tekfufu/mini-R2D2/Flex Wheels/Mini Flex Wheel Print Settings.txt

Print Settings (no supports needed)

Wheel
PLA+ or similar
30% infill and 3 walls minimum

Flex Tyre
I used Flex filament, rubber like filament or similar
Pretty much print it solid as they are so small
