tekfufu/mini-R2D2/Flex Wheels/image 1.png

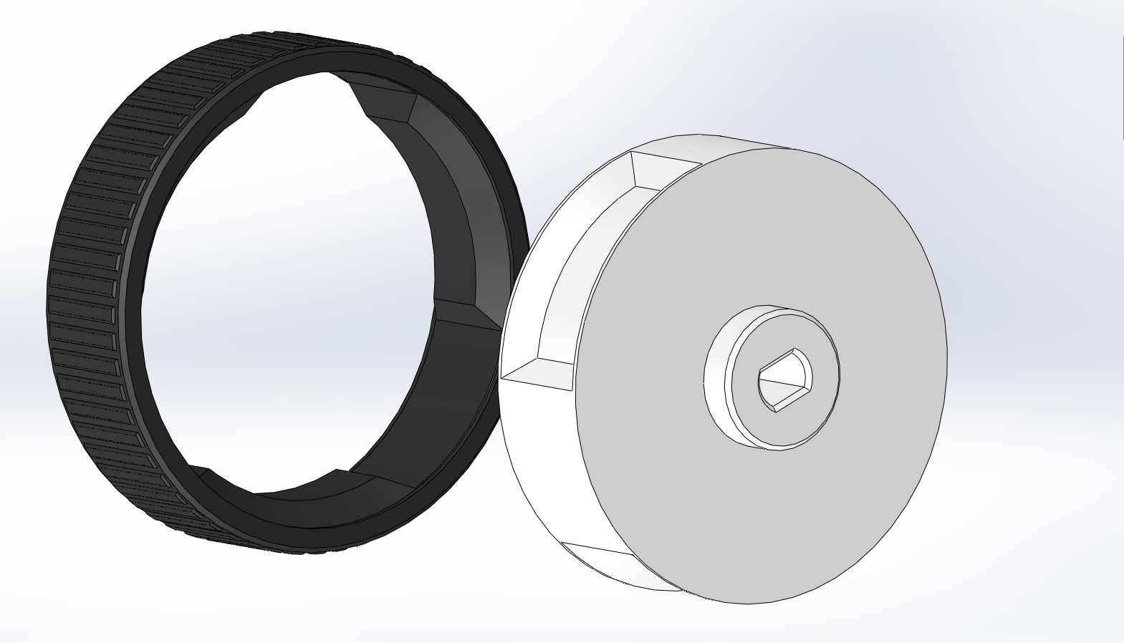
Flex Wheels/image 1.png
