tekfufu/mini-R2D2/Flex Wheels/image.png

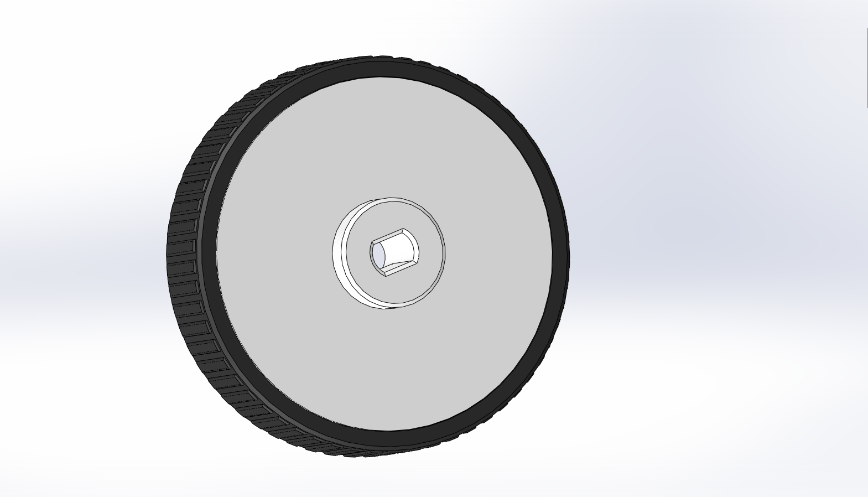
Flex Wheels/image.png
