tekfufu/mini-R2D2/Mini 2-3-2 R2-D2/Reference Images/Mini 2-3-2 2.JPG

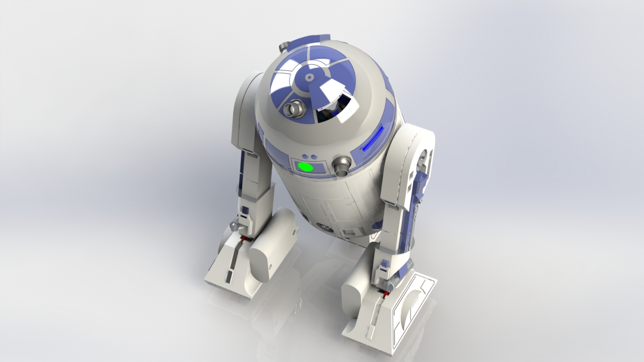
Mini 2-3-2 R2-D2/Reference Images/Mini 2-3-2 2.JPG
