tekfufu/mini-R2D2/Mini 2-3-2 R2-D2/Reference Images/Periscope 1.JPG

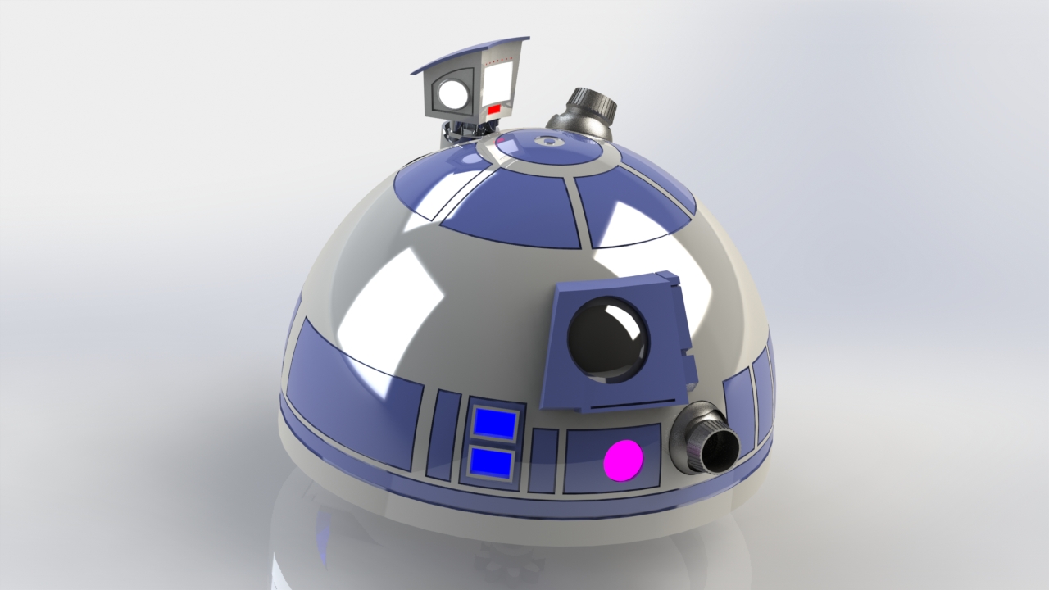
Mini 2-3-2 R2-D2/Reference Images/Periscope 1.JPG
