tekfufu/mini-R2D2/Mini 2-3-2 R2-D2/STL_s/Dome with Periscope/Moveable Holos/Moveable Holo.JPG

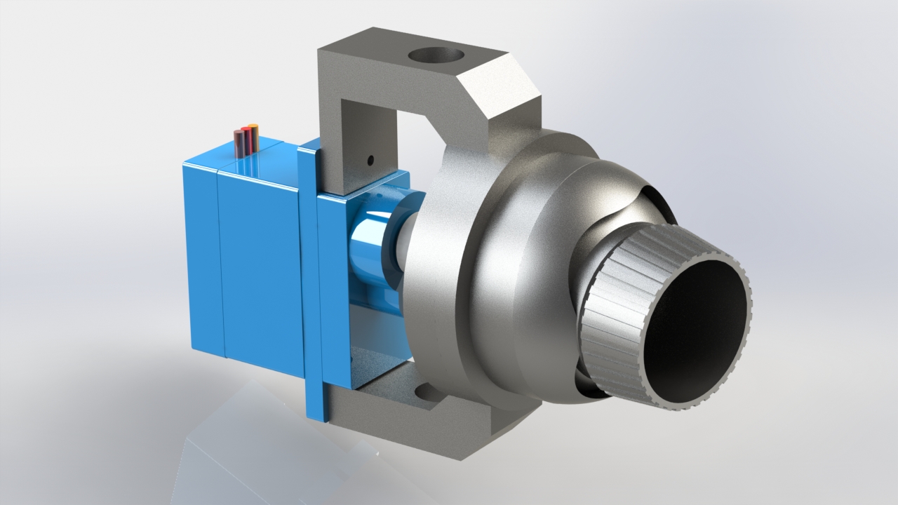
Mini 2-3-2 R2-D2/STL_s/Dome with Periscope/Moveable Holos/Moveable Holo.JPG
