tekfufu/mini-R2D2/Mini 2-3-2 R2-D2/STL_s/Omniwheels/image.png

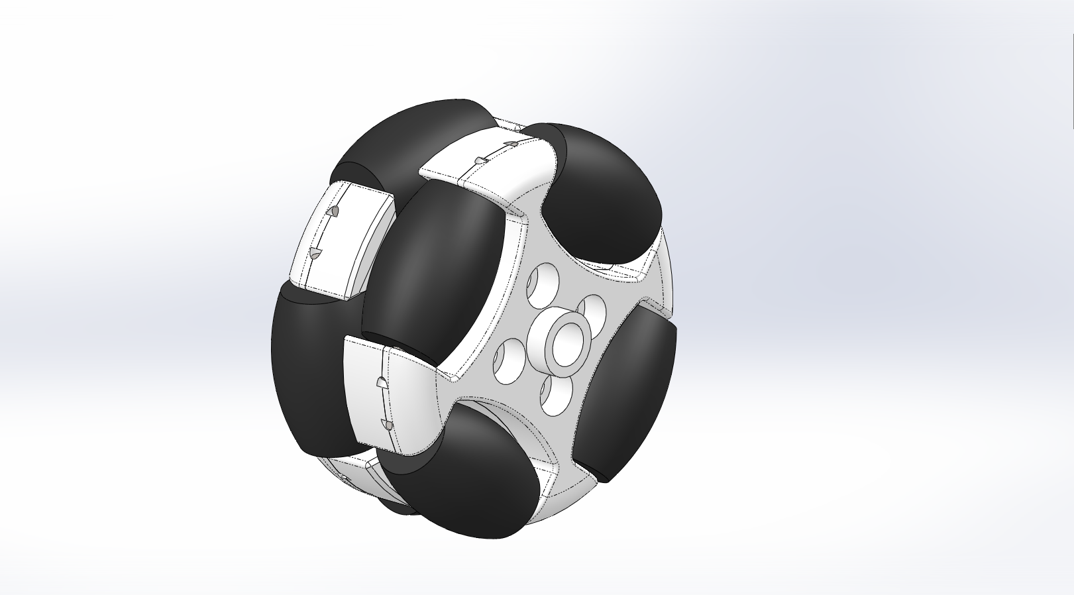
Mini 2-3-2 R2-D2/STL_s/Omniwheels/image.png
