tekfufu/mini-R2D2/Mini R2/R2 Body with moveable front arms/R2 Front Arm.png

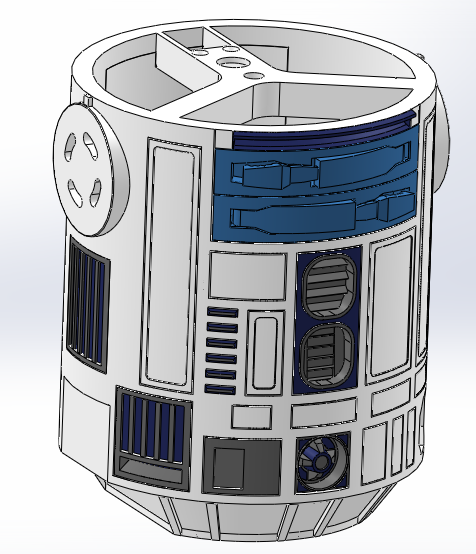
Mini R2/R2 Body with moveable front arms/R2 Front Arm.png
