tekfufu/mini-R2D2/Mini R2/R2 Body/R2-D2 Body.JPG

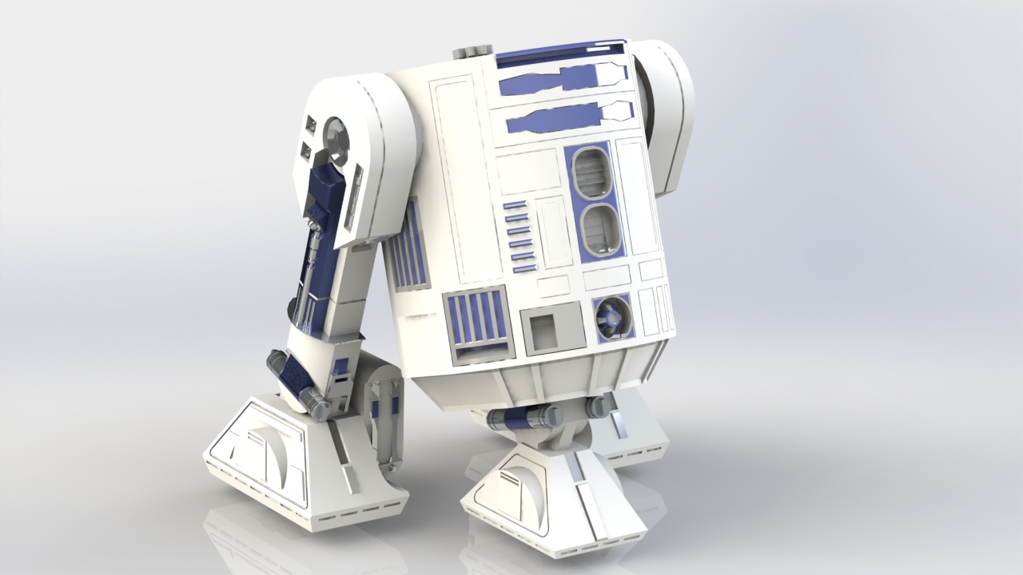
Mini R2/R2 Body/R2-D2 Body.JPG
