tekfufu/mini-R2D2/Mini R2/R2 Dome with LED lights/IMG_8397.JPG

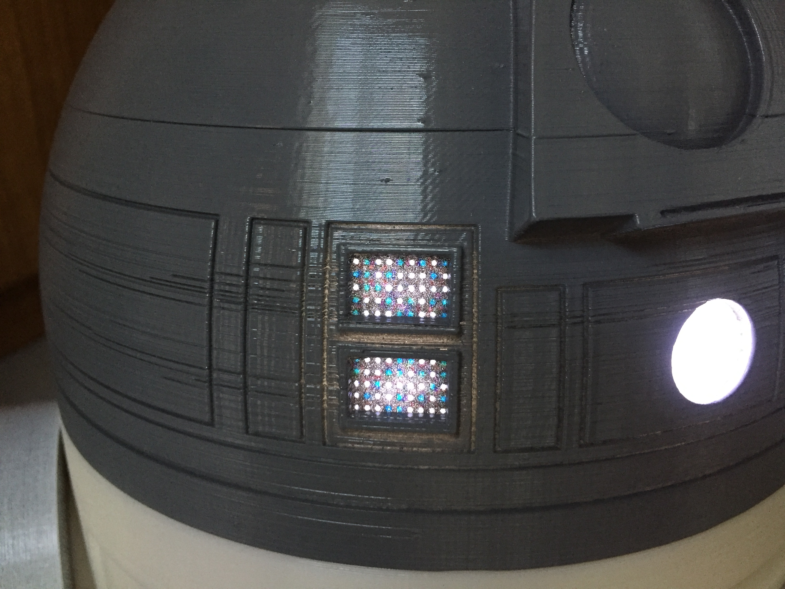
Mini R2/R2 Dome with LED lights/IMG_8397.JPG
