tekfufu/mini-R2D2/Mini R2/R2 Dome/R2 Mini Dome 2.JPG

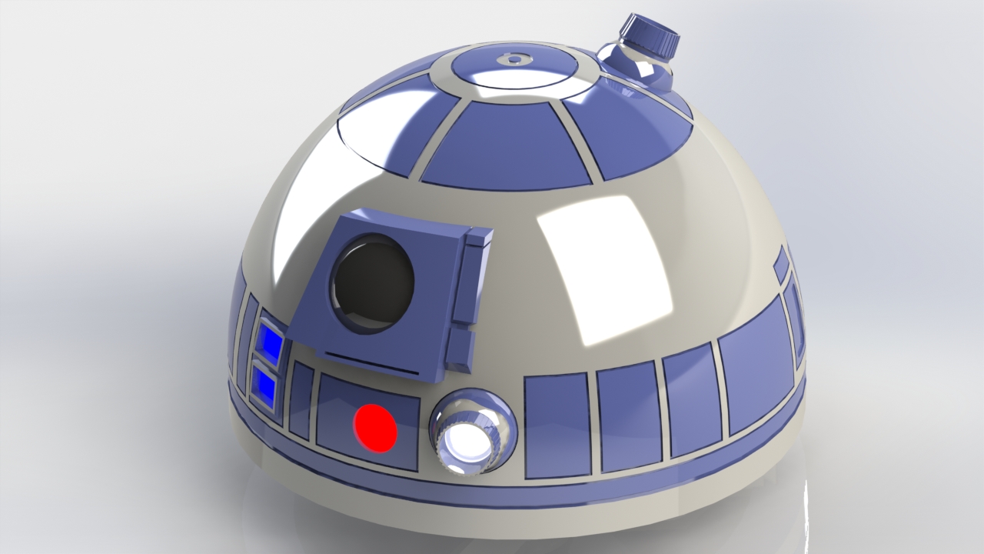
Mini R2/R2 Dome/R2 Mini Dome 2.JPG
