tekfufu/mini-R2D2/Mini R2/R2-D2 2.JPG

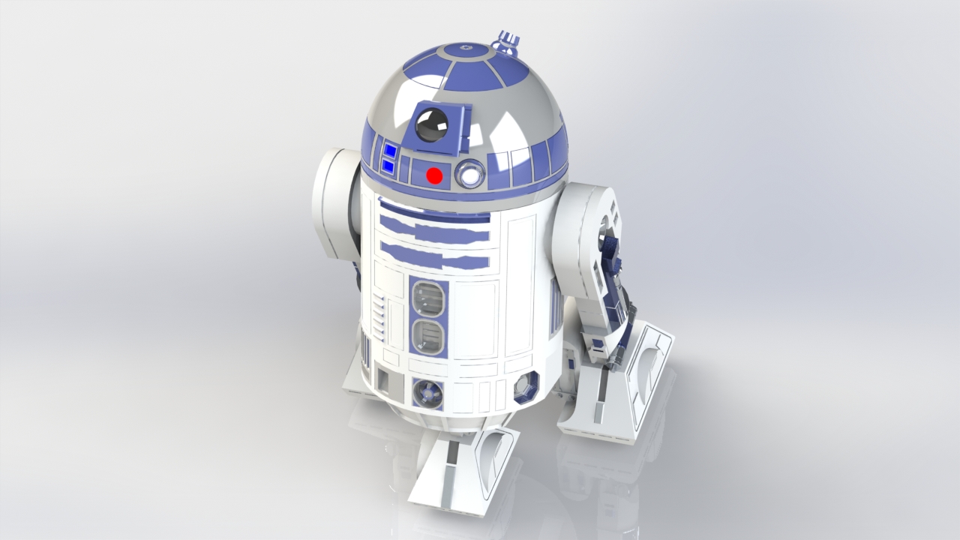
Mini R2/R2-D2 2.JPG
