tekfufu/mini-R2D2/Mini R2/Reference Images/3.jpg

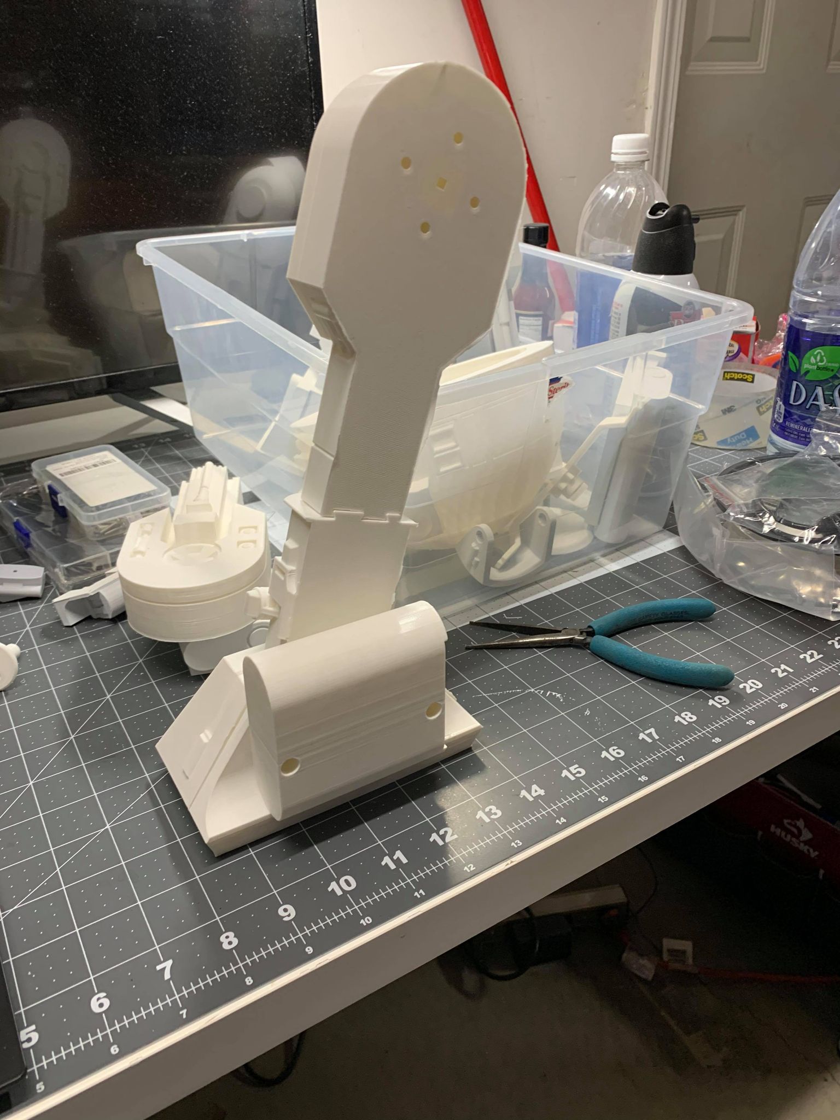
Mini R2/Reference Images/3.jpg
