tekfufu/mini-R2D2/Mini R2/Reference Images/5.jpg

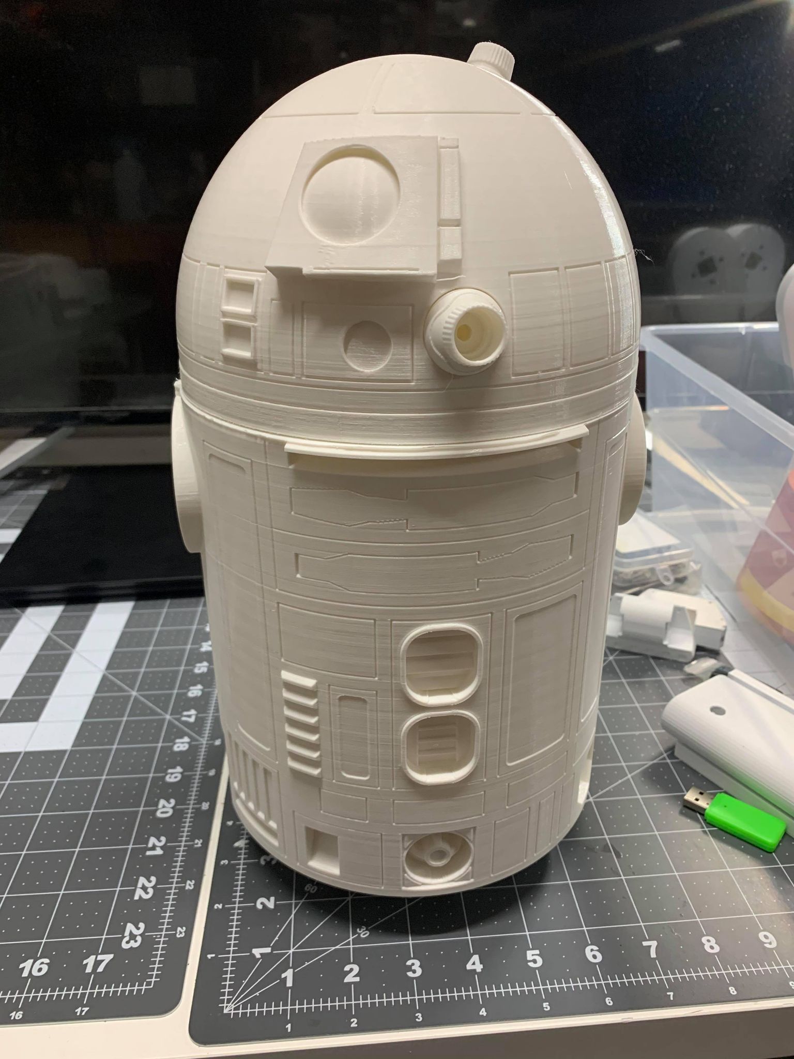
Mini R2/Reference Images/5.jpg
