tekfufu/mini-R2D2/Phone App and Arduino Code/The Gang 16.JPG

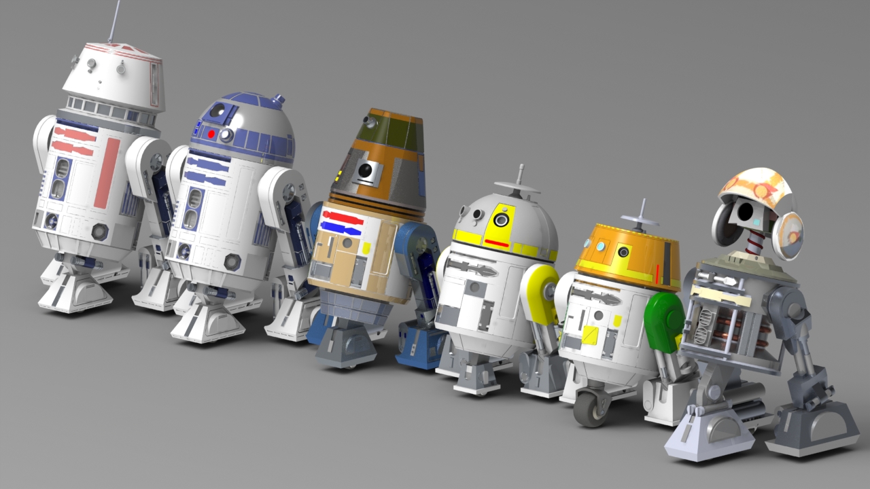
Phone App and Arduino Code/The Gang 16.JPG
