tekfufu/mini-R2D2/RC Control Code/image.png

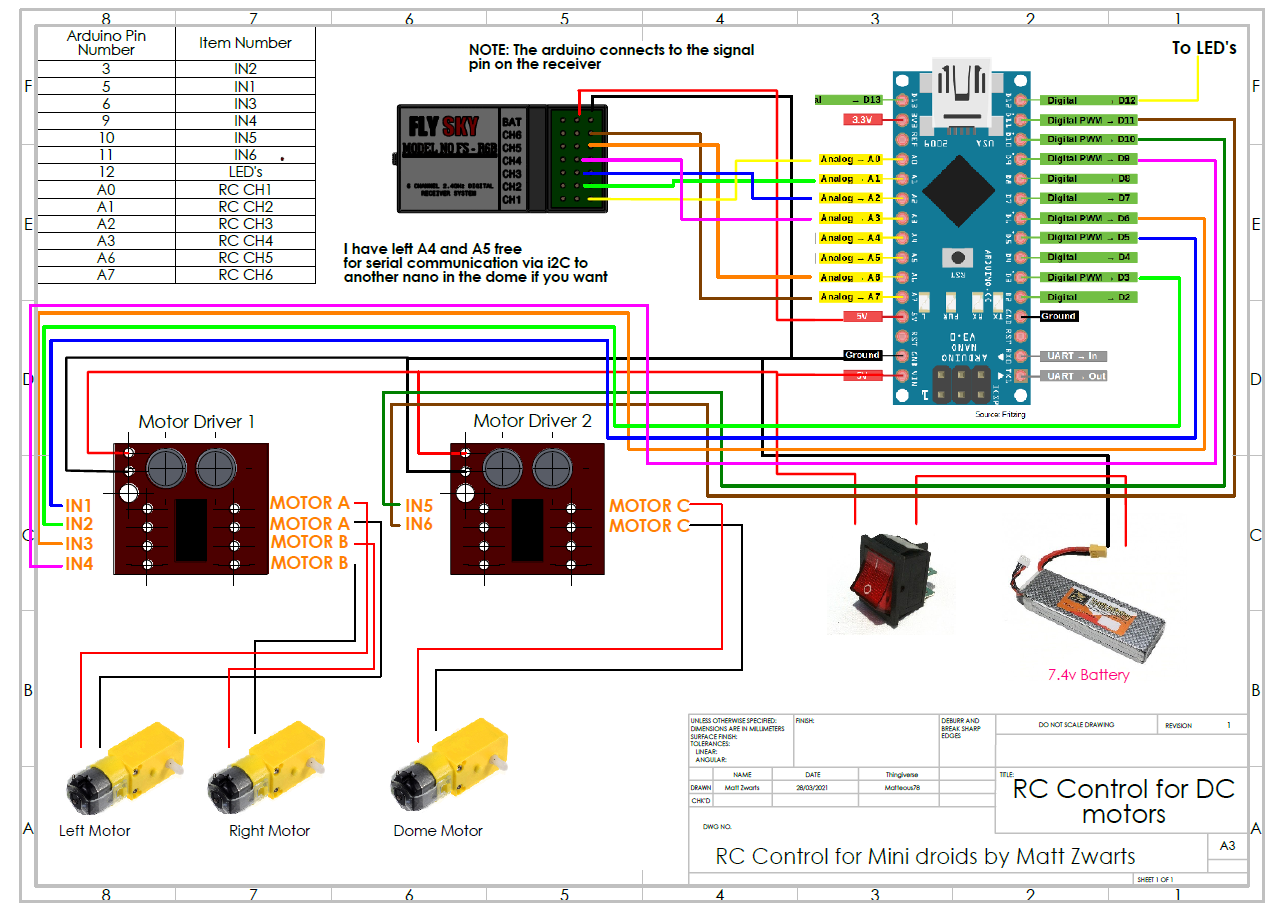
RC Control Code/image.png
