tekfufu/mini-R2D2/Mini 2-3-2 R2-D2/STL_s/Body/Leg Tilt Main Cross Brace.STL

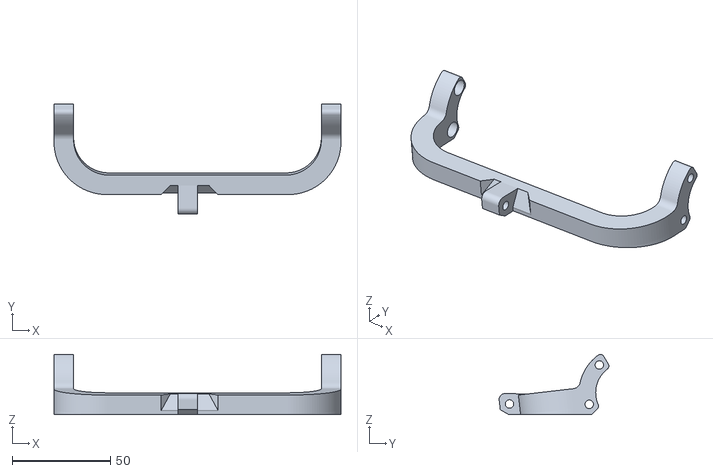
[picture p37: CAD file, 2023-01-24]
Mini 2-3-2 R2-D2/STL_s/Body/Leg Tilt Main Cross Brace.STL
146.0 x 55.8 x 30.6
