tekfufu/mini-R2D2/Mini 2-3-2 R2-D2/STL_s/Dome with Periscope/Periscope Main Body.STL

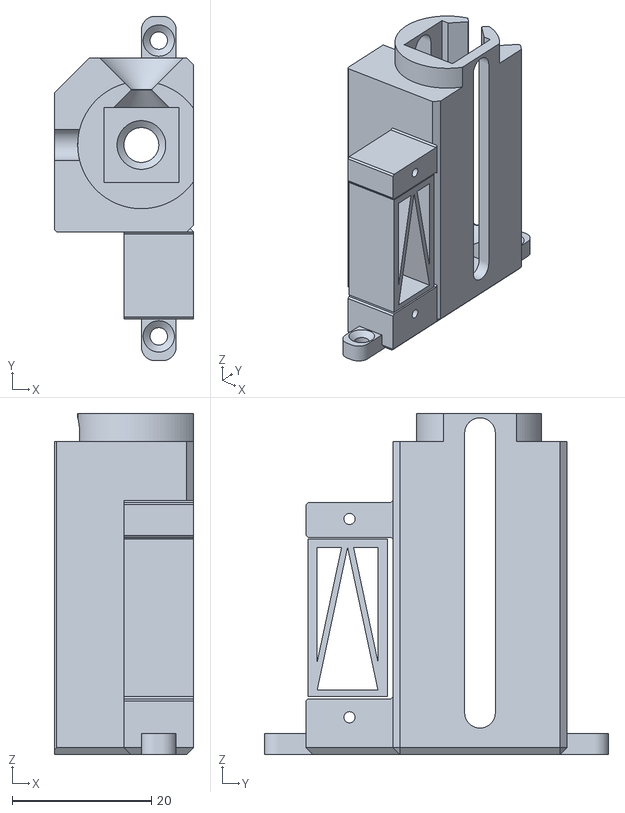
[picture p38: CAD file, 2023-01-24]
Mini 2-3-2 R2-D2/STL_s/Dome with Periscope/Periscope Main Body.STL
20.0 x 49.5 x 49.0
