tekfufu/mini-R2D2/Flex Wheels/Wheel.STL

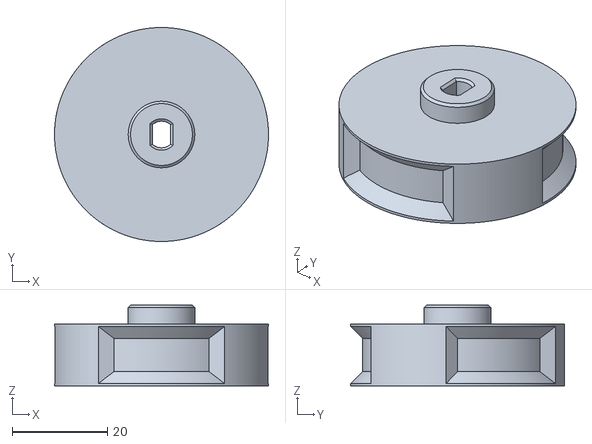
[picture p39: CAD file, 2023-01-24]
Flex Wheels/Wheel.STL
45.0 x 45.0 x 17.0
