tekfufu/mini-R2D2/Mini 2-3-2 R2-D2/Resin Print Cut by Christophe Kormann/Battery Box/Left/PLA/Body3.stl

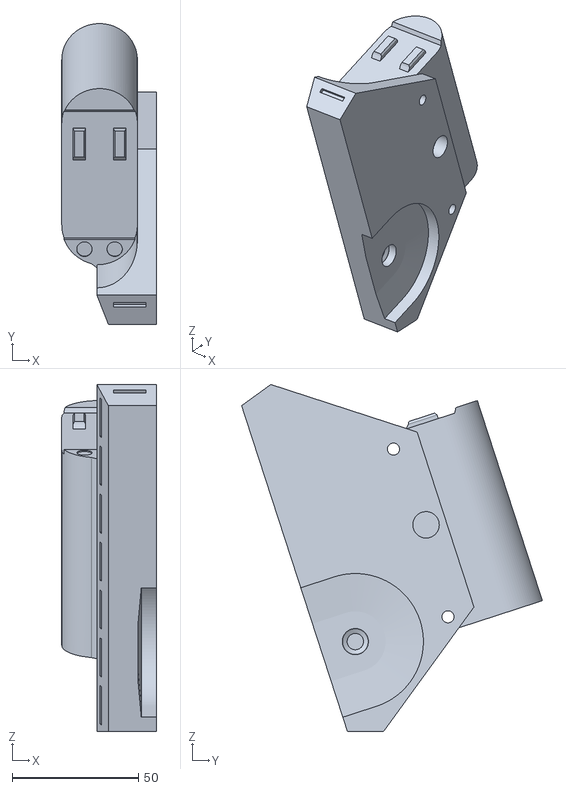
[picture p40: CAD file, 2023-01-24]
Mini 2-3-2 R2-D2/Resin Print Cut by Christophe Kormann/Battery Box/Left/PLA/Body3.stl
37.5 x 119.4 x 137.7
