tekfufu/mini-R2D2/Mini 2-3-2 R2-D2/Resin Print Cut by Christophe Kormann/Battery Box/Left/Resin/Body18-X4.stl

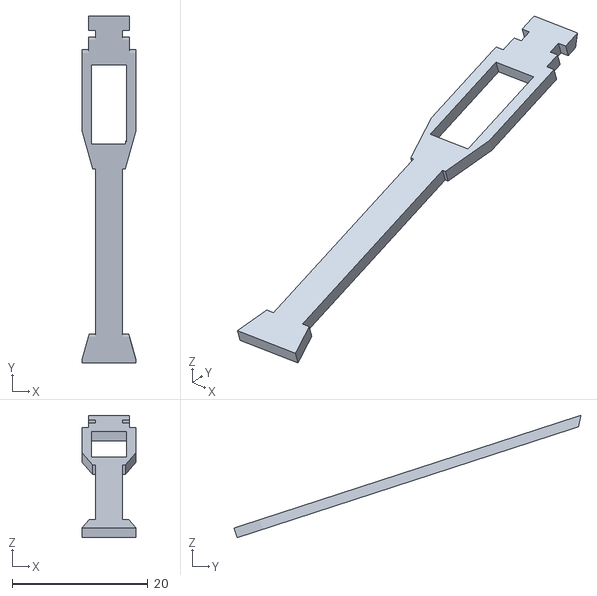
[picture p41: CAD file, 2023-01-24]
Mini 2-3-2 R2-D2/Resin Print Cut by Christophe Kormann/Battery Box/Left/Resin/Body18-X4.stl
8.00 x 51.1 x 18.0
