tekfufu/mini-R2D2/Mini 2-3-2 R2-D2/Resin Print Cut by Christophe Kormann/Battery Box/Right/Resin/Body20 X2.stl

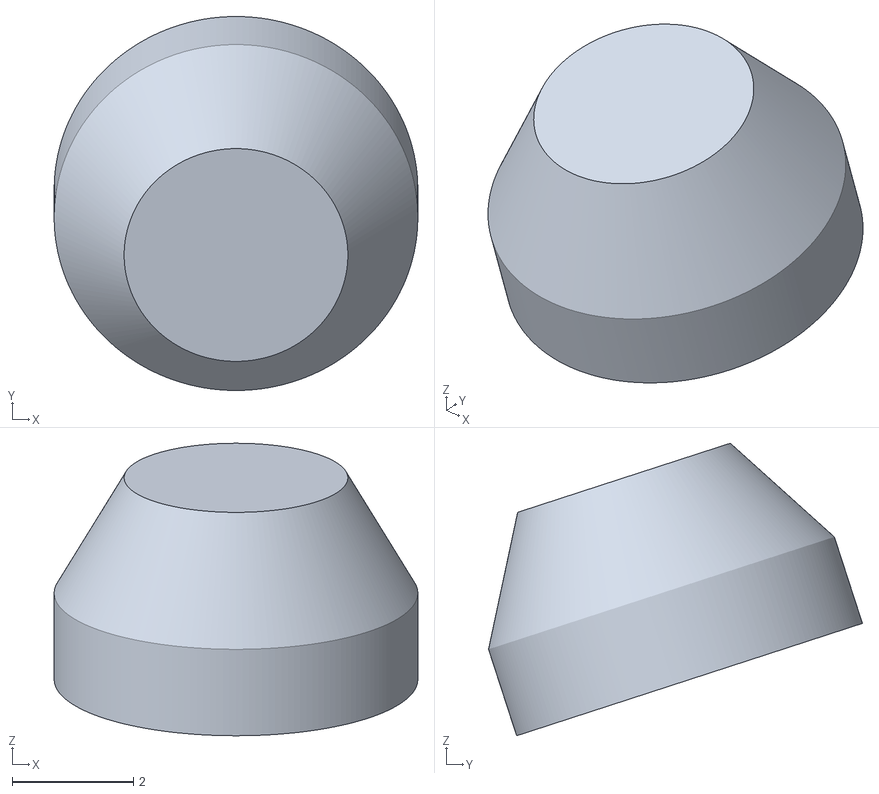
[picture p42: CAD file, 2023-01-24]
Mini 2-3-2 R2-D2/Resin Print Cut by Christophe Kormann/Battery Box/Right/Resin/Body20 X2.stl
6.00 x 6.17 x 4.83
