tekfufu/mini-R2D2/Mini 2-3-2 R2-D2/Resin Print Cut by Christophe Kormann/Body/PLA/Body Built in support.stl

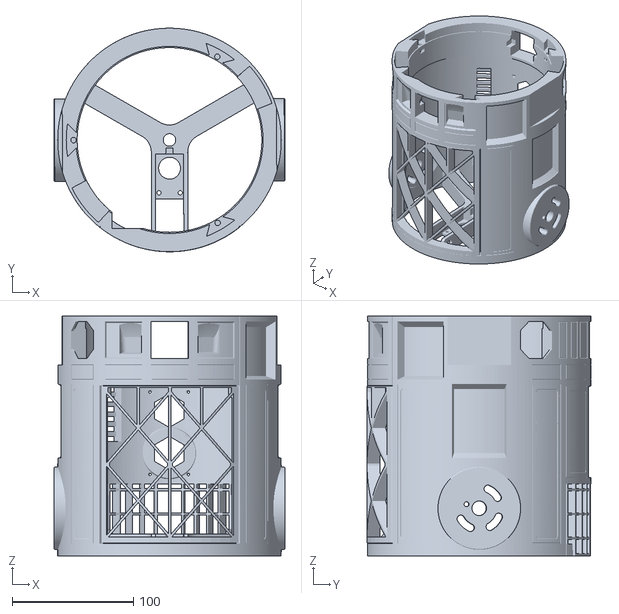
[picture p43: CAD file, 2023-01-24]
Mini 2-3-2 R2-D2/Resin Print Cut by Christophe Kormann/Body/PLA/Body Built in support.stl
190.1 x 184.1 x 197.2
