tekfufu/mini-R2D2/Mini 2-3-2 R2-D2/Resin Print Cut by Christophe Kormann/Body/Resin/Body165.stl

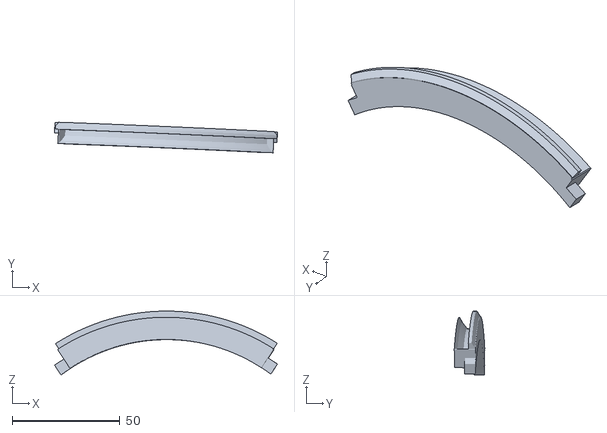
[picture p44: CAD file, 2023-01-24]
Mini 2-3-2 R2-D2/Resin Print Cut by Christophe Kormann/Body/Resin/Body165.stl
103.6 x 14.2 x 29.6
