tekfufu/mini-R2D2/Mini 2-3-2 R2-D2/Resin Print Cut by Christophe Kormann/Centre Footshell/PLA/Body1.stl

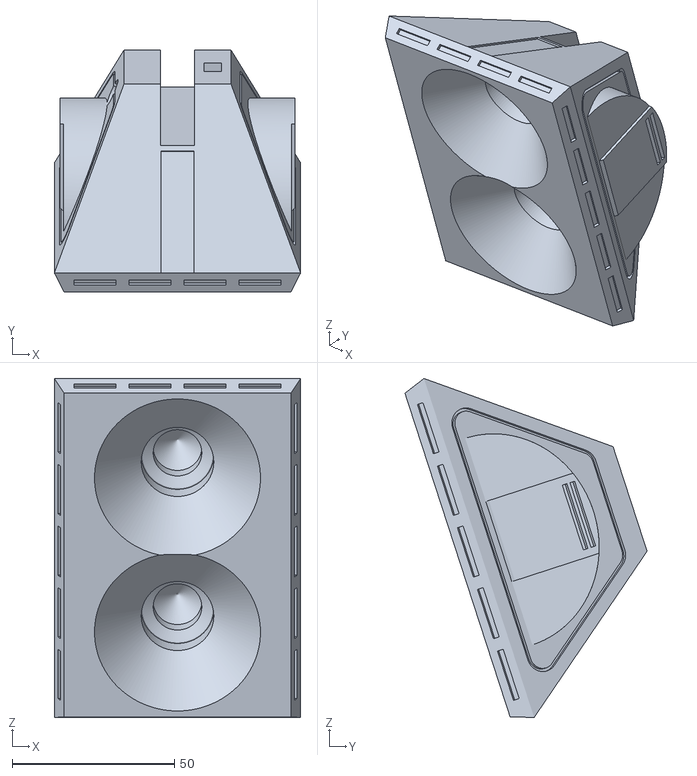
[picture p45: CAD file, 2023-01-24]
Mini 2-3-2 R2-D2/Resin Print Cut by Christophe Kormann/Centre Footshell/PLA/Body1.stl
76.0 x 74.7 x 104.6
