tekfufu/mini-R2D2/Mini 2-3-2 R2-D2/Resin Print Cut by Christophe Kormann/Centre Footshell/Resin/Body3.stl

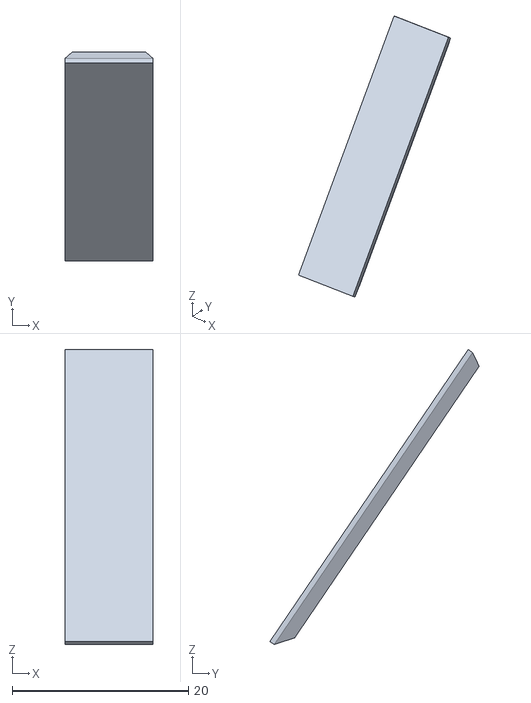
[picture p46: CAD file, 2023-01-24]
Mini 2-3-2 R2-D2/Resin Print Cut by Christophe Kormann/Centre Footshell/Resin/Body3.stl
10.0 x 23.7 x 33.4
