tekfufu/mini-R2D2/Mini 2-3-2 R2-D2/Resin Print Cut by Christophe Kormann/Dome/PLA/Small logic bottom.stl

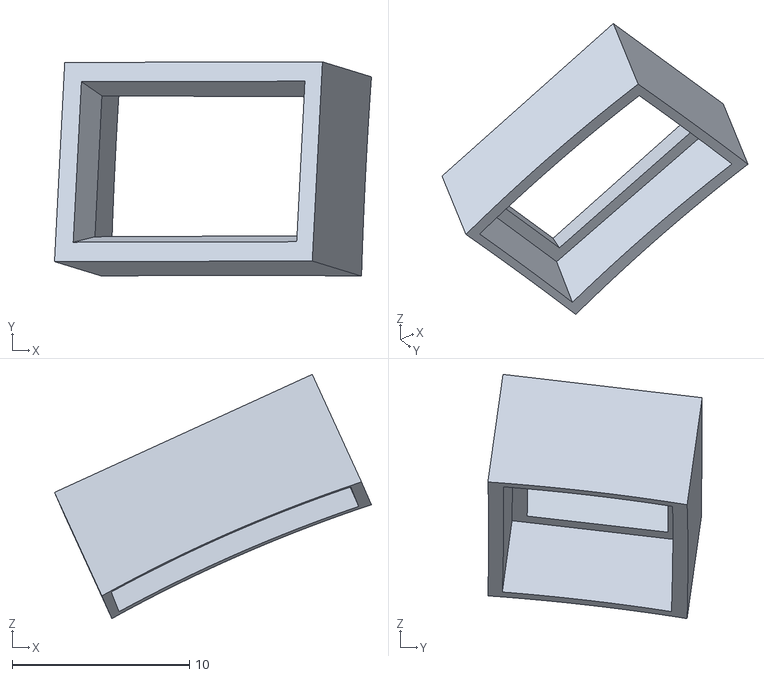
[picture p47: CAD file, 2023-01-24]
Mini 2-3-2 R2-D2/Resin Print Cut by Christophe Kormann/Dome/PLA/Small logic bottom.stl
17.9 x 12.1 x 13.8
