tekfufu/mini-R2D2/Mini 2-3-2 R2-D2/Resin Print Cut by Christophe Kormann/Dome/Resin/Body81.stl

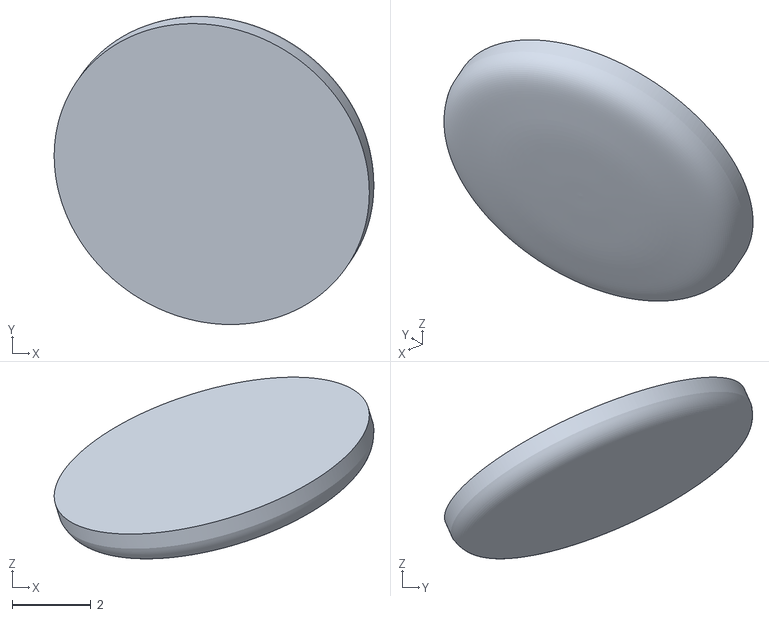
[picture p48: CAD file, 2023-01-24]
Mini 2-3-2 R2-D2/Resin Print Cut by Christophe Kormann/Dome/Resin/Body81.stl
8.10 x 7.81 x 4.61
