tekfufu/mini-R2D2/Mini 2-3-2 R2-D2/Resin Print Cut by Christophe Kormann/Legs/Left/PLA/Body35.stl

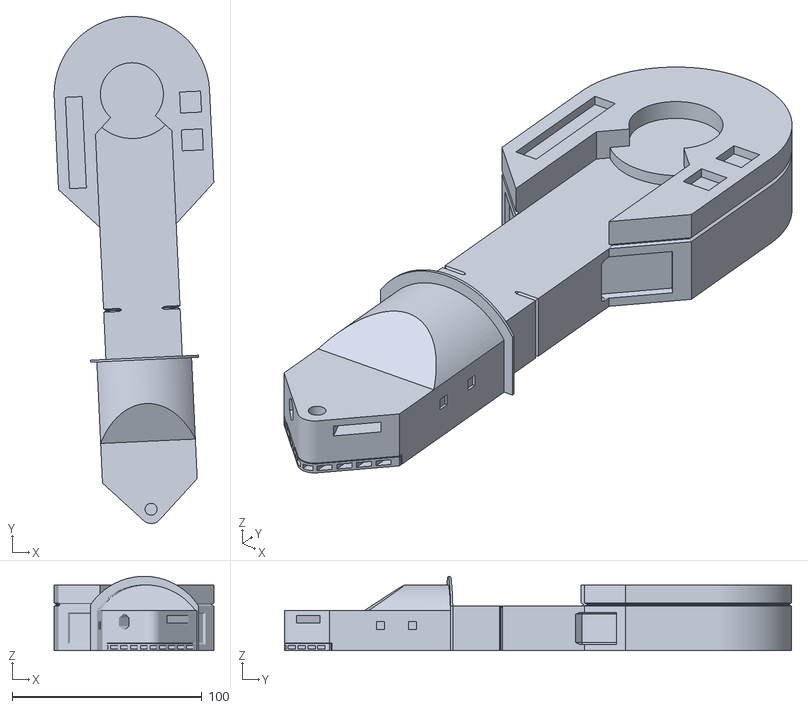
[picture p49: CAD file, 2023-01-24]
Mini 2-3-2 R2-D2/Resin Print Cut by Christophe Kormann/Legs/Left/PLA/Body35.stl
84.2 x 267.3 x 39.2
