tekfufu/mini-R2D2/Mini 2-3-2 R2-D2/Resin Print Cut by Christophe Kormann/Legs/Left/Resin/Body16.stl

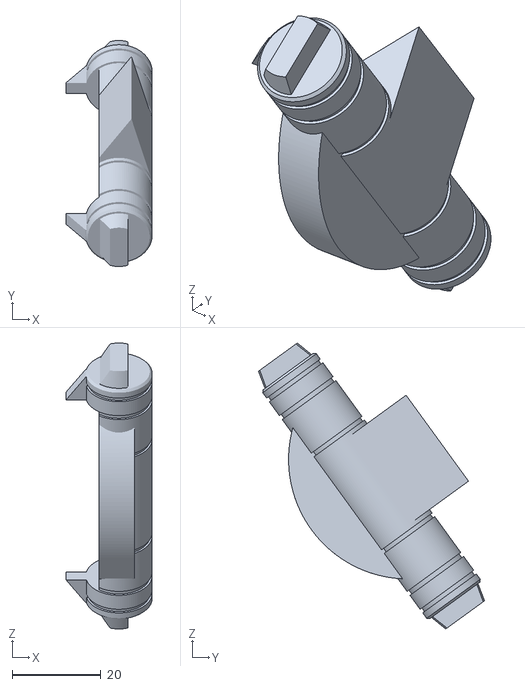
[picture p50: CAD file, 2023-01-24]
Mini 2-3-2 R2-D2/Resin Print Cut by Christophe Kormann/Legs/Left/Resin/Body16.stl
19.5 x 51.1 x 64.6
