tekfufu/mini-R2D2/Mini 2-3-2 R2-D2/Resin Print Cut by Christophe Kormann/Legs/Right/PLA/Body1.stl

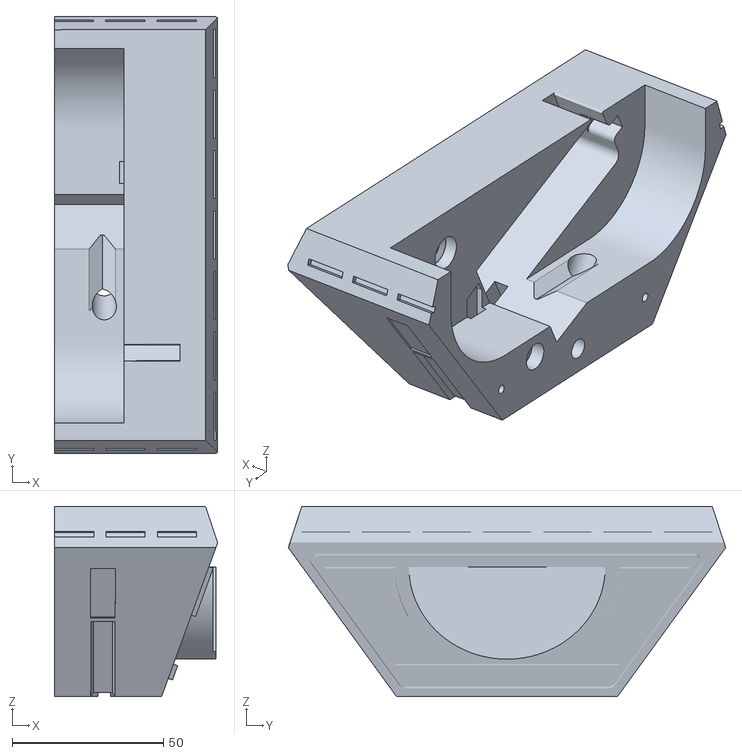
[picture p51: CAD file, 2023-01-24]
Mini 2-3-2 R2-D2/Resin Print Cut by Christophe Kormann/Legs/Right/PLA/Body1.stl
54.1 x 144.8 x 62.9
