tekfufu/mini-R2D2/Mini 2-3-2 R2-D2/Resin Print Cut by Christophe Kormann/Legs/Right/Resin/Body56.stl

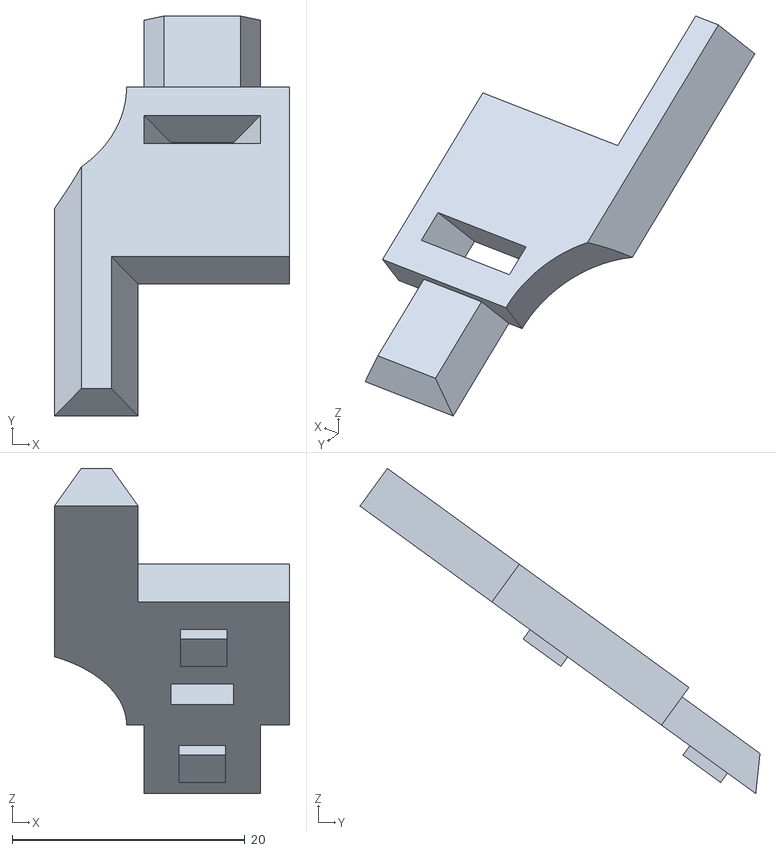
[picture p52: CAD file, 2023-01-24]
Mini 2-3-2 R2-D2/Resin Print Cut by Christophe Kormann/Legs/Right/Resin/Body56.stl
20.2 x 34.3 x 27.9
