tekfufu/mini-R2D2/Mini 2-3-2 R2-D2/STL_s/Body/Body with no built in supports/MZ R2_D2_Body_2-3-2 No Supports.STL

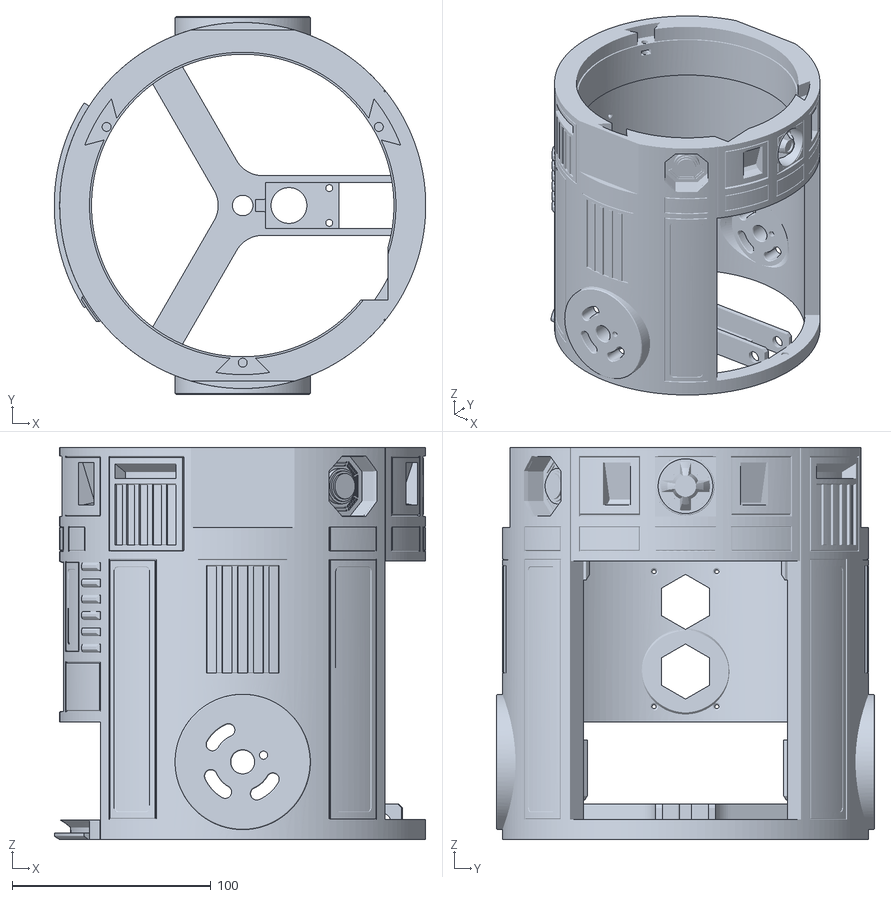
[picture p53: CAD file, 2023-01-24]
Mini 2-3-2 R2-D2/STL_s/Body/Body with no built in supports/MZ R2_D2_Body_2-3-2 No Supports.STL
186.7 x 190.0 x 197.2
