tekfufu/mini-R2D2/Mini 2-3-2 R2-D2/STL_s/Body/Electronics Mount.STL

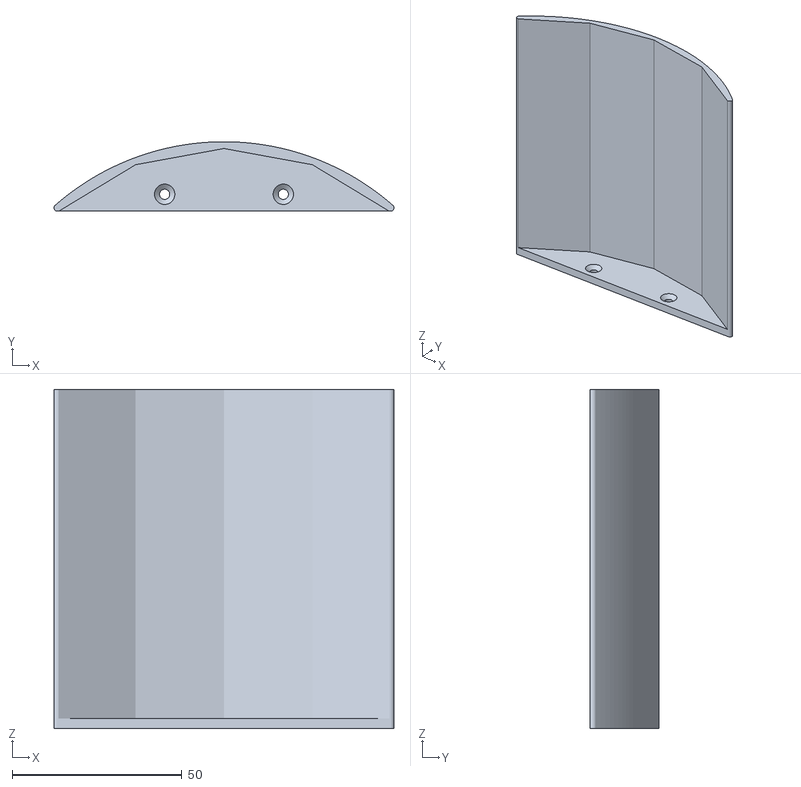
[picture p54: CAD file, 2023-01-24]
Mini 2-3-2 R2-D2/STL_s/Body/Electronics Mount.STL
100.3 x 20.5 x 100.0
