tekfufu/mini-R2D2/Mini 2-3-2 R2-D2/STL_s/Centre Lift/Linear Rail 8mm Hex x4.STL

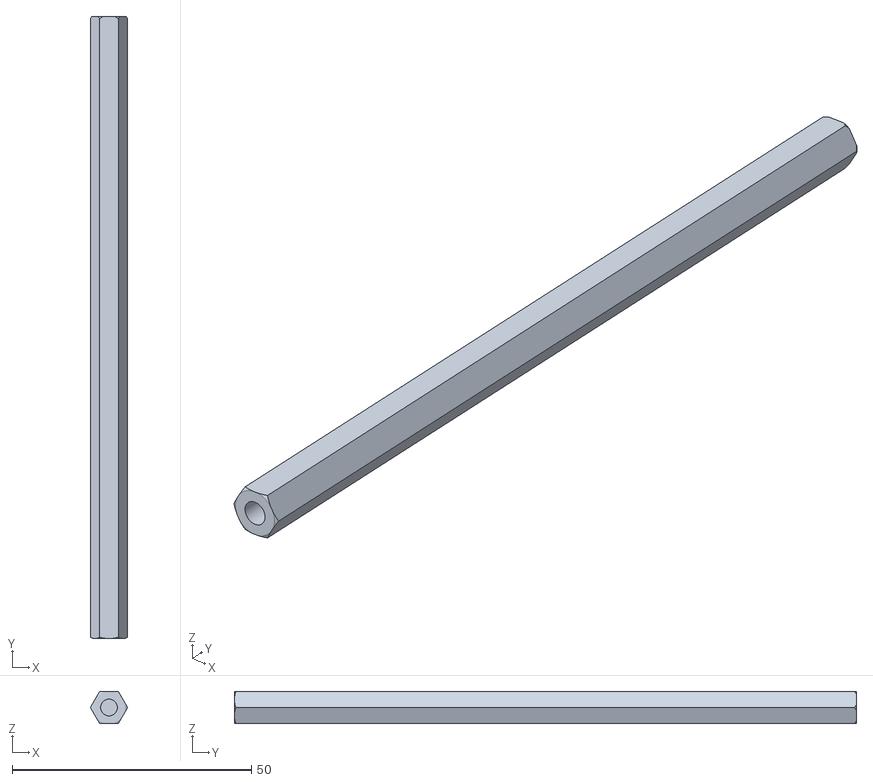
[picture p55: CAD file, 2023-01-24]
Mini 2-3-2 R2-D2/STL_s/Centre Lift/Linear Rail 8mm Hex x4.STL
7.80 x 130.0 x 6.75
