tekfufu/mini-R2D2/Mini 2-3-2 R2-D2/STL_s/Centre Lift/Optional Crank arms for various servo horns/Crank A Servo - Small servo horn.STL

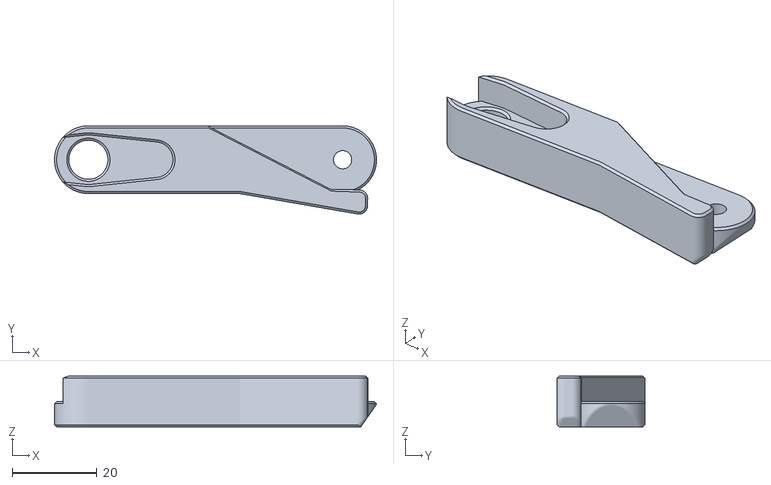
[picture p56: CAD file, 2023-01-24]
Mini 2-3-2 R2-D2/STL_s/Centre Lift/Optional Crank arms for various servo horns/Crank A Servo - Small servo horn.STL
76.0 x 20.8 x 12.0
