tekfufu/mini-R2D2/Mini 2-3-2 R2-D2/STL_s/Dome with Periscope/LED inserts/Front Logic 2.STL

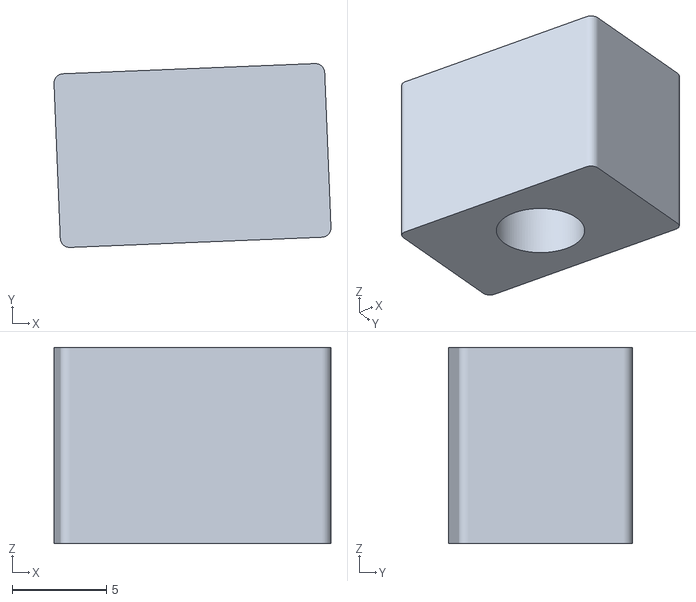
[picture p57: CAD file, 2023-01-24]
Mini 2-3-2 R2-D2/STL_s/Dome with Periscope/LED inserts/Front Logic 2.STL
14.7 x 9.75 x 10.4
