tekfufu/mini-R2D2/Mini 2-3-2 R2-D2/STL_s/Dome with Periscope/Moveable Holos/R2 Holo Ball 5mm LED.STL

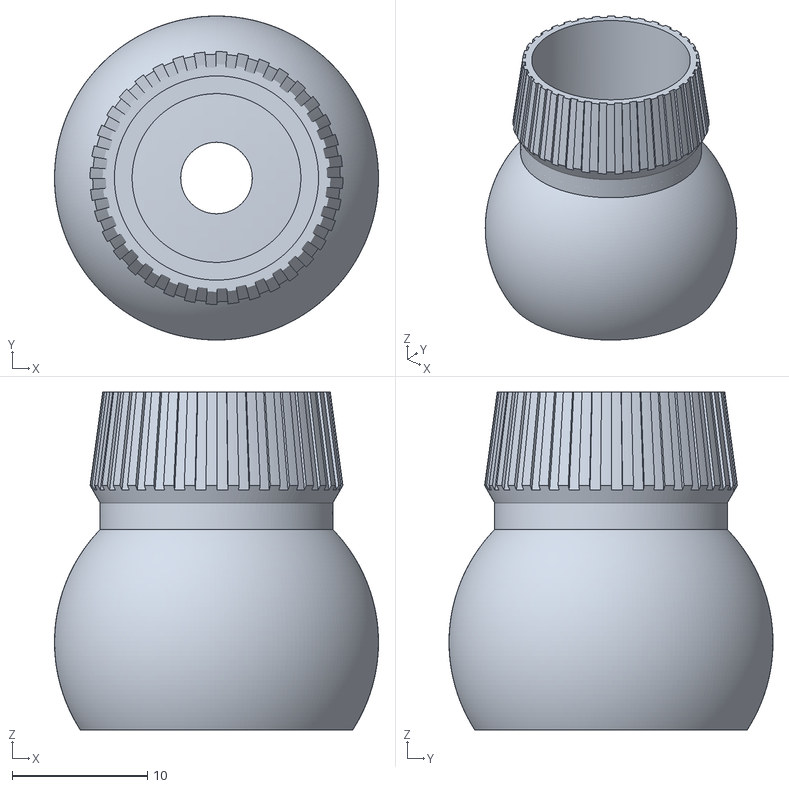
[picture p58: CAD file, 2023-01-24]
Mini 2-3-2 R2-D2/STL_s/Dome with Periscope/Moveable Holos/R2 Holo Ball 5mm LED.STL
24.0 x 24.0 x 25.0
