tekfufu/mini-R2D2/Mini 2-3-2 R2-D2/STL_s/Dome with Periscope/R2 Mini Periscope -Lid_s v2.STL

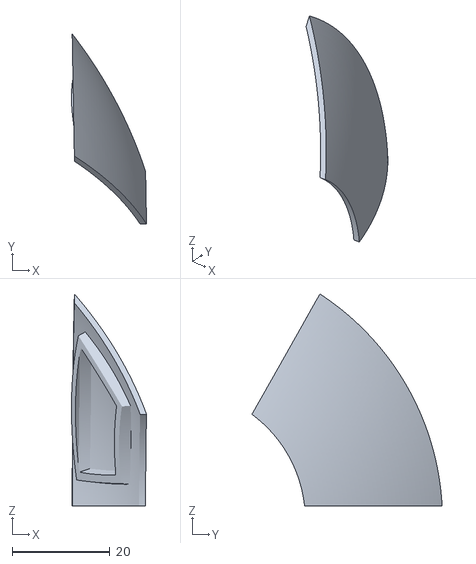
[picture p59: CAD file, 2023-01-24]
Mini 2-3-2 R2-D2/STL_s/Dome with Periscope/R2 Mini Periscope -Lid_s v2.STL
15.4 x 39.0 x 43.5
