tekfufu/mini-R2D2/Mini 2-3-2 R2-D2/STL_s/Front Arms/Utilility Arm x2_s.STL

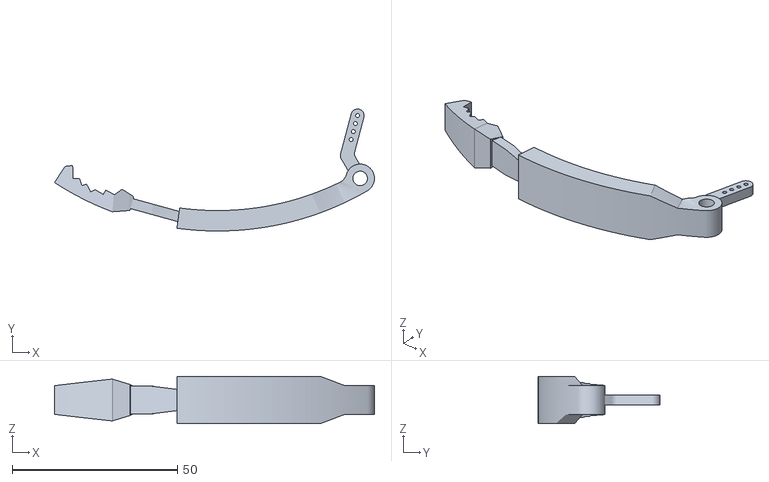
[picture p60: CAD file, 2023-01-24]
Mini 2-3-2 R2-D2/STL_s/Front Arms/Utilility Arm x2_s.STL
96.8 x 36.9 x 14.2
