tekfufu/mini-R2D2/Mini 2-3-2 R2-D2/STL_s/Front Castor Wheels/Front Castor Fork x2.STL

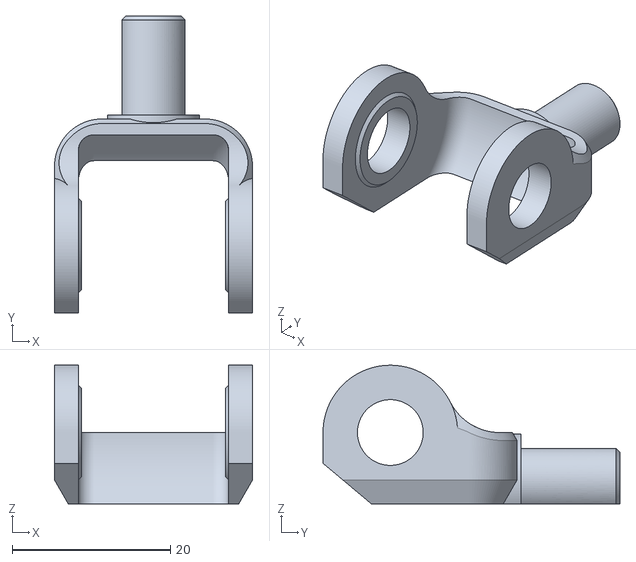
[picture p61: CAD file, 2023-01-24]
Mini 2-3-2 R2-D2/STL_s/Front Castor Wheels/Front Castor Fork x2.STL
25.0 x 37.5 x 17.5
