tekfufu/mini-R2D2/Mini 2-3-2 R2-D2/STL_s/Front Castor Wheels/Looser Fit wheel/r2 castor mod (1).stl

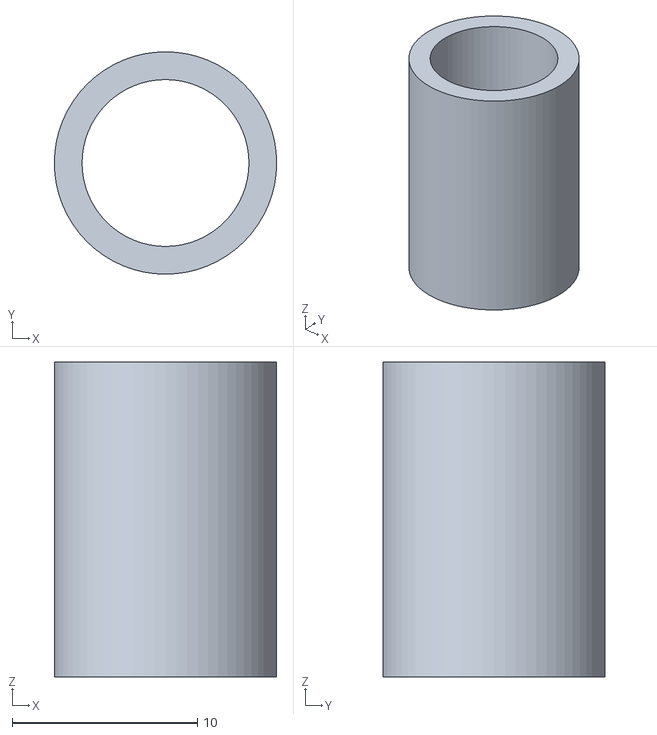
[picture p62: CAD file, 2023-01-24]
Mini 2-3-2 R2-D2/STL_s/Front Castor Wheels/Looser Fit wheel/r2 castor mod (1).stl
12.0 x 12.0 x 17.0
