tekfufu/mini-R2D2/Mini 2-3-2 R2-D2/STL_s/Legs/R2 2-3-2 Left Leg Inner.STL

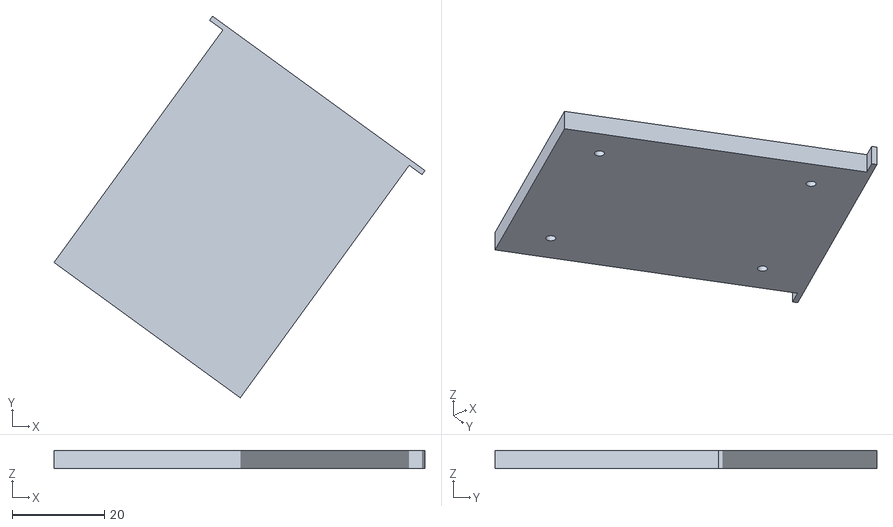
[picture p63: CAD file, 2023-01-24]
Mini 2-3-2 R2-D2/STL_s/Legs/R2 2-3-2 Left Leg Inner.STL
80.6 x 82.9 x 4.00
