tekfufu/mini-R2D2/Mini 2-3-2 R2-D2/STL_s/Omniwheels/Spacer.STL

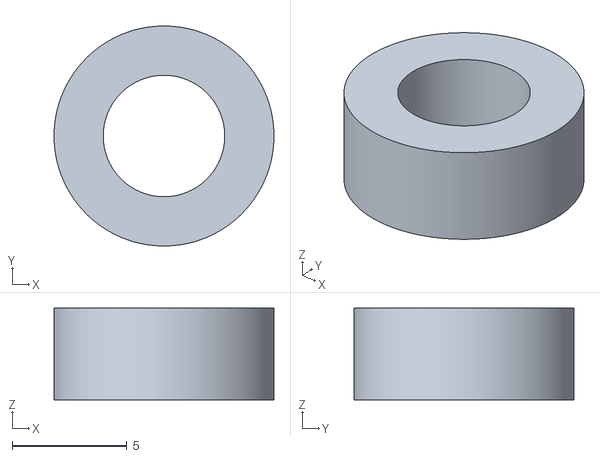
[picture p64: CAD file, 2023-01-24]
Mini 2-3-2 R2-D2/STL_s/Omniwheels/Spacer.STL
9.60 x 9.60 x 4.00
