tekfufu/mini-R2D2/Mini 2-3-2 R2-D2/STL_s/Rubber Wheels/Mini 2-3-2 Flex Tyre.STL

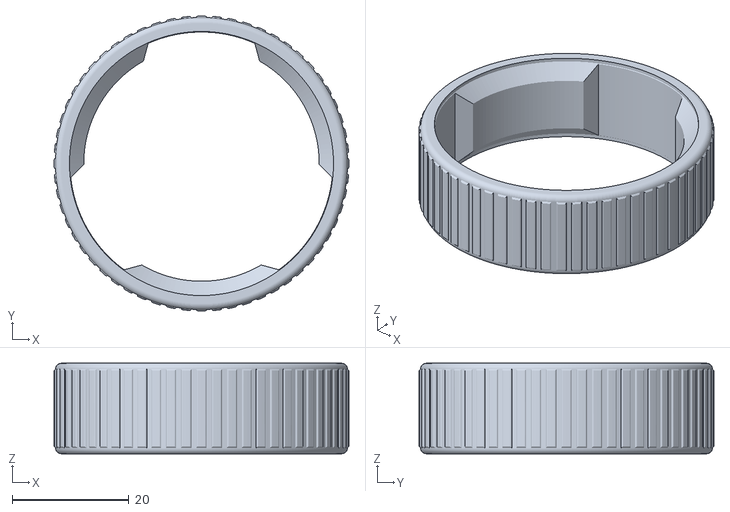
[picture p65: CAD file, 2023-01-24]
Mini 2-3-2 R2-D2/STL_s/Rubber Wheels/Mini 2-3-2 Flex Tyre.STL
50.5 x 50.5 x 15.5
