tekfufu/mini-R2D2/Mini 2-3-2 R2-D2/STL_s/Solid Drive Wheel/Solid Wheel.STL

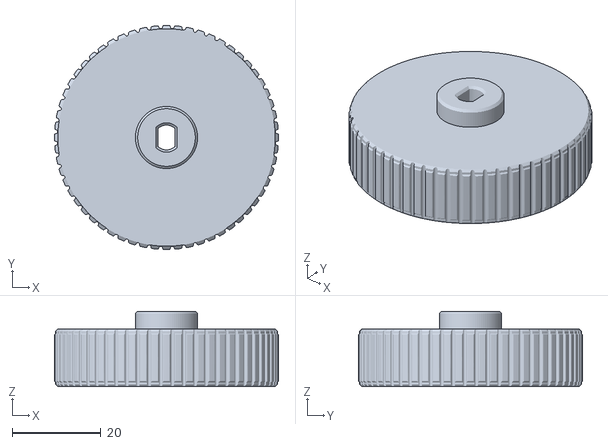
[picture p66: CAD file, 2023-01-24]
Mini 2-3-2 R2-D2/STL_s/Solid Drive Wheel/Solid Wheel.STL
50.5 x 50.5 x 17.0
