tekfufu/mini-R2D2/Mini R2/Moveable Holos/Round Servo Horn.STL

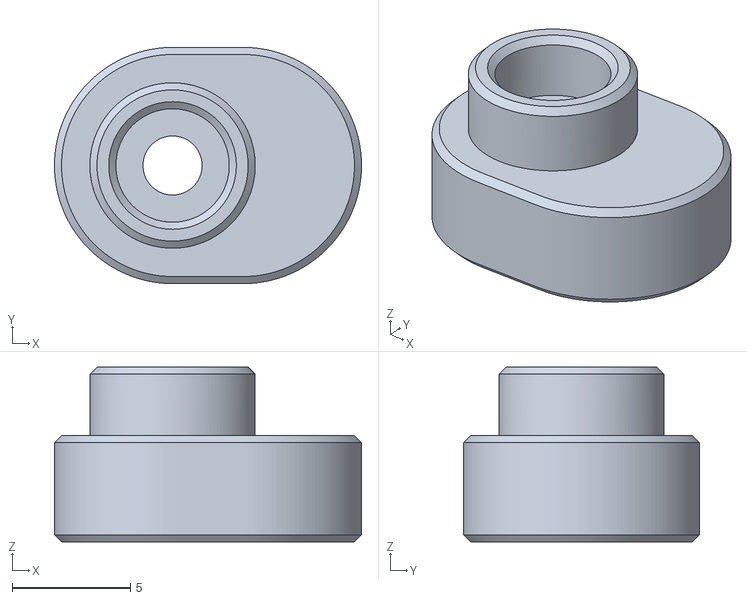
[picture p67: CAD file, 2023-01-24]
Mini R2/Moveable Holos/Round Servo Horn.STL
13.0 x 10.00 x 7.40
