tekfufu/mini-R2D2/Mini R2/R2 Body/MZ R2_D2 Right Leg Lower.STL

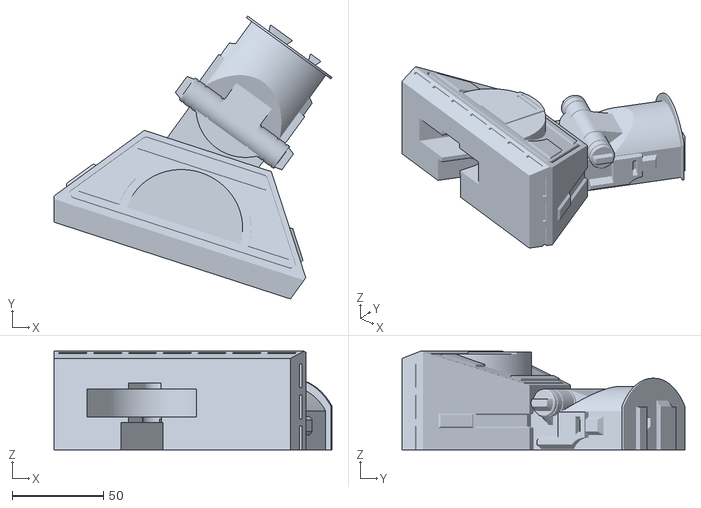
[picture p68: CAD file, 2023-01-24]
Mini R2/R2 Body/MZ R2_D2 Right Leg Lower.STL
152.0 x 154.7 x 54.0
