tekfufu/mini-R2D2/Mini R2/R2 Body/Single Piece Legs/MZ R2_D2 Left Leg.STL

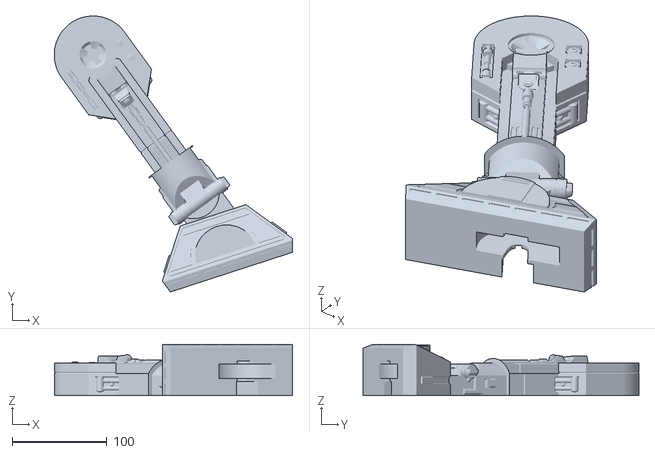
[picture p69: CAD file, 2023-01-24]
Mini R2/R2 Body/Single Piece Legs/MZ R2_D2 Left Leg.STL
251.7 x 291.3 x 54.0
