tekfufu/mini-R2D2/Mini R2/R2 Dome with LED lights/Small PSI.STL

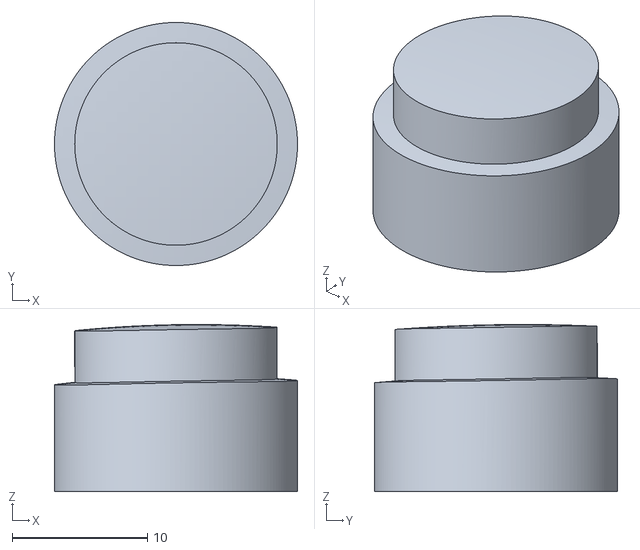
[picture p70: CAD file, 2023-01-24]
Mini R2/R2 Dome with LED lights/Small PSI.STL
18.0 x 18.0 x 12.4
