tekfufu/mini-R2D2/Mini R2/R2 Dome/R2 Dome HoloProjector Lens x 3.STL

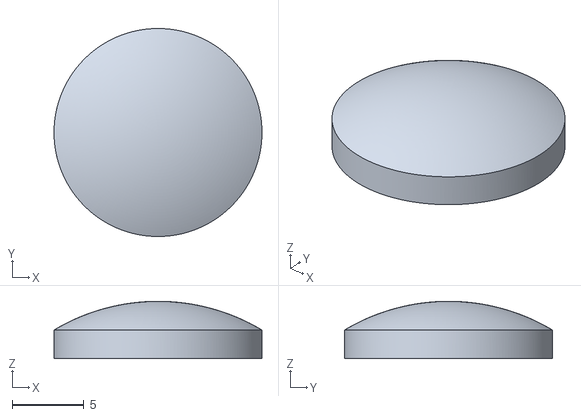
[picture p71: CAD file, 2023-01-24]
Mini R2/R2 Dome/R2 Dome HoloProjector Lens x 3.STL
14.5 x 14.5 x 4.00
