tekfufu/mini-R2D2/Flex Wheels/Flex Tyre.STL

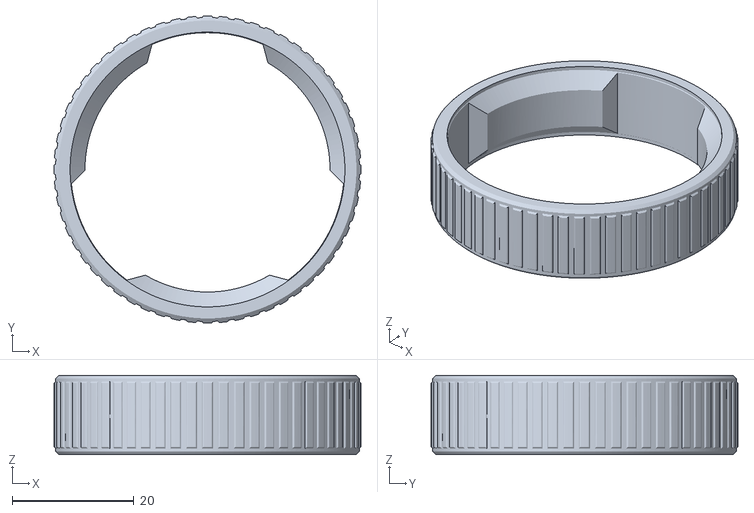
[picture p72: CAD file, 2023-01-24]
Flex Wheels/Flex Tyre.STL
50.5 x 50.5 x 13.0
