tekfufu/mini-R2D2/Mini 2-3-2 R2-D2/Resin Print Cut by Christophe Kormann/Body/PLA/Body No support.stl

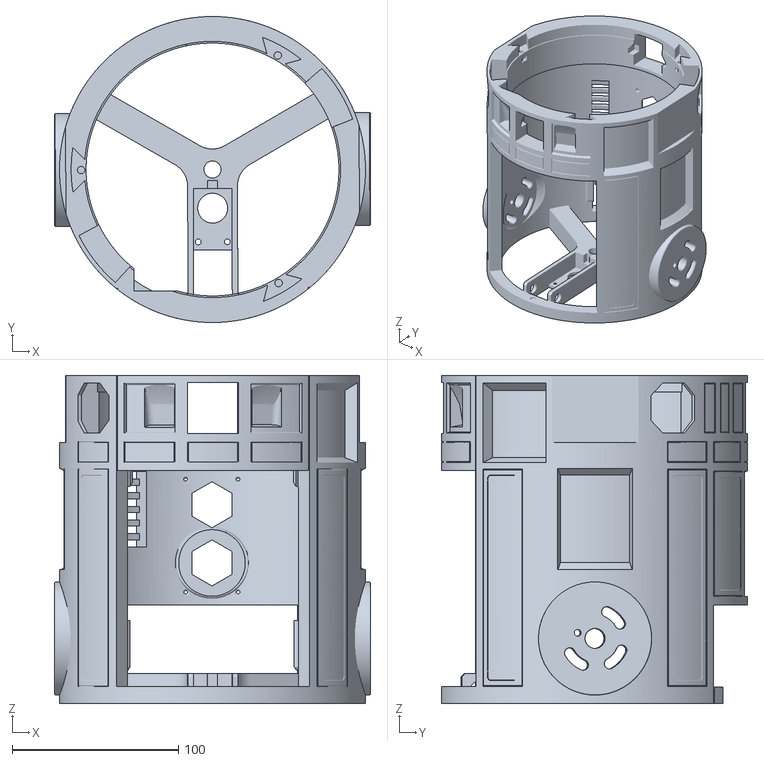
[picture p73: CAD file, 2023-01-24]
Mini 2-3-2 R2-D2/Resin Print Cut by Christophe Kormann/Body/PLA/Body No support.stl
190.3 x 184.0 x 197.2
