tekfufu/mini-R2D2/Mini 2-3-2 R2-D2/Resin Print Cut by Christophe Kormann/Body/Resin/Body56 left.stl

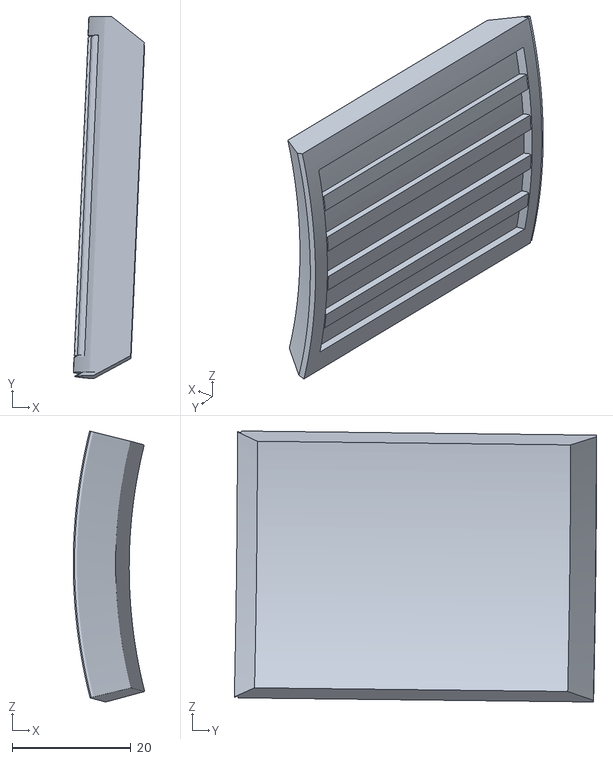
[picture p74: CAD file, 2023-01-24]
Mini 2-3-2 R2-D2/Resin Print Cut by Christophe Kormann/Body/Resin/Body56 left.stl
12.0 x 61.0 x 45.6
