tekfufu/mini-R2D2/Mini 2-3-2 R2-D2/Resin Print Cut by Christophe Kormann/Centre Footshell/Resin/Body2.stl

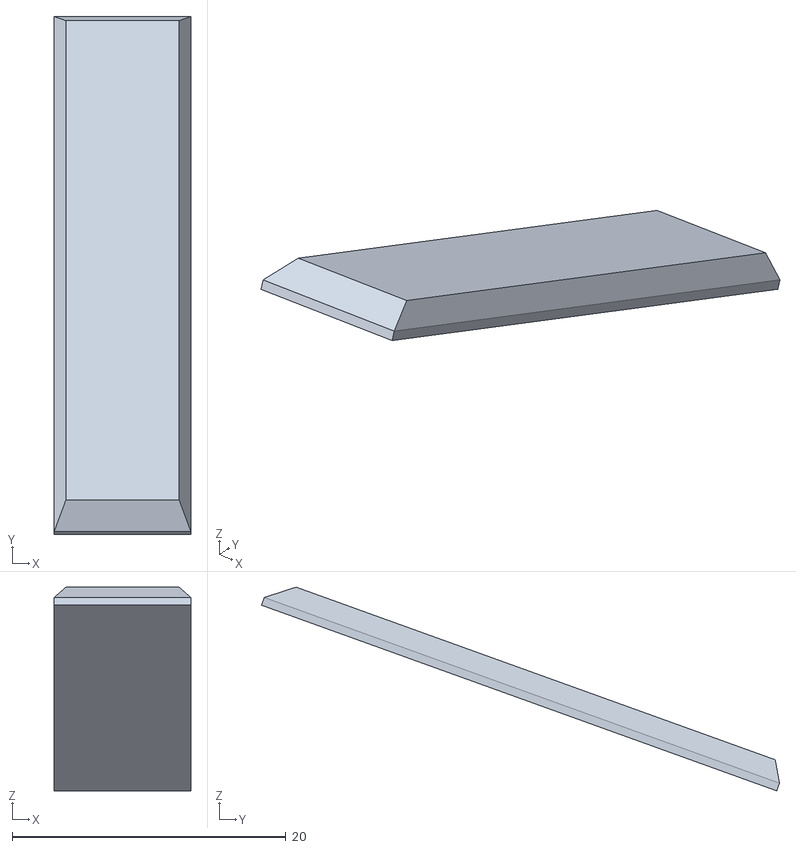
[picture p75: CAD file, 2023-01-24]
Mini 2-3-2 R2-D2/Resin Print Cut by Christophe Kormann/Centre Footshell/Resin/Body2.stl
10.0 x 37.9 x 14.9
