tekfufu/mini-R2D2/Mini 2-3-2 R2-D2/Resin Print Cut by Christophe Kormann/Dome/PLA/Small logic top.stl

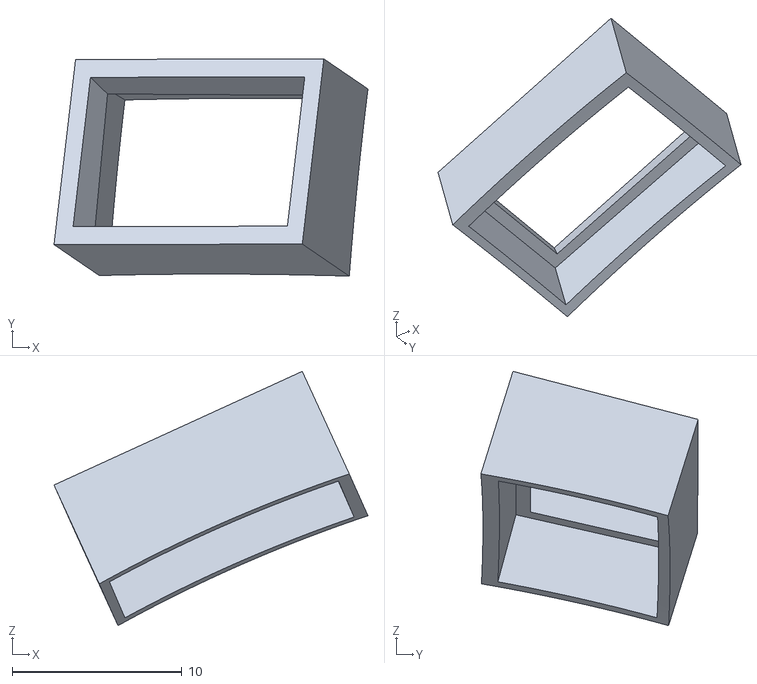
[picture p76: CAD file, 2023-01-24]
Mini 2-3-2 R2-D2/Resin Print Cut by Christophe Kormann/Dome/PLA/Small logic top.stl
18.5 x 12.8 x 15.0
