tekfufu/mini-R2D2/Mini 2-3-2 R2-D2/Resin Print Cut by Christophe Kormann/Dome/Resin/Body151.stl

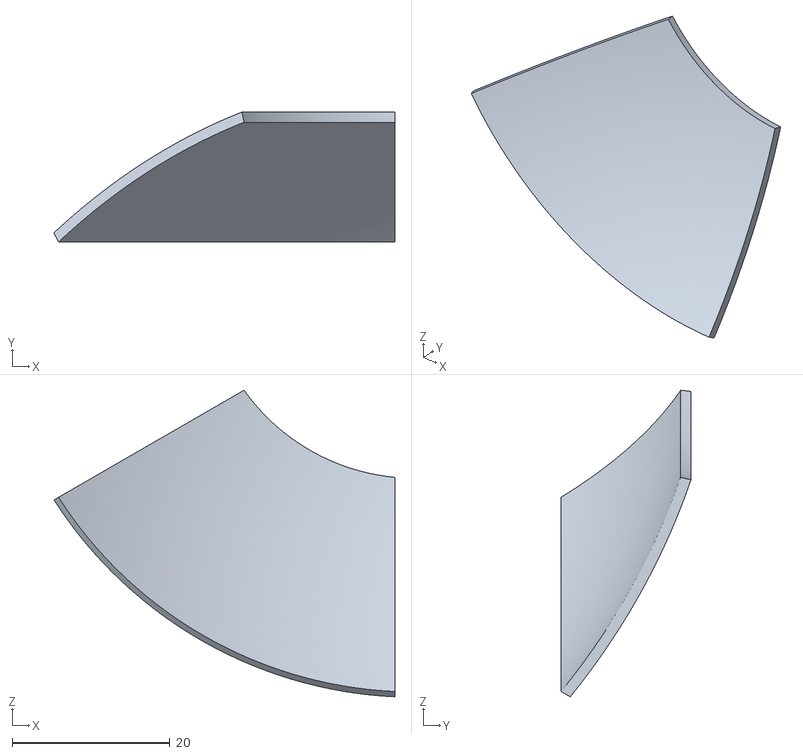
[picture p77: CAD file, 2023-01-24]
Mini 2-3-2 R2-D2/Resin Print Cut by Christophe Kormann/Dome/Resin/Body151.stl
43.3 x 16.5 x 38.9
