tekfufu/mini-R2D2/Mini 2-3-2 R2-D2/Resin Print Cut by Christophe Kormann/Legs/Left/Resin/Body14.stl

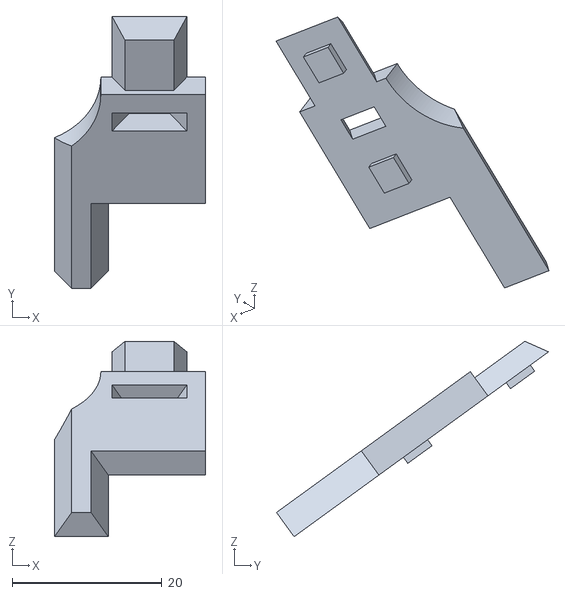
[picture p78: CAD file, 2023-01-24]
Mini 2-3-2 R2-D2/Resin Print Cut by Christophe Kormann/Legs/Left/Resin/Body14.stl
20.2 x 36.3 x 26.1
