tekfufu/mini-R2D2/Mini 2-3-2 R2-D2/Resin Print Cut by Christophe Kormann/Legs/Right/Resin/Body29.stl

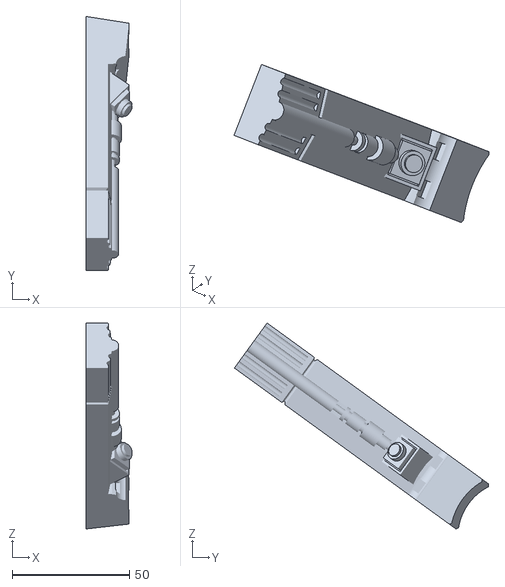
[picture p79: CAD file, 2023-01-24]
Mini 2-3-2 R2-D2/Resin Print Cut by Christophe Kormann/Legs/Right/Resin/Body29.stl
19.8 x 108.4 x 87.8
