tekfufu/mini-R2D2/Mini 2-3-2 R2-D2/STL_s/Body/Skirt.STL

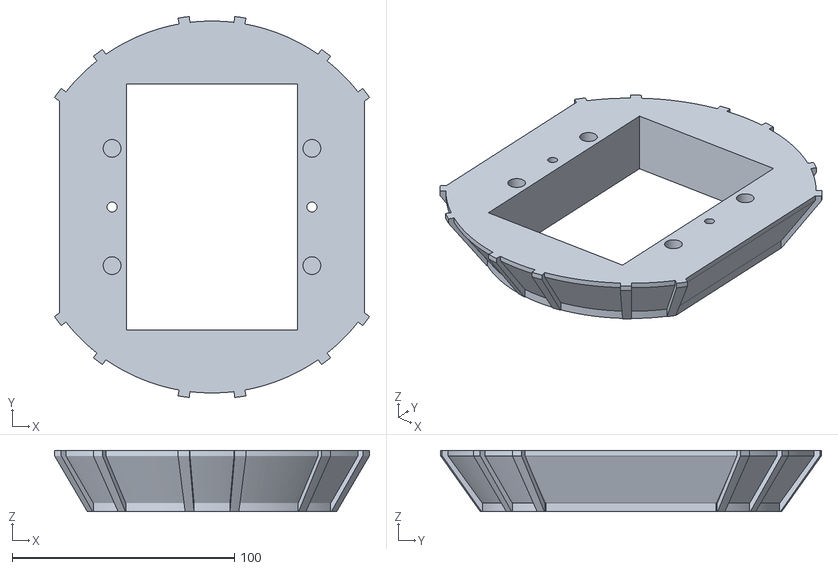
[picture p80: CAD file, 2023-01-24]
Mini 2-3-2 R2-D2/STL_s/Body/Skirt.STL
141.9 x 171.6 x 27.5
