tekfufu/mini-R2D2/Mini 2-3-2 R2-D2/STL_s/Centre Lift/Centre Leg.STL

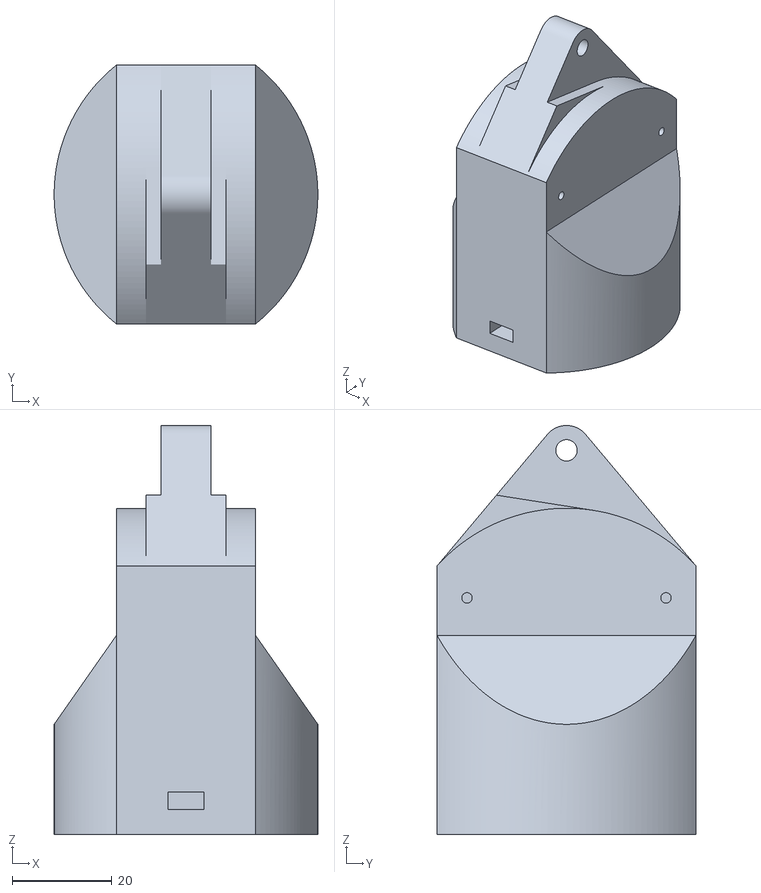
[picture p81: CAD file, 2023-01-24]
Mini 2-3-2 R2-D2/STL_s/Centre Lift/Centre Leg.STL
53.0 x 52.0 x 82.2
