tekfufu/mini-R2D2/Mini 2-3-2 R2-D2/STL_s/Centre Lift/Optional Crank arms for various servo horns/Crank A Servo 25T.STL

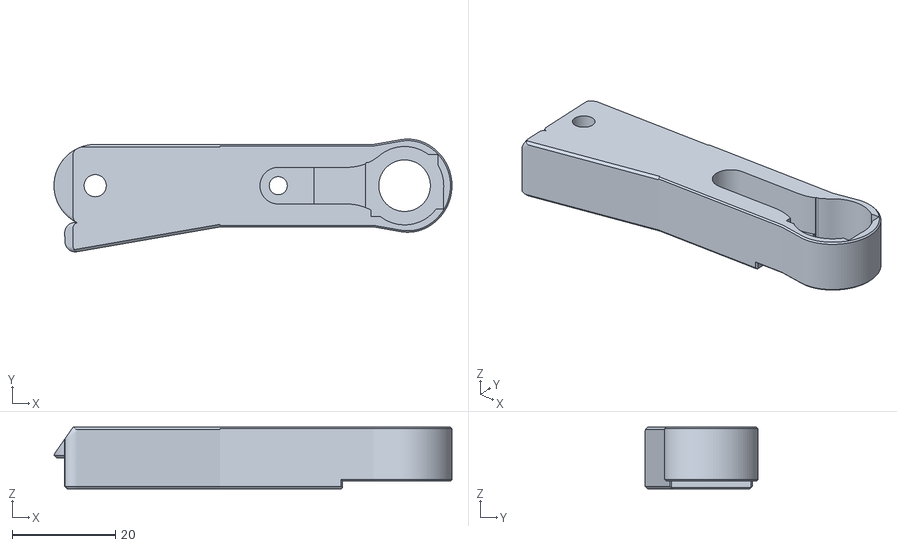
[picture p82: CAD file, 2023-01-24]
Mini 2-3-2 R2-D2/STL_s/Centre Lift/Optional Crank arms for various servo horns/Crank A Servo 25T.STL
77.2 x 21.9 x 12.0
