tekfufu/mini-R2D2/Mini 2-3-2 R2-D2/STL_s/Dome with Periscope/Dome Gear.STL

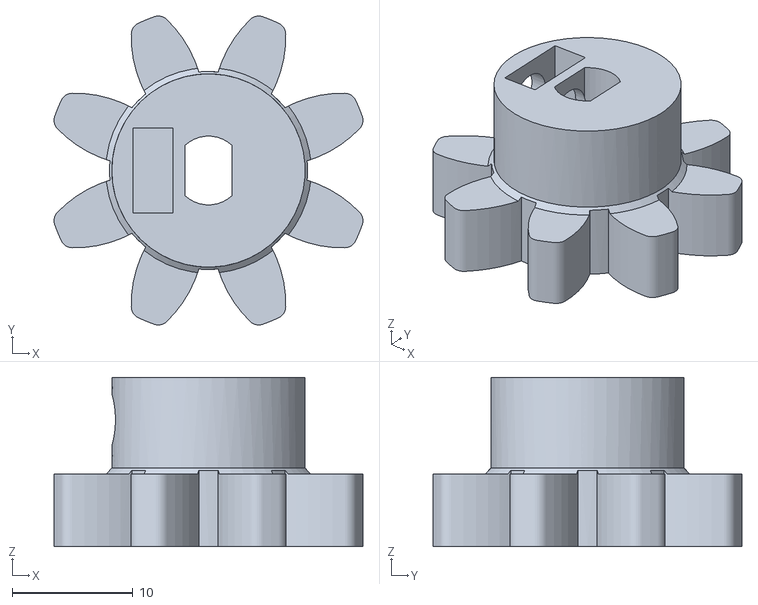
[picture p83: CAD file, 2023-01-24]
Mini 2-3-2 R2-D2/STL_s/Dome with Periscope/Dome Gear.STL
25.6 x 25.6 x 14.0
