tekfufu/mini-R2D2/Mini 2-3-2 R2-D2/STL_s/Dome with Periscope/LED inserts/Large PSI.STL

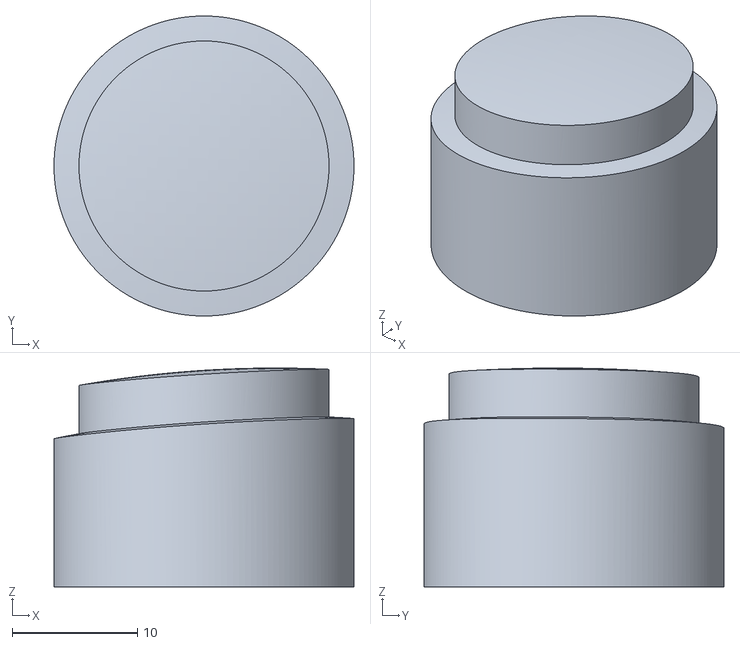
[picture p84: CAD file, 2023-01-24]
Mini 2-3-2 R2-D2/STL_s/Dome with Periscope/LED inserts/Large PSI.STL
24.0 x 24.0 x 17.5
