tekfufu/mini-R2D2/Mini 2-3-2 R2-D2/STL_s/Dome with Periscope/Moveable Holos/R2 Holo Outer Case.STL

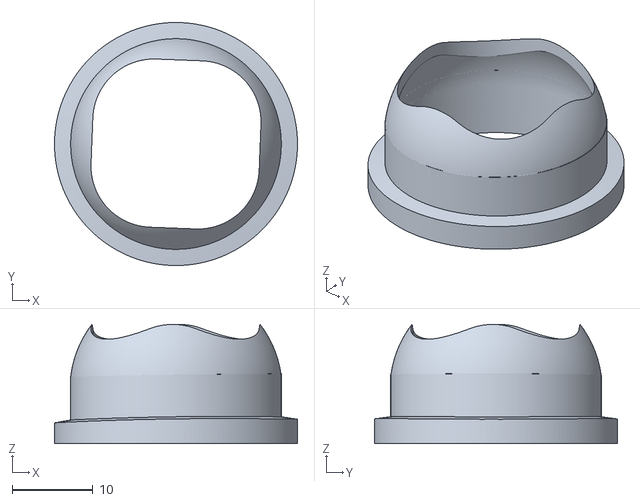
[picture p85: CAD file, 2023-01-24]
Mini 2-3-2 R2-D2/STL_s/Dome with Periscope/Moveable Holos/R2 Holo Outer Case.STL
30.0 x 30.0 x 14.7
