tekfufu/mini-R2D2/Mini 2-3-2 R2-D2/STL_s/Front Arms/Utilility Arm Pin x2.STL

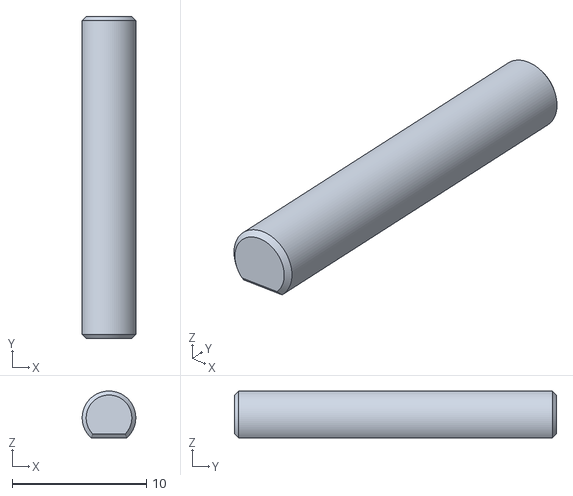
[picture p86: CAD file, 2023-01-24]
Mini 2-3-2 R2-D2/STL_s/Front Arms/Utilility Arm Pin x2.STL
4.00 x 24.0 x 3.50
