tekfufu/mini-R2D2/Mini 2-3-2 R2-D2/STL_s/Front Castor Wheels/Looser Fit wheel/tyre.stl

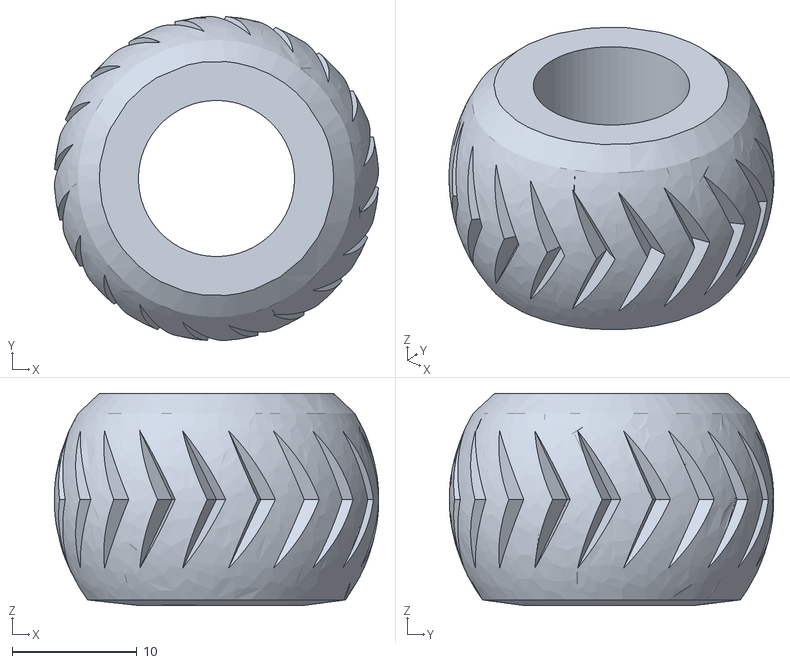
[picture p87: CAD file, 2023-01-24]
Mini 2-3-2 R2-D2/STL_s/Front Castor Wheels/Looser Fit wheel/tyre.stl
26.0 x 26.0 x 17.0
