tekfufu/mini-R2D2/Mini 2-3-2 R2-D2/STL_s/Front Castor Wheels/R2 Front Castor Tyre x2.STL

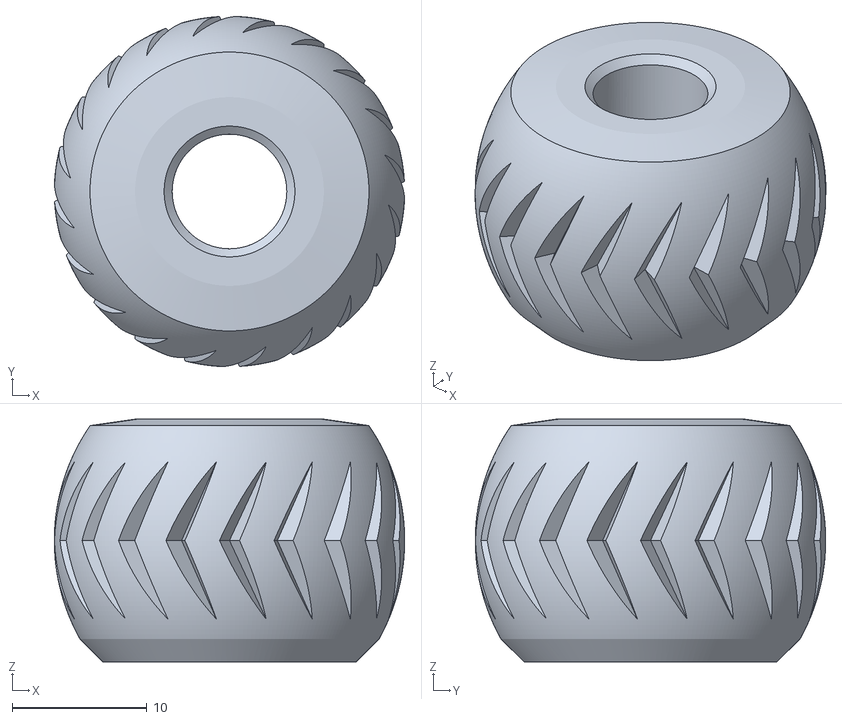
[picture p88: CAD file, 2023-01-24]
Mini 2-3-2 R2-D2/STL_s/Front Castor Wheels/R2 Front Castor Tyre x2.STL
26.0 x 26.0 x 18.0
