tekfufu/mini-R2D2/Mini 2-3-2 R2-D2/STL_s/Legs/R2 2-3-2 Right Battery Box.STL

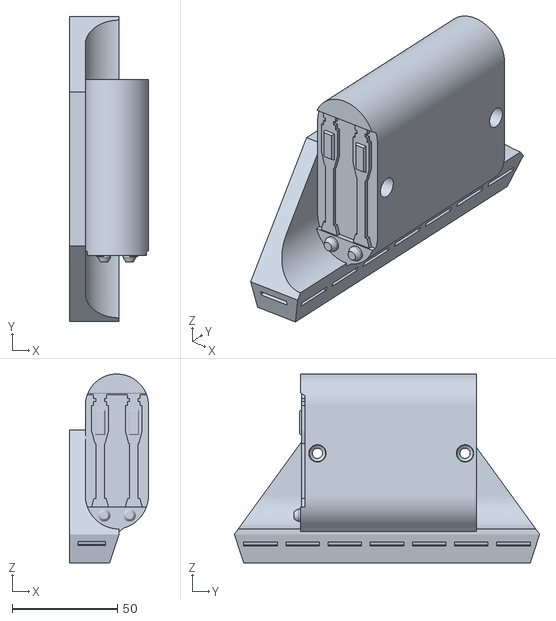
[picture p89: CAD file, 2023-01-24]
Mini 2-3-2 R2-D2/STL_s/Legs/R2 2-3-2 Right Battery Box.STL
37.5 x 144.8 x 89.6
