tekfufu/mini-R2D2/Mini 2-3-2 R2-D2/STL_s/Omniwheels/Omniwheel 50mm Part C.STL

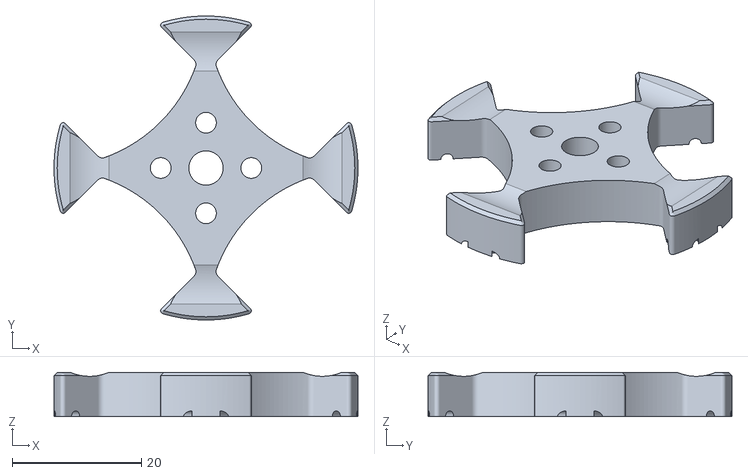
[picture p90: CAD file, 2023-01-24]
Mini 2-3-2 R2-D2/STL_s/Omniwheels/Omniwheel 50mm Part C.STL
47.0 x 47.0 x 6.87
