tekfufu/mini-R2D2/Mini 2-3-2 R2-D2/STL_s/Rubber Wheels/Mini 2-3-2 Wheel.STL

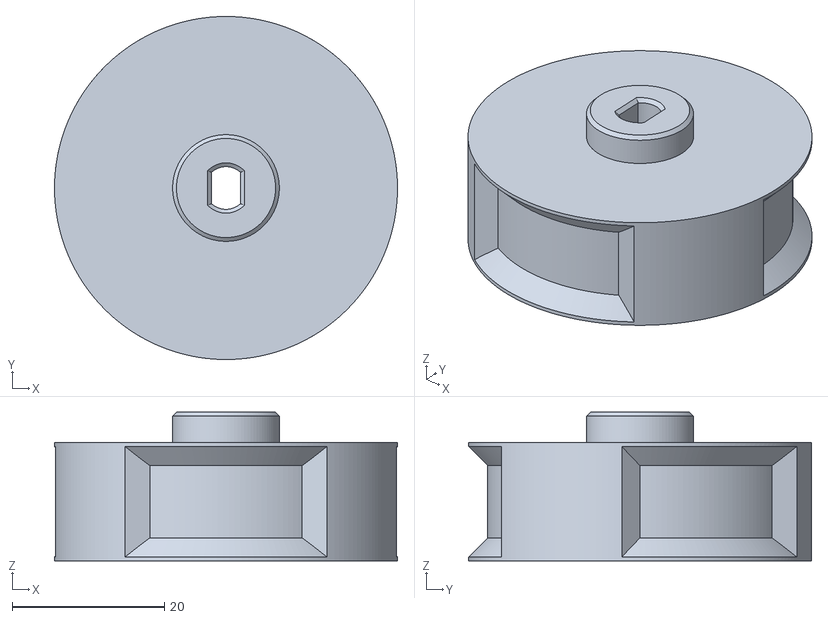
[picture p91: CAD file, 2023-01-24]
Mini 2-3-2 R2-D2/STL_s/Rubber Wheels/Mini 2-3-2 Wheel.STL
45.0 x 45.0 x 19.5
