tekfufu/mini-R2D2/Mini R2/R2 Body with moveable front arms/STL_s/R2_D2_Body_Front Arm Cutout Insert.STL

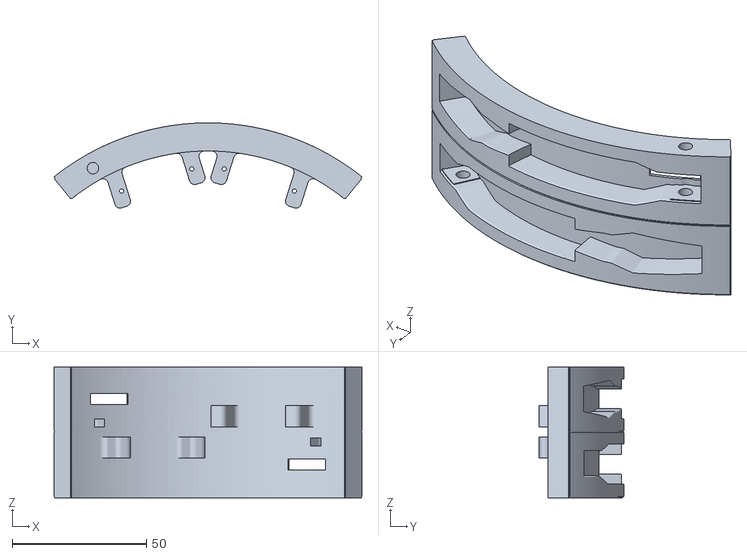
[picture p92: CAD file, 2023-01-24]
Mini R2/R2 Body with moveable front arms/STL_s/R2_D2_Body_Front Arm Cutout Insert.STL
114.9 x 31.8 x 48.8
