tekfufu/mini-R2D2/Mini R2/R2 Body/MZ R2_D2 Left Leg Upper.STL

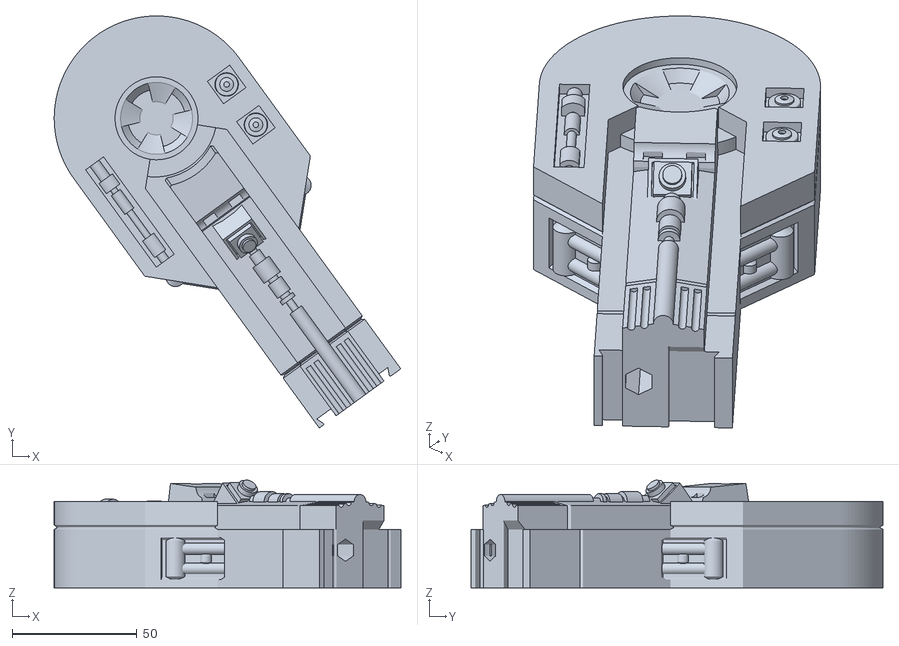
[picture p93: CAD file, 2023-01-24]
Mini R2/R2 Body/MZ R2_D2 Left Leg Upper.STL
138.8 x 165.1 x 43.3
