tekfufu/mini-R2D2/Mini R2/R2 Dome/Dome Axle.STL

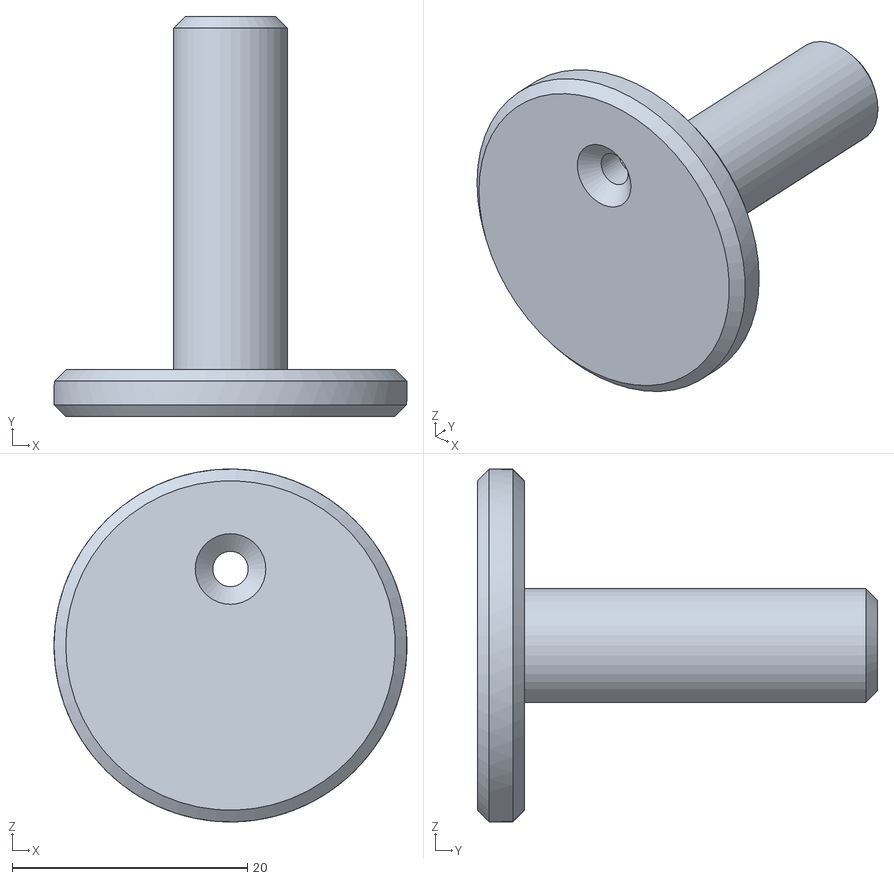
[picture p94: CAD file, 2023-01-24]
Mini R2/R2 Dome/Dome Axle.STL
30.0 x 34.0 x 30.0
