tekfufu/mini-R2D2/Mini 2-3-2 R2-D2/Resin Print Cut by Christophe Kormann/Body/Resin/Body102 front.stl

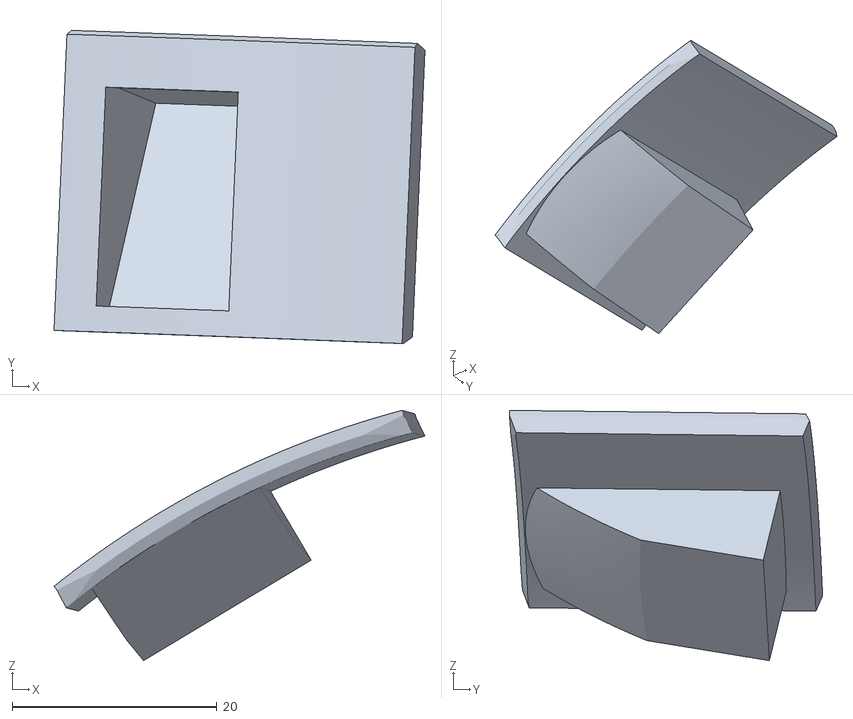
[picture p95: CAD file, 2023-01-24]
Mini 2-3-2 R2-D2/Resin Print Cut by Christophe Kormann/Body/Resin/Body102 front.stl
36.3 x 30.6 x 24.5
