tekfufu/mini-R2D2/Mini 2-3-2 R2-D2/Resin Print Cut by Christophe Kormann/Dome/PLA/Large logic.stl

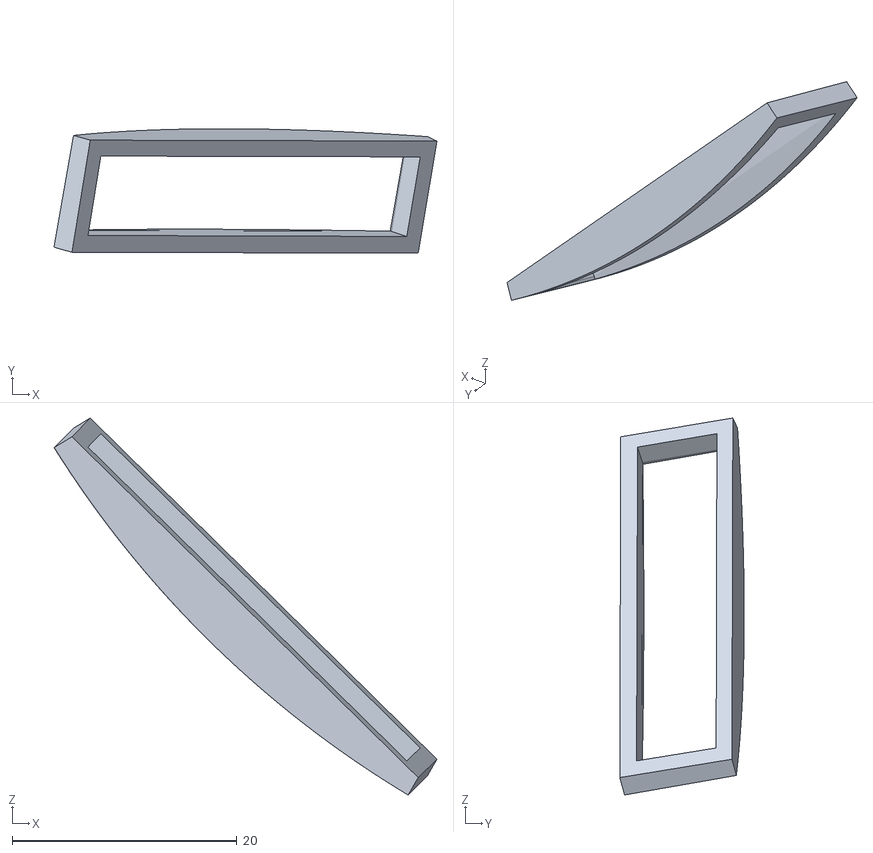
[picture p96: CAD file, 2023-01-24]
Mini 2-3-2 R2-D2/Resin Print Cut by Christophe Kormann/Dome/PLA/Large logic.stl
34.1 x 11.1 x 33.6
