tekfufu/mini-R2D2/Mini 2-3-2 R2-D2/Resin Print Cut by Christophe Kormann/Legs/Left/Resin/Body3.stl

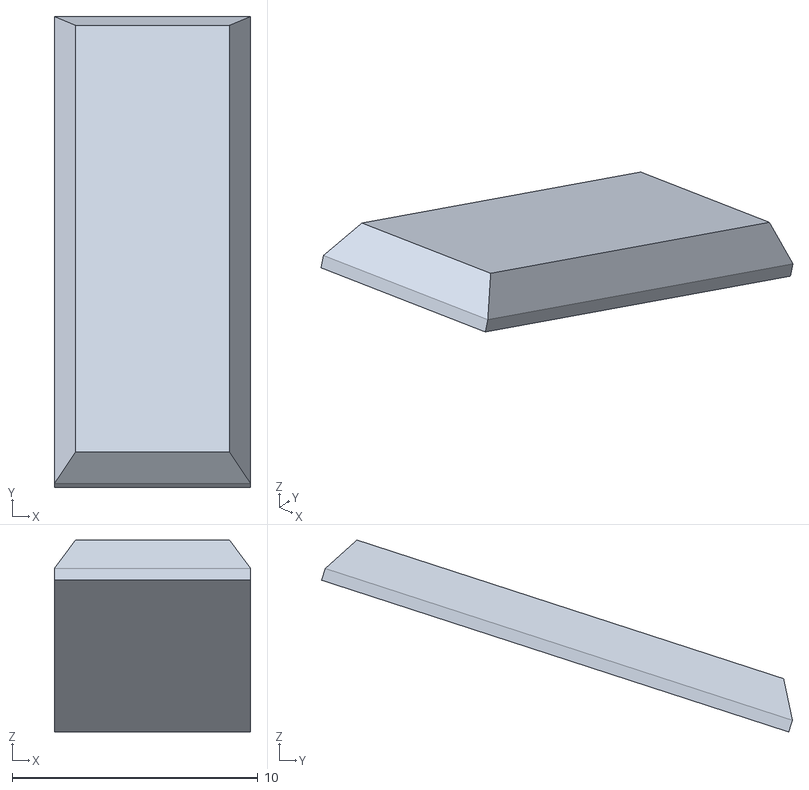
[picture p98: CAD file, 2023-01-24]
Mini 2-3-2 R2-D2/Resin Print Cut by Christophe Kormann/Legs/Left/Resin/Body3.stl
8.00 x 19.2 x 7.81
