tekfufu/mini-R2D2/Mini 2-3-2 R2-D2/Resin Print Cut by Christophe Kormann/Legs/Right/Resin/Body30.stl

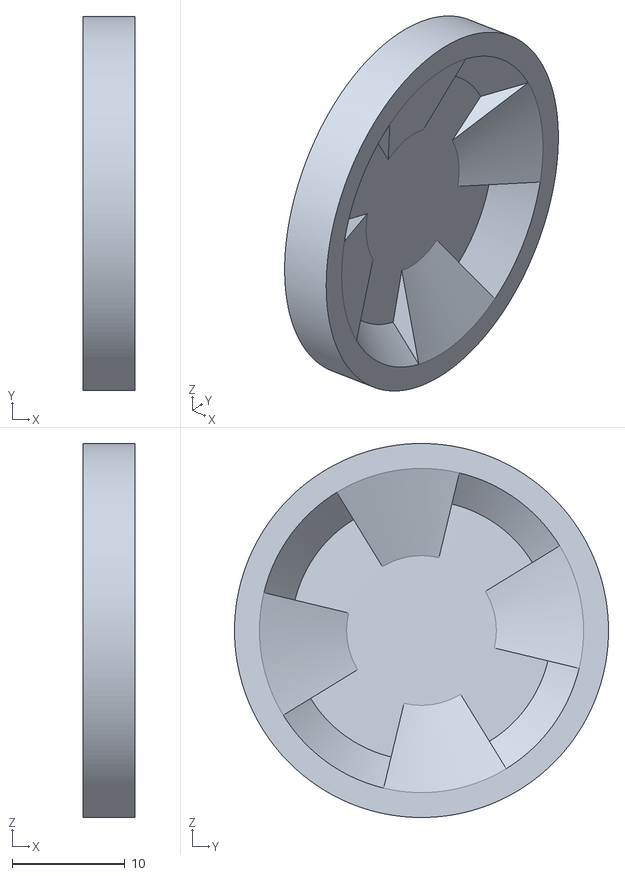
[picture p99: CAD file, 2023-01-24]
Mini 2-3-2 R2-D2/Resin Print Cut by Christophe Kormann/Legs/Right/Resin/Body30.stl
4.65 x 33.2 x 33.2
