tekfufu/mini-R2D2/Mini 2-3-2 R2-D2/STL_s/Body/Front Vent.STL

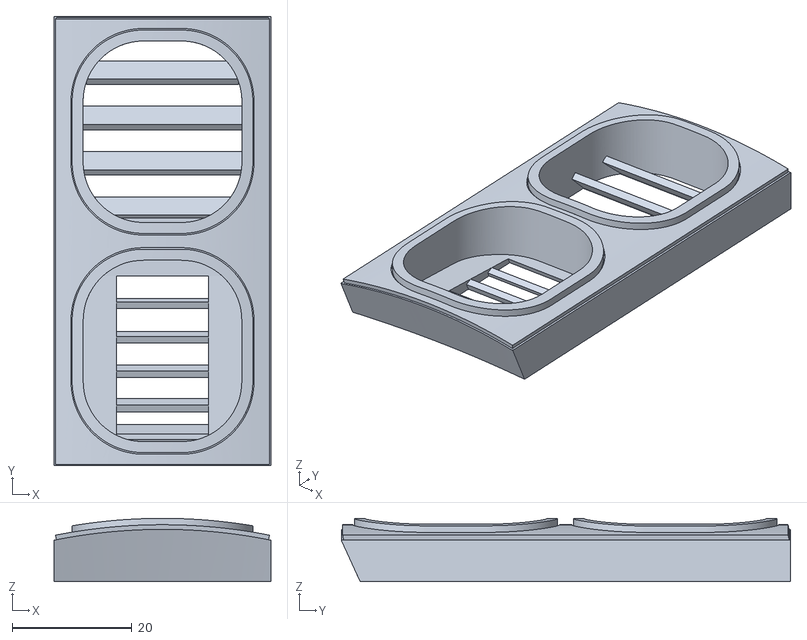
[picture p100: CAD file, 2023-01-24]
Mini 2-3-2 R2-D2/STL_s/Body/Front Vent.STL
36.2 x 74.9 x 10.6
