tekfufu/mini-R2D2/Mini 2-3-2 R2-D2/STL_s/Centre Lift/Centre Leg Lift Top.STL

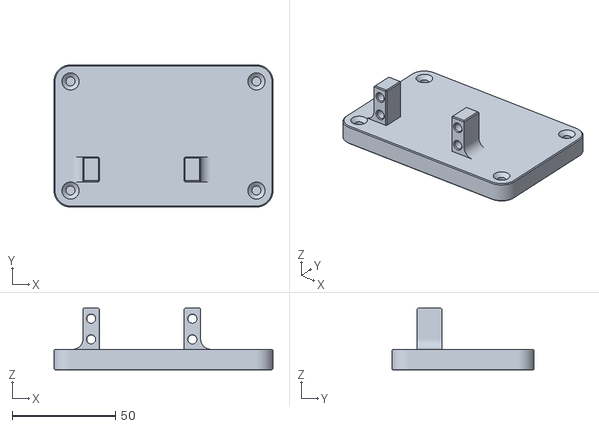
[picture p101: CAD file, 2023-01-24]
Mini 2-3-2 R2-D2/STL_s/Centre Lift/Centre Leg Lift Top.STL
106.0 x 68.8 x 30.0
