tekfufu/mini-R2D2/Mini 2-3-2 R2-D2/STL_s/Dome with Periscope/Periscope Servo Linkage - Larger Servo Horn.STL

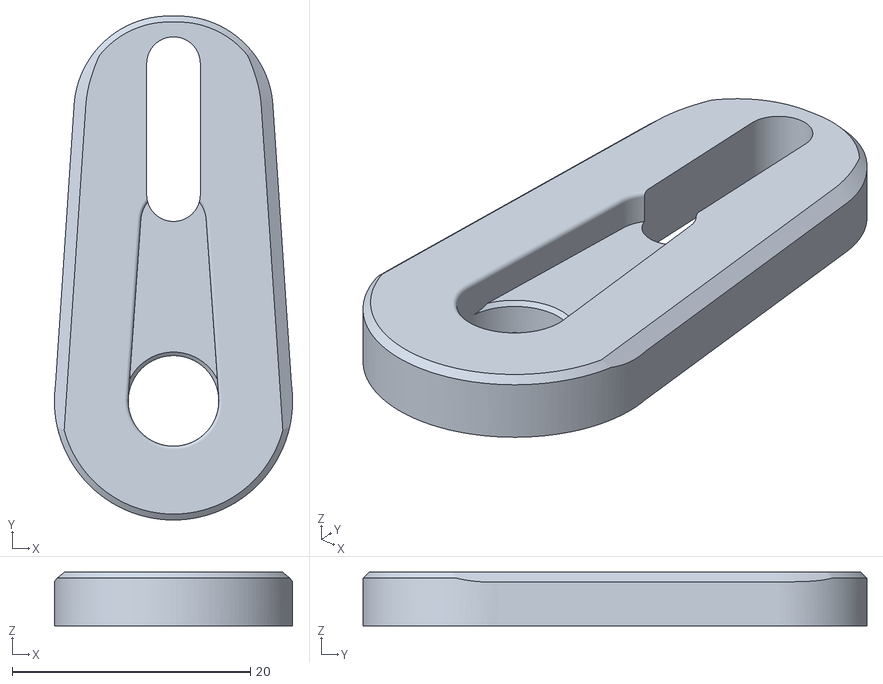
[picture p103: CAD file, 2023-01-24]
Mini 2-3-2 R2-D2/STL_s/Dome with Periscope/Periscope Servo Linkage - Larger Servo Horn.STL
20.0 x 42.3 x 4.50
