tekfufu/mini-R2D2/Mini 2-3-2 R2-D2/STL_s/Front Castor Wheels/Front Caster Axle MZ x2.STL

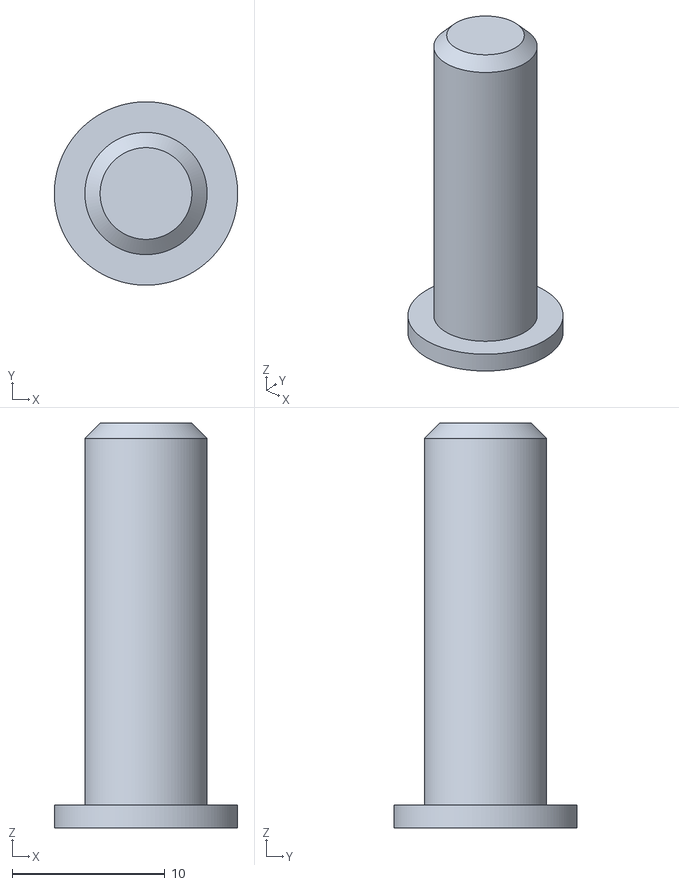
[picture p104: CAD file, 2023-01-24]
Mini 2-3-2 R2-D2/STL_s/Front Castor Wheels/Front Caster Axle MZ x2.STL
12.0 x 12.0 x 26.5
