tekfufu/mini-R2D2/Mini 2-3-2 R2-D2/STL_s/Legs/R2 2-3-2 Left Leg.STL

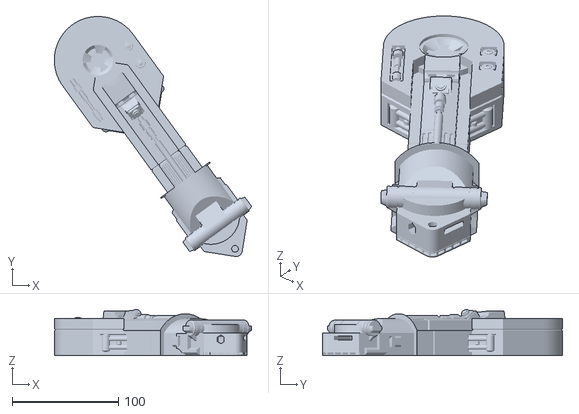
[picture p105: CAD file, 2023-01-24]
Mini 2-3-2 R2-D2/STL_s/Legs/R2 2-3-2 Left Leg.STL
185.4 x 225.4 x 43.3
