tekfufu/mini-R2D2/Mini 2-3-2 R2-D2/STL_s/Omniwheels/Omniwheel 50mm Tyre.STL

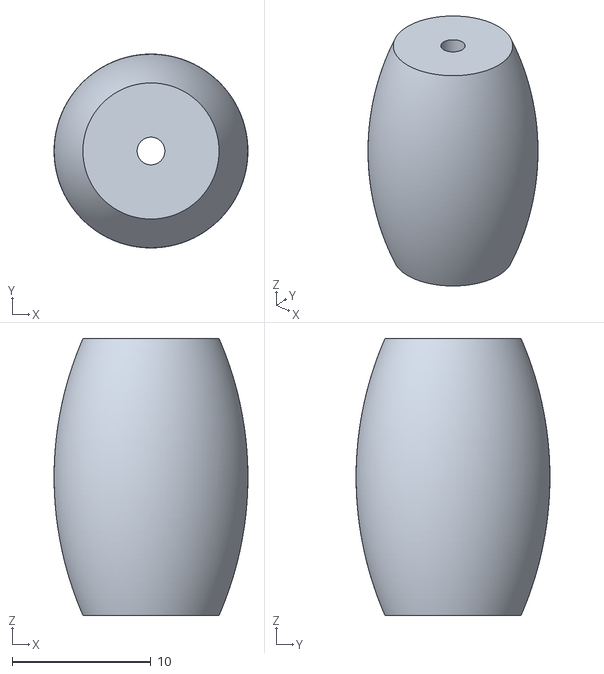
[picture p106: CAD file, 2023-01-24]
Mini 2-3-2 R2-D2/STL_s/Omniwheels/Omniwheel 50mm Tyre.STL
14.0 x 14.0 x 20.0
