tekfufu/mini-R2D2/Mini R2/R2 Body/MZ R2_D2 Right Battery Box.STL

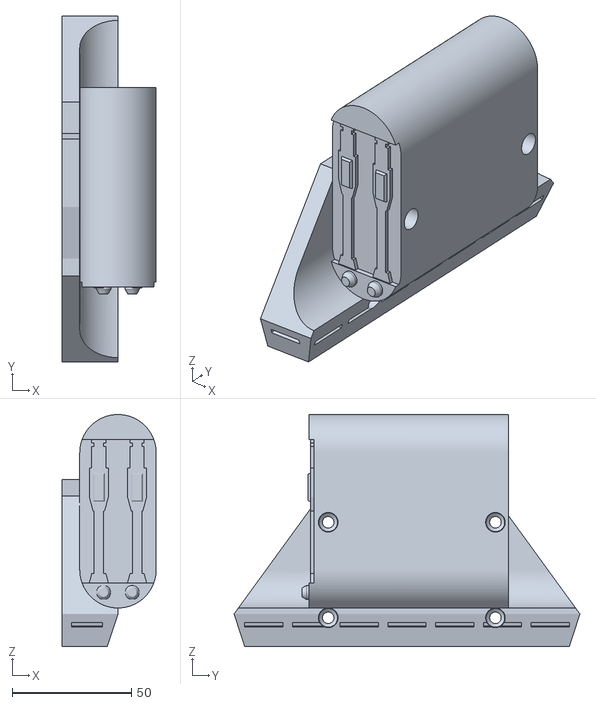
[picture p107: CAD file, 2023-01-24]
Mini R2/R2 Body/MZ R2_D2 Right Battery Box.STL
39.5 x 144.8 x 97.1
