tekfufu/mini-R2D2/Mini 2-3-2 R2-D2/Resin Print Cut by Christophe Kormann/Body/Resin/Body48 rear.stl

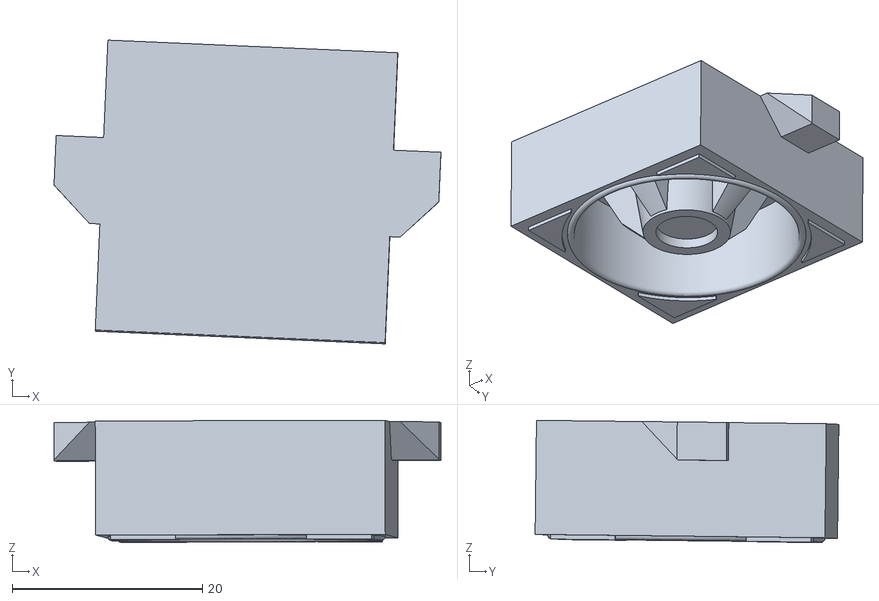
[picture p108: CAD file, 2023-01-24]
Mini 2-3-2 R2-D2/Resin Print Cut by Christophe Kormann/Body/Resin/Body48 rear.stl
40.7 x 32.0 x 12.9
