tekfufu/mini-R2D2/Mini 2-3-2 R2-D2/STL_s/Centre Lift/Crank B Lift.STL

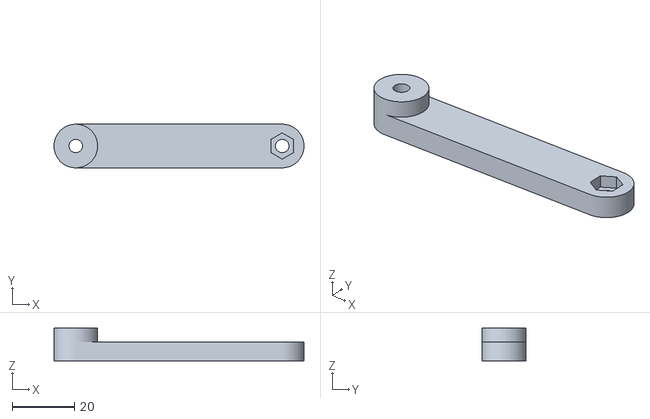
[picture p111: CAD file, 2023-01-24]
Mini 2-3-2 R2-D2/STL_s/Centre Lift/Crank B Lift.STL
80.2 x 14.0 x 10.5
