tekfufu/mini-R2D2/Mini 2-3-2 R2-D2/STL_s/Dome with Periscope/Periscope Shaft v2.STL

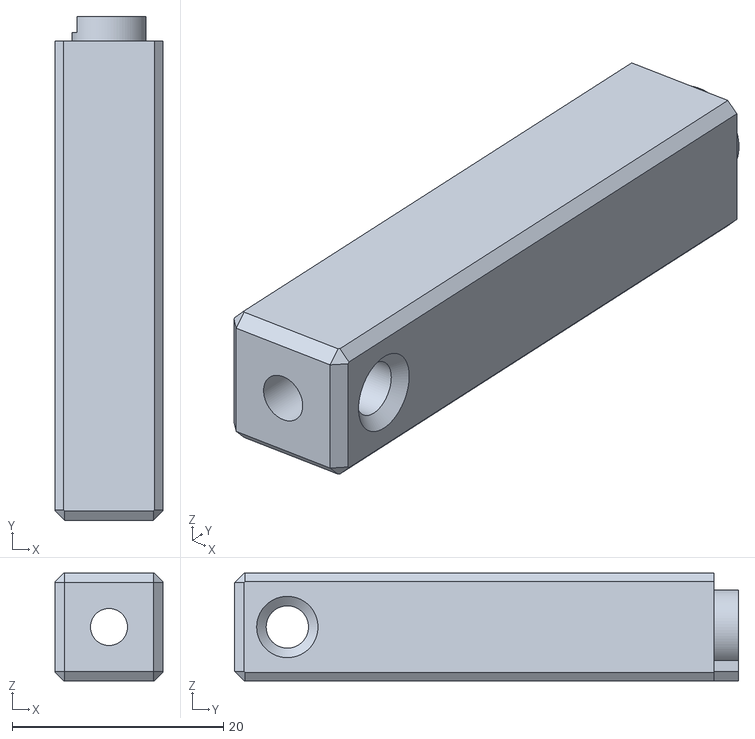
[picture p112: CAD file, 2023-01-24]
Mini 2-3-2 R2-D2/STL_s/Dome with Periscope/Periscope Shaft v2.STL
10.2 x 47.7 x 10.2
