tekfufu/mini-R2D2/Mini 2-3-2 R2-D2/STL_s/Legs/Leg Tie Rod x2.STL

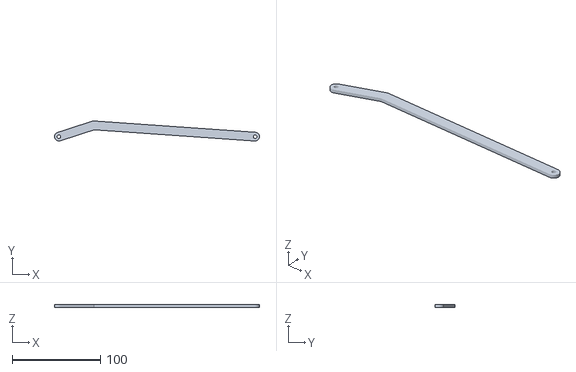
[picture p113: CAD file, 2023-01-24]
Mini 2-3-2 R2-D2/STL_s/Legs/Leg Tie Rod x2.STL
232.7 x 22.8 x 3.00
