tekfufu/mini-R2D2/Mini R2/R2 Dome with LED lights/Logic Panels (resin printer only).STL

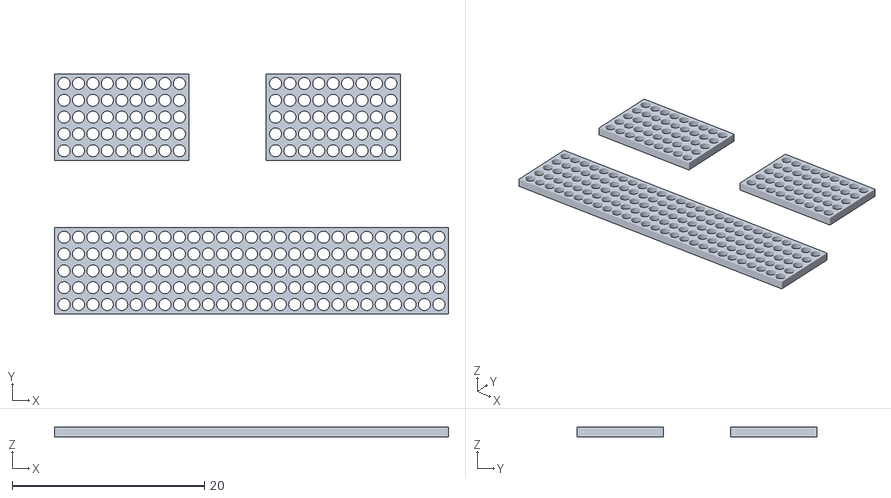
[picture p115: CAD file, 2023-01-24]
Mini R2/R2 Dome with LED lights/Logic Panels (resin printer only).STL
41.0 x 25.0 x 1.00
