tekfufu/mini-R2D2/Mini R2/R2 Dome/Mini Droid R2 Dome Holoprojector x 3.STL

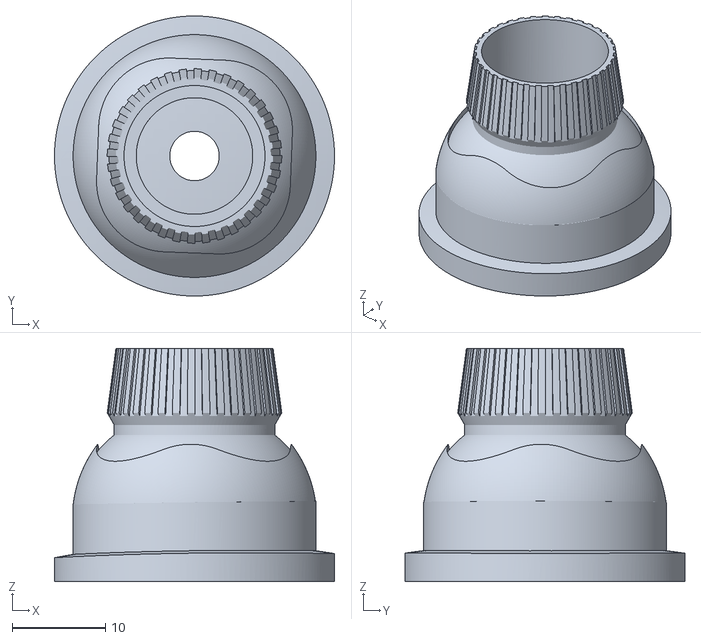
[picture p116: CAD file, 2023-01-24]
Mini R2/R2 Dome/Mini Droid R2 Dome Holoprojector x 3.STL
30.0 x 30.0 x 25.0
