tekfufu/mini-R2D2/Mini 2-3-2 R2-D2/Resin Print Cut by Christophe Kormann/Body/Resin/Body157 rear right.stl

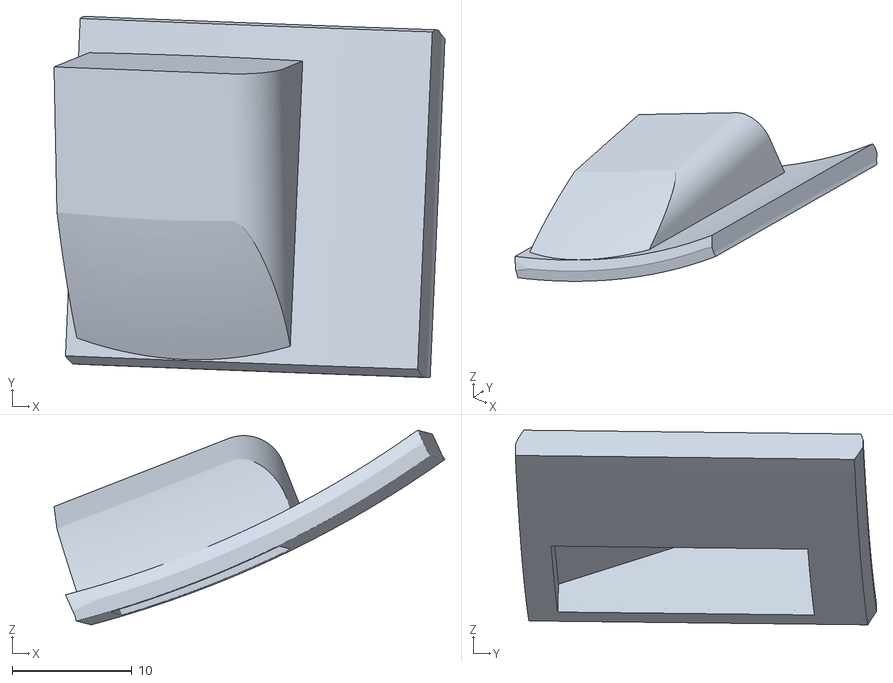
[picture p117: CAD file, 2023-01-24]
Mini 2-3-2 R2-D2/Resin Print Cut by Christophe Kormann/Body/Resin/Body157 rear right.stl
32.6 x 30.1 x 16.2
