tekfufu/mini-R2D2/Mini 2-3-2 R2-D2/Resin Print Cut by Christophe Kormann/Dome/Resin/Lentille radar eye.stl

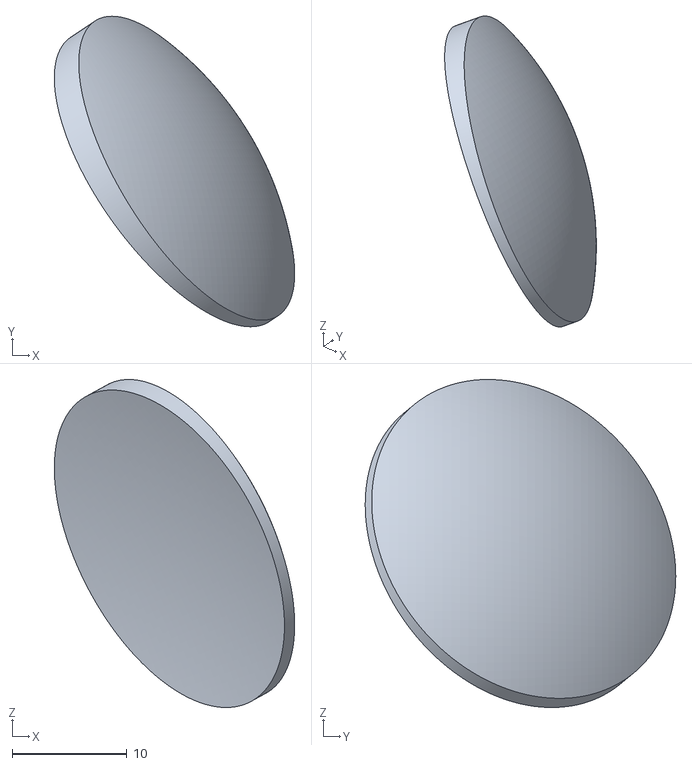
[picture p118: CAD file, 2023-01-24]
Mini 2-3-2 R2-D2/Resin Print Cut by Christophe Kormann/Dome/Resin/Lentille radar eye.stl
21.0 x 27.1 x 28.6
