tekfufu/mini-R2D2/Mini 2-3-2 R2-D2/Resin Print Cut by Christophe Kormann/Legs/Right/Resin/Body50.stl

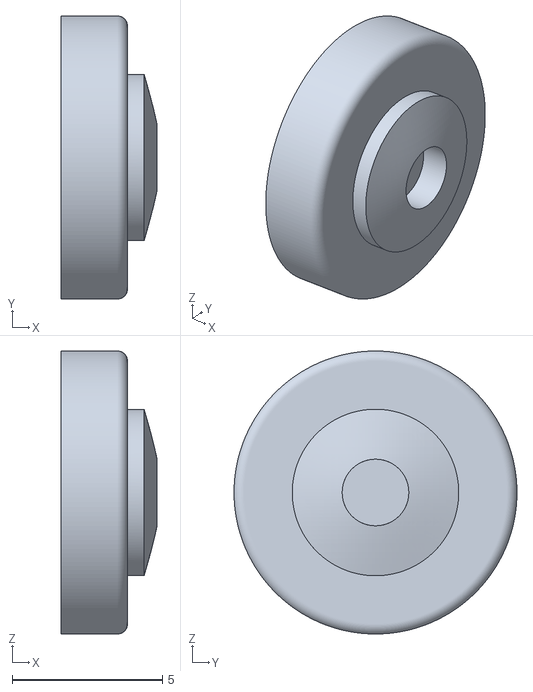
[picture p119: CAD file, 2023-01-24]
Mini 2-3-2 R2-D2/Resin Print Cut by Christophe Kormann/Legs/Right/Resin/Body50.stl
3.20 x 9.42 x 9.42
