tekfufu/mini-R2D2/Mini 2-3-2 R2-D2/STL_s/Body/Leg Tilt Servo Linkage.STL

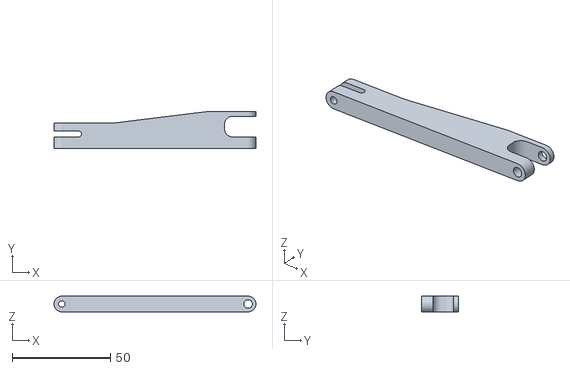
[picture p120: CAD file, 2023-01-24]
Mini 2-3-2 R2-D2/STL_s/Body/Leg Tilt Servo Linkage.STL
103.0 x 19.0 x 8.00
