tekfufu/mini-R2D2/Mini 2-3-2 R2-D2/STL_s/Centre Lift/Centre Footshell Ultimate.STL

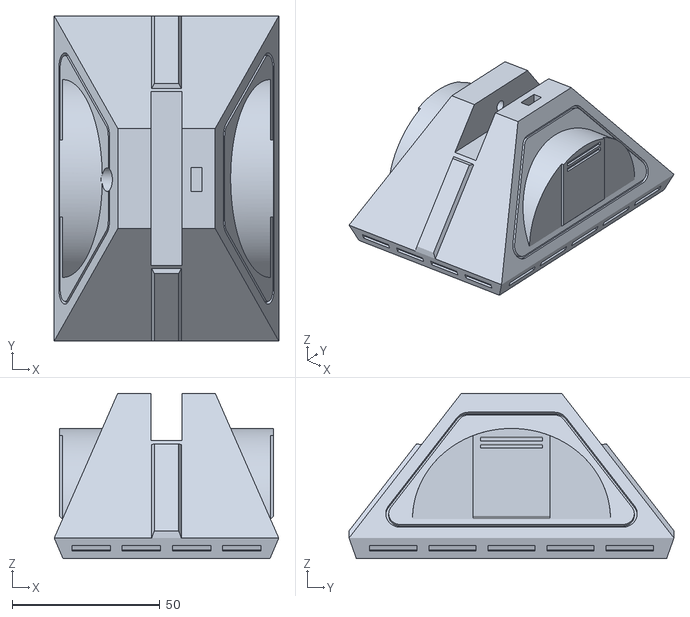
[picture p121: CAD file, 2023-01-24]
Mini 2-3-2 R2-D2/STL_s/Centre Lift/Centre Footshell Ultimate.STL
76.0 x 110.0 x 56.0
