tekfufu/mini-R2D2/Mini 2-3-2 R2-D2/STL_s/Dome with Periscope/LED inserts/Rear Logic.STL

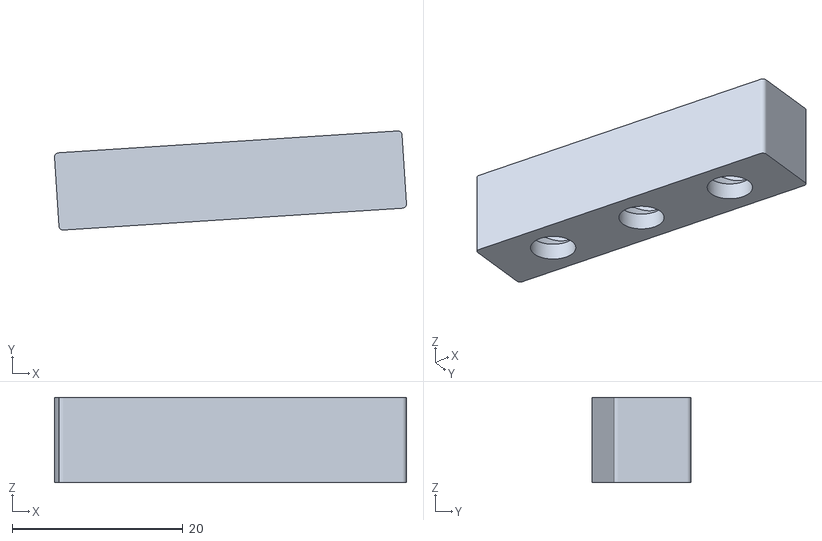
[picture p122: CAD file, 2023-01-24]
Mini 2-3-2 R2-D2/STL_s/Dome with Periscope/LED inserts/Rear Logic.STL
41.3 x 11.6 x 10.0
