tekfufu/mini-R2D2/Mini 2-3-2 R2-D2/STL_s/Dome with Periscope/R2 Mini Periscope - Top v2.STL

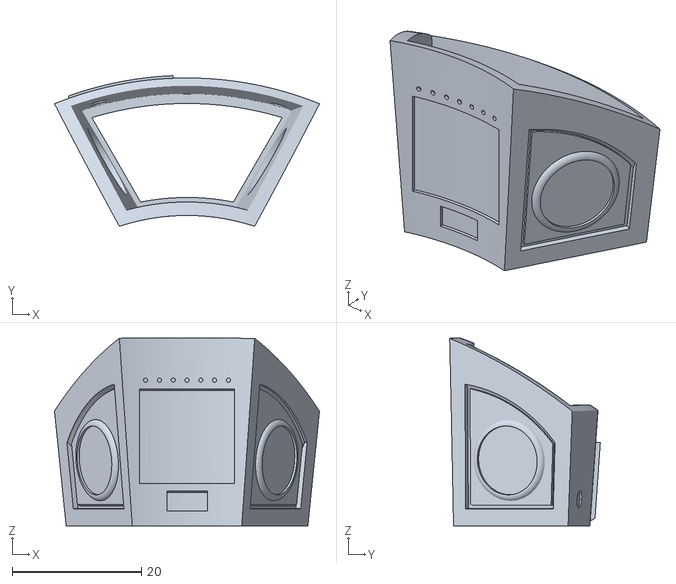
[picture p123: CAD file, 2023-01-24]
Mini 2-3-2 R2-D2/STL_s/Dome with Periscope/R2 Mini Periscope - Top v2.STL
41.0 x 23.3 x 29.1
