tekfufu/mini-R2D2/Mini 2-3-2 R2-D2/STL_s/Legs/R2 2-3-2 Right Foot_s.STL

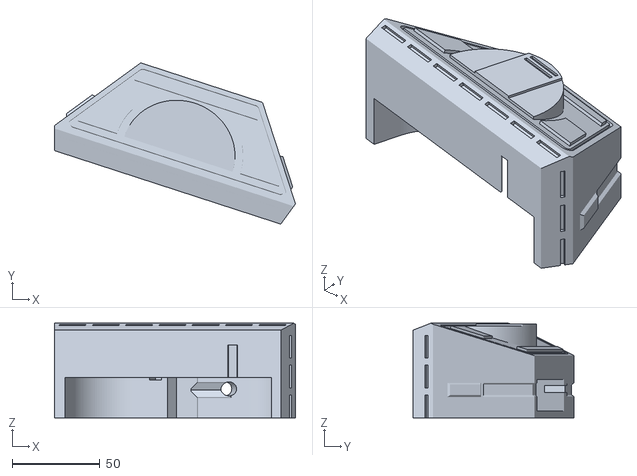
[picture p124: CAD file, 2023-01-24]
Mini 2-3-2 R2-D2/STL_s/Legs/R2 2-3-2 Right Foot_s.STL
137.7 x 92.1 x 54.0
