tekfufu/mini-R2D2/Mini 2-3-2 R2-D2/STL_s/Omniwheels/Omniwheel 50mm Part B.STL

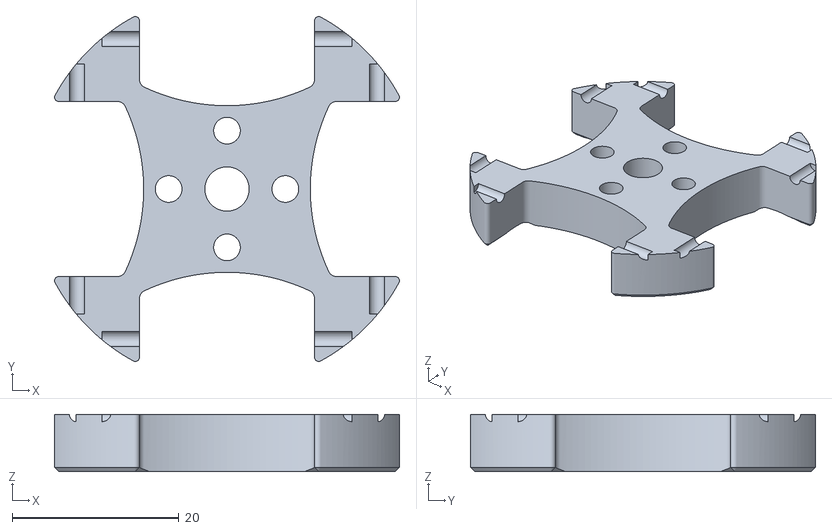
[picture p125: CAD file, 2023-01-24]
Mini 2-3-2 R2-D2/STL_s/Omniwheels/Omniwheel 50mm Part B.STL
41.4 x 41.4 x 6.88
