tekfufu/mini-R2D2/Mini R2/R2 Body/MZ R2-D2 Centre Foot.STL

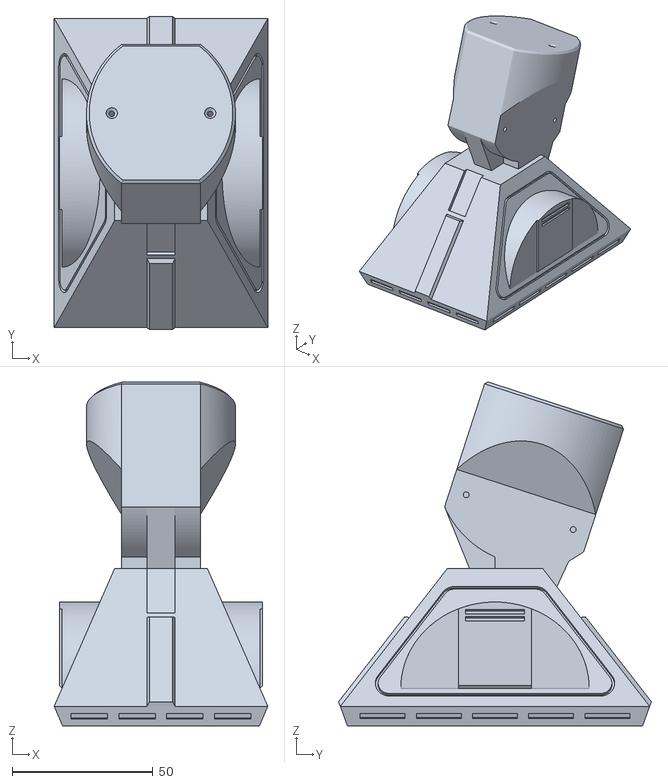
[picture p126: CAD file, 2023-01-24]
Mini R2/R2 Body/MZ R2-D2 Centre Foot.STL
76.0 x 111.3 x 122.3
