tekfufu/mini-R2D2/Mini R2/R2 Dome/Dome Centre Spider.STL

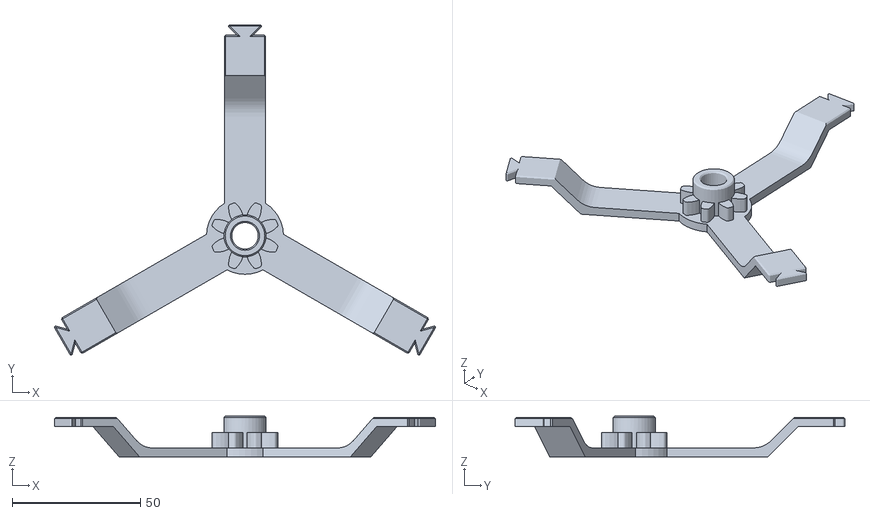
[picture p127: CAD file, 2023-01-24]
Mini R2/R2 Dome/Dome Centre Spider.STL
148.4 x 128.6 x 15.9
