tekfufu/mini-R2D2/Mini 2-3-2 R2-D2/STL_s/Body/MZ R2_D2_Body_2-3-2_Rear_Door.STL

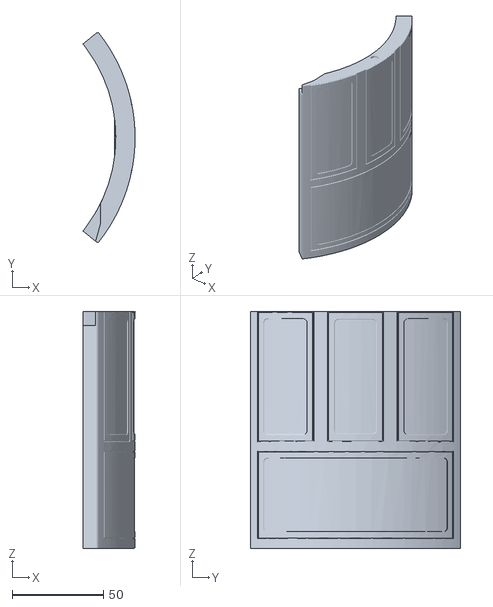
[picture p131: CAD file, 2023-01-24]
Mini 2-3-2 R2-D2/STL_s/Body/MZ R2_D2_Body_2-3-2_Rear_Door.STL
28.5 x 114.9 x 129.6
