tekfufu/mini-R2D2/Mini 2-3-2 R2-D2/STL_s/Centre Lift/R2-D2 Centre Ankle Cylinders x 2_s.STL

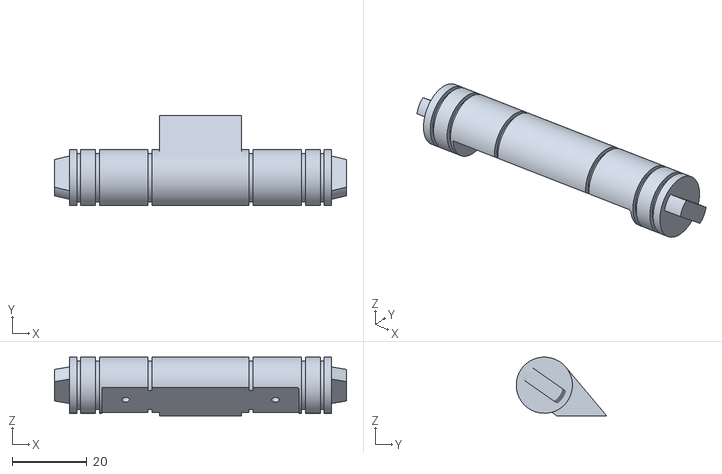
[picture p132: CAD file, 2023-01-24]
Mini 2-3-2 R2-D2/STL_s/Centre Lift/R2-D2 Centre Ankle Cylinders x 2_s.STL
78.0 x 24.2 x 15.7
