tekfufu/mini-R2D2/Mini 2-3-2 R2-D2/STL_s/Dome with Periscope/Dome Centre Spider_s.STL

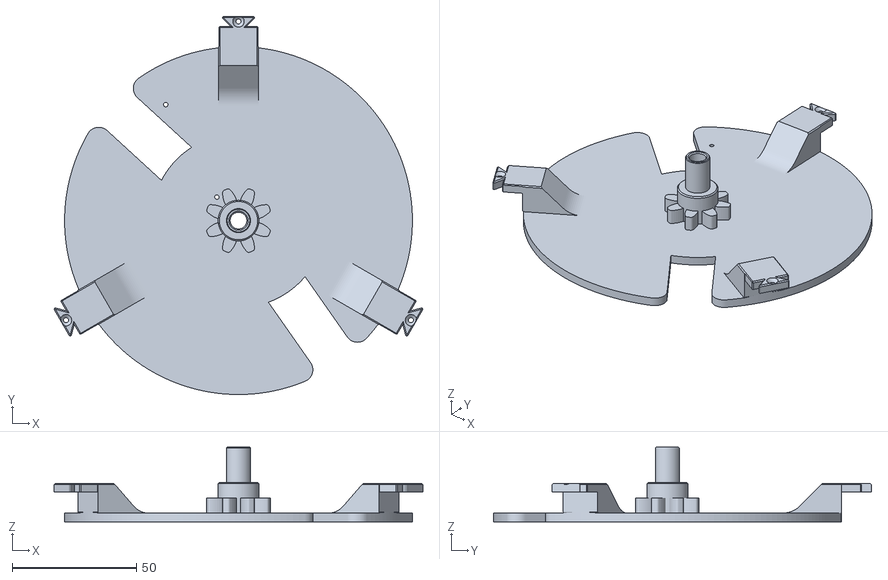
[picture p133: CAD file, 2023-01-24]
Mini 2-3-2 R2-D2/STL_s/Dome with Periscope/Dome Centre Spider_s.STL
148.4 x 152.1 x 30.0
