tekfufu/mini-R2D2/Mini 2-3-2 R2-D2/STL_s/Dome with Periscope/Moveable Holos/R2 Holo Pivot Ball.STL

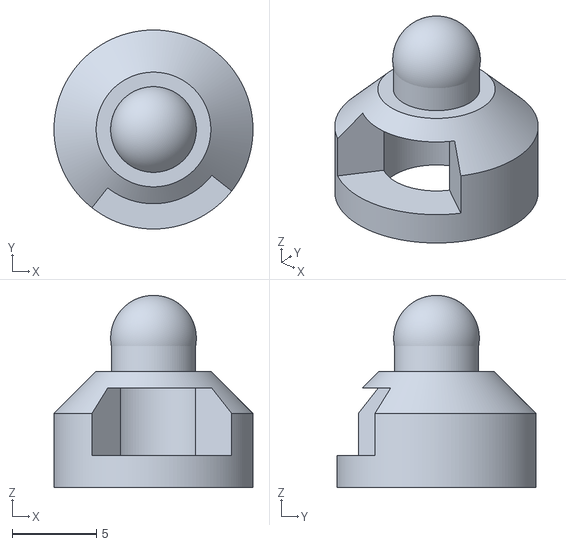
[picture p134: CAD file, 2023-01-24]
Mini 2-3-2 R2-D2/STL_s/Dome with Periscope/Moveable Holos/R2 Holo Pivot Ball.STL
11.8 x 11.8 x 11.4
