tekfufu/mini-R2D2/Mini 2-3-2 R2-D2/STL_s/Omniwheels/5x45mm Axle.STL

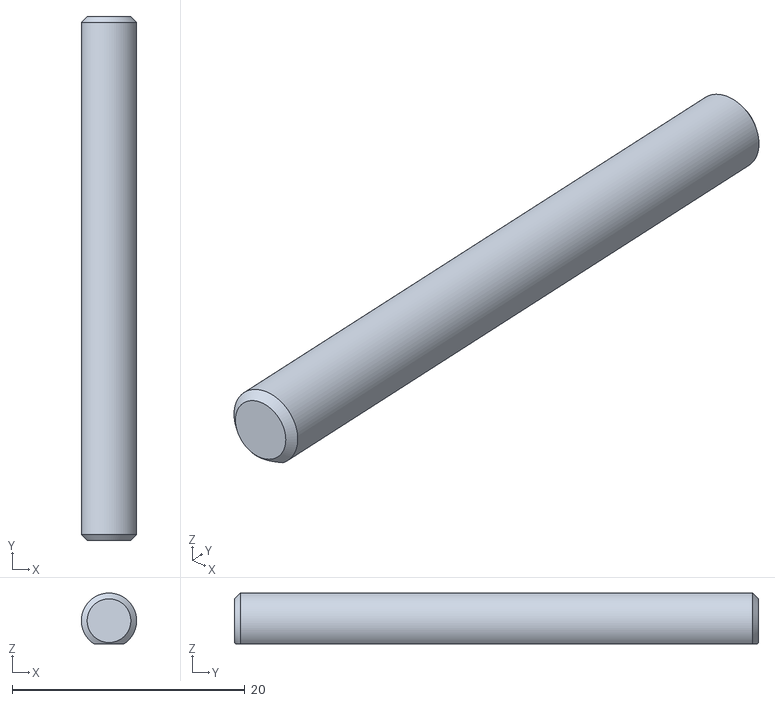
[picture p135: CAD file, 2023-01-24]
Mini 2-3-2 R2-D2/STL_s/Omniwheels/5x45mm Axle.STL
4.75 x 45.0 x 4.37
