tekfufu/mini-R2D2/Mini 2-3-2 R2-D2/Resin Print Cut by Christophe Kormann/Legs/Left/Resin/Body46.stl

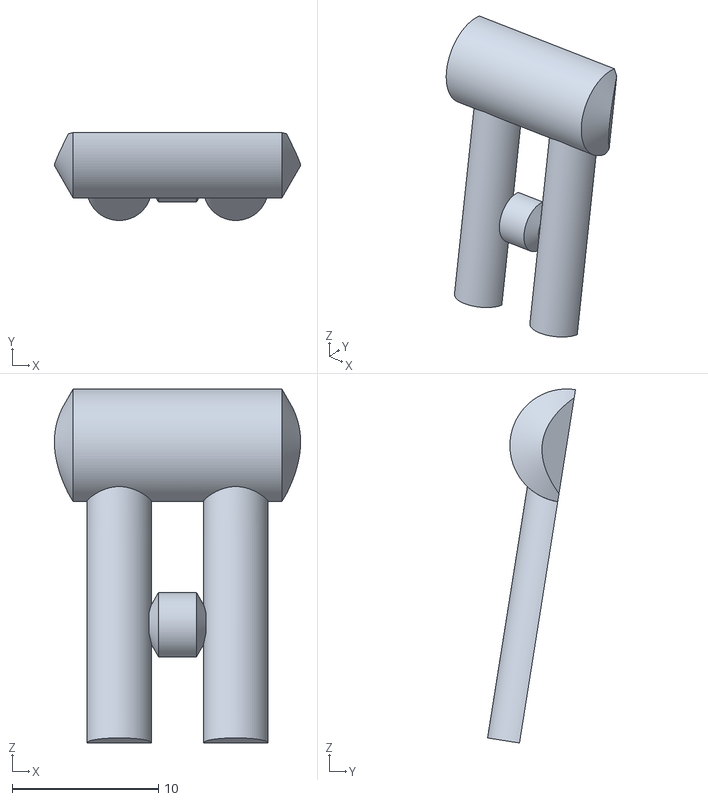
[picture p138: CAD file, 2023-01-24]
Mini 2-3-2 R2-D2/Resin Print Cut by Christophe Kormann/Legs/Left/Resin/Body46.stl
16.8 x 6.02 x 24.2
