tekfufu/mini-R2D2/Mini 2-3-2 R2-D2/STL_s/Omniwheels/Omniwheel 50mm Part D.STL

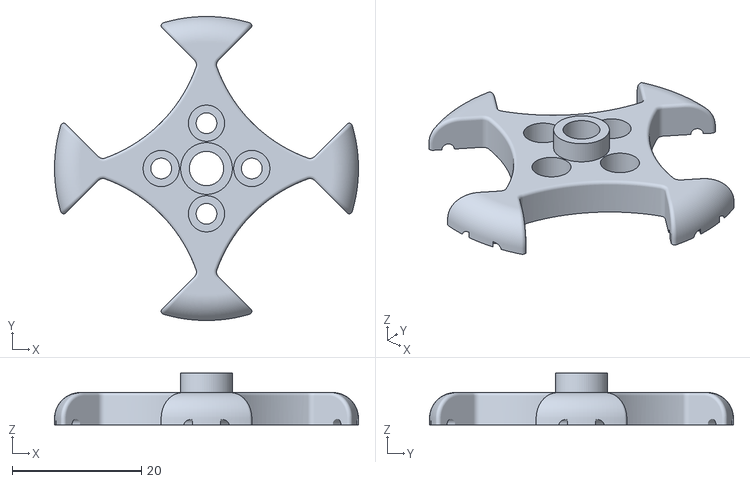
[picture p140: CAD file, 2023-01-24]
Mini 2-3-2 R2-D2/STL_s/Omniwheels/Omniwheel 50mm Part D.STL
47.0 x 47.0 x 8.00
