tekfufu/mini-R2D2/Mini R2/R2 Body/MZ Wheel Rev 2.STL

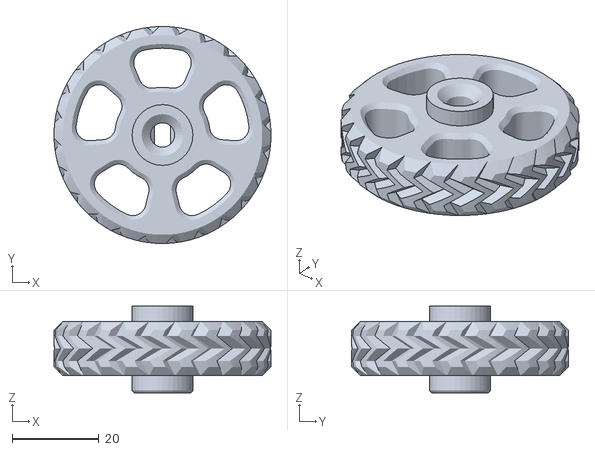
[picture p141: CAD file, 2023-01-24]
Mini R2/R2 Body/MZ Wheel Rev 2.STL
50.0 x 50.0 x 20.0
