tekfufu/mini-R2D2/Mini 2-3-2 R2-D2/STL_s/Body/Base.STL

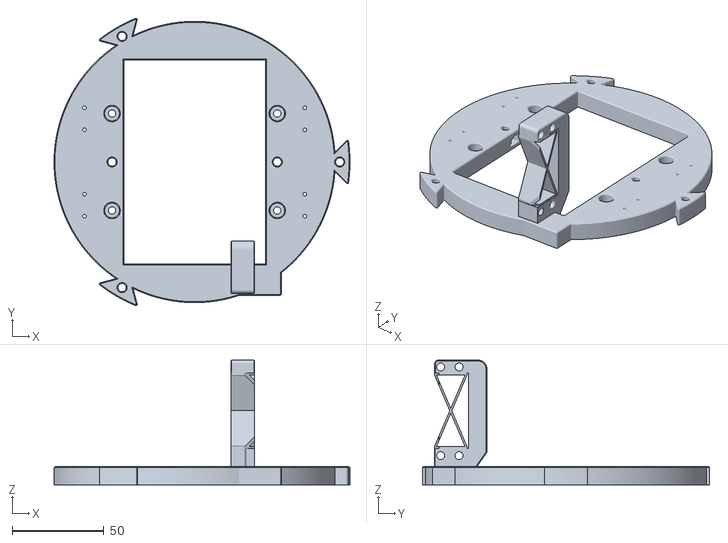
[picture p145: CAD file, 2023-01-24]
Mini 2-3-2 R2-D2/STL_s/Body/Base.STL
161.2 x 156.6 x 68.1
