tekfufu/mini-R2D2/Mini 2-3-2 R2-D2/STL_s/Centre Lift/Centre Leg Top.STL

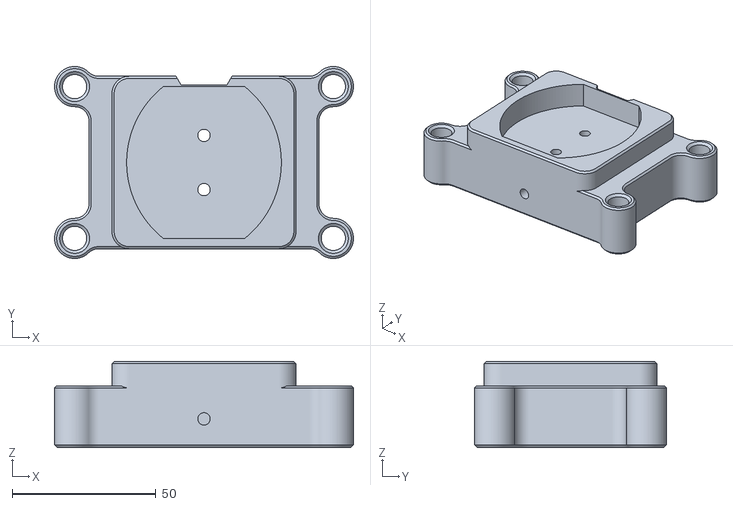
[picture p146: CAD file, 2023-01-24]
Mini 2-3-2 R2-D2/STL_s/Centre Lift/Centre Leg Top.STL
104.0 x 66.8 x 30.0
