tekfufu/mini-R2D2/Mini 2-3-2 R2-D2/STL_s/Dome with Periscope/R2 Mini Periscope - Base_s v2.STL

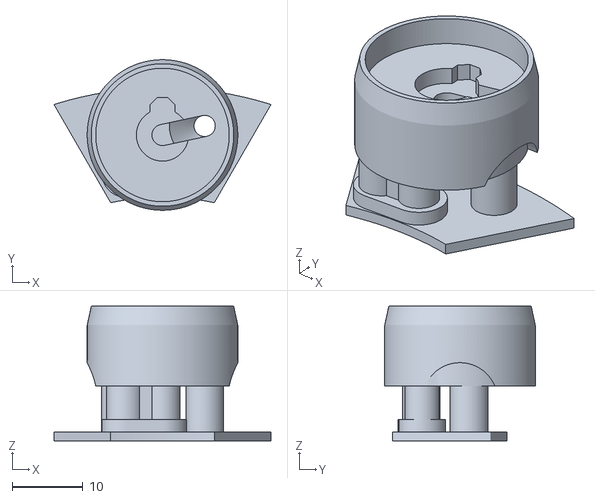
[picture p147: CAD file, 2023-01-24]
Mini 2-3-2 R2-D2/STL_s/Dome with Periscope/R2 Mini Periscope - Base_s v2.STL
30.7 x 21.3 x 19.1
