tekfufu/mini-R2D2/Mini R2/R2 Body/Front Castor Tyre.STL

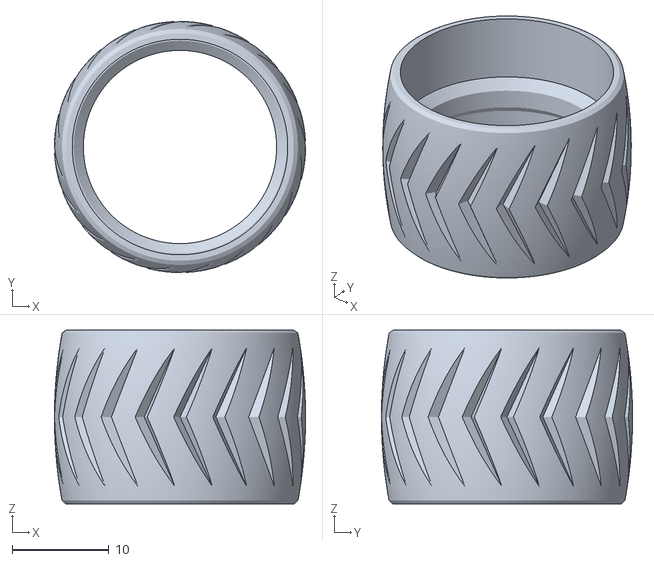
[picture p148: CAD file, 2023-01-24]
Mini R2/R2 Body/Front Castor Tyre.STL
26.0 x 26.0 x 18.0
