tekfufu/mini-R2D2/(list of files, cad)

Other CAD files:
Mini 2-3-2 R2-D2/Resin Print Cut by Christophe Kormann/Battery Box/Right/PLA/Body17.stl
Mini 2-3-2 R2-D2/Resin Print Cut by Christophe Kormann/Legs/Left/PLA/Body1.stl
Mini 2-3-2 R2-D2/Resin Print Cut by Christophe Kormann/Legs/Right/PLA/Body35.stl
Mini R2/Moveable Holos/R2 Holo Ball for Addressable LED.STL
Mini R2/R2 Body/Single Piece Legs/MZ R2_D2 Right Leg.STL
Mini 2-3-2 R2-D2/STL_s/Dome with Periscope/LED inserts/Front Logic 1.STL
Mini R2/R2 Dome with LED lights/Front Logic 1.STL
Mini 2-3-2 R2-D2/Resin Print Cut by Christophe Kormann/Legs/Left/Resin/Body30.stl
Mini 2-3-2 R2-D2/Resin Print Cut by Christophe Kormann/Legs/Right/Resin/Body14.stl
Mini 2-3-2 R2-D2/STL_s/Dome with Periscope/Moveable Holos/R2 Holo Ball for Addressable LED.STL
Mini R2/R2 Body/MZ R2_D2 Right Leg Upper.STL
Mini 2-3-2 R2-D2/Resin Print Cut by Christophe Kormann/Legs/Left/Resin/Body56.stl
Mini 2-3-2 R2-D2/Resin Print Cut by Christophe Kormann/Legs/Left/Resin/Body29.stl
Mini 2-3-2 R2-D2/STL_s/Legs/R2 2-3-2 Right Leg Inner.STL
Mini R2/R2 Body/Front Caster Axle.STL
Mini 2-3-2 R2-D2/Resin Print Cut by Christophe Kormann/Legs/Right/Resin/Body48.stl
Mini 2-3-2 R2-D2/STL_s/Dome with Periscope/Periscope Servo Linkage.STL
Mini 2-3-2 R2-D2/STL_s/Legs/R2 2-3-2 Left Battery Box.STL
Mini 2-3-2 R2-D2/Resin Print Cut by Christophe Kormann/Legs/Left/Resin/Body53.stl
Mini 2-3-2 R2-D2/STL_s/Legs/R2 2-3-2 Left Foot_s.STL
Mini 2-3-2 R2-D2/Resin Print Cut by Christophe Kormann/Body/Resin/Body140 rear left.stl
Mini 2-3-2 R2-D2/Resin Print Cut by Christophe Kormann/Body/Resin/Body177 rear.stl
Mini 2-3-2 R2-D2/Resin Print Cut by Christophe Kormann/Body/Resin/Body181 front.stl
Mini 2-3-2 R2-D2/Resin Print Cut by Christophe Kormann/Body/Resin/Body44 front.stl
Mini 2-3-2 R2-D2/Resin Print Cut by Christophe Kormann/Body/Resin/Body73 right.stl
Mini 2-3-2 R2-D2/Resin Print Cut by Christophe Kormann/Dome/Resin/Body1.stl
Mini 2-3-2 R2-D2/Resin Print Cut by Christophe Kormann/Dome/Resin/Body111.stl
Mini 2-3-2 R2-D2/Resin Print Cut by Christophe Kormann/Dome/Resin/Body117.stl
Mini 2-3-2 R2-D2/Resin Print Cut by Christophe Kormann/Dome/Resin/Body12.stl
Mini 2-3-2 R2-D2/Resin Print Cut by Christophe Kormann/Dome/Resin/Body13.stl
Mini 2-3-2 R2-D2/Resin Print Cut by Christophe Kormann/Dome/Resin/Body131.stl
Mini 2-3-2 R2-D2/Resin Print Cut by Christophe Kormann/Dome/Resin/Body132.stl
Mini 2-3-2 R2-D2/Resin Print Cut by Christophe Kormann/Dome/Resin/Body147.stl
Mini 2-3-2 R2-D2/Resin Print Cut by Christophe Kormann/Dome/Resin/Body149.stl
Mini 2-3-2 R2-D2/Resin Print Cut by Christophe Kormann/Dome/Resin/Body154.stl
Mini 2-3-2 R2-D2/Resin Print Cut by Christophe Kormann/Dome/Resin/Body2 X4.stl
Mini 2-3-2 R2-D2/Resin Print Cut by Christophe Kormann/Dome/Resin/Body32.stl
Mini 2-3-2 R2-D2/Resin Print Cut by Christophe Kormann/Dome/Resin/Body37.stl
Mini 2-3-2 R2-D2/Resin Print Cut by Christophe Kormann/Dome/Resin/Body43.stl
Mini 2-3-2 R2-D2/Resin Print Cut by Christophe Kormann/Dome/Resin/Body60.stl
Mini 2-3-2 R2-D2/Resin Print Cut by Christophe Kormann/Dome/Resin/Body66.stl
Mini 2-3-2 R2-D2/Resin Print Cut by Christophe Kormann/Dome/Resin/Body79.stl
Mini 2-3-2 R2-D2/Resin Print Cut by Christophe Kormann/Dome/Resin/Body87.stl
Mini 2-3-2 R2-D2/Resin Print Cut by Christophe Kormann/Dome/Resin/Body97.stl
Mini 2-3-2 R2-D2/Resin Print Cut by Christophe Kormann/Legs/Left/Resin/Body2.stl
Mini 2-3-2 R2-D2/Resin Print Cut by Christophe Kormann/Legs/Left/Resin/Body39.stl
Mini 2-3-2 R2-D2/Resin Print Cut by Christophe Kormann/Legs/Left/Resin/Body48.stl
Mini 2-3-2 R2-D2/Resin Print Cut by Christophe Kormann/Legs/Left/Resin/Body50.stl
Mini 2-3-2 R2-D2/Resin Print Cut by Christophe Kormann/Legs/Right/Resin/Body16.stl
Mini 2-3-2 R2-D2/Resin Print Cut by Christophe Kormann/Legs/Right/Resin/Body3.stl
Mini 2-3-2 R2-D2/Resin Print Cut by Christophe Kormann/Legs/Right/Resin/Body39.stl
Mini 2-3-2 R2-D2/Resin Print Cut by Christophe Kormann/Legs/Right/Resin/Body46.stl
Mini 2-3-2 R2-D2/STL_s/Body/Battery Mount.STL
Mini 2-3-2 R2-D2/STL_s/Body/Hub B.STL
Mini 2-3-2 R2-D2/STL_s/Body/MZ R2_D2_Body_2-3-2.STL
Mini 2-3-2 R2-D2/STL_s/Legs/R2 2-3-2 Right Leg.STL
Mini R2/R2 Body/Front Castor Fork.STL
Mini R2/R2 Body/MZ R2-D2 Centre Foot Ankle Cylinders x 2.STL
Mini R2/R2 Body/MZ R2_D2 Left Battery Box.STL
Mini R2/R2 Body/MZ R2_D2 Left Leg Lower.STL
