tekfufu/mini-R2D2/Mini 2-3-2 R2-D2/Drawings, Assembly _ Code/2-3-2 Mini R2 Assembly Version 1.PDF

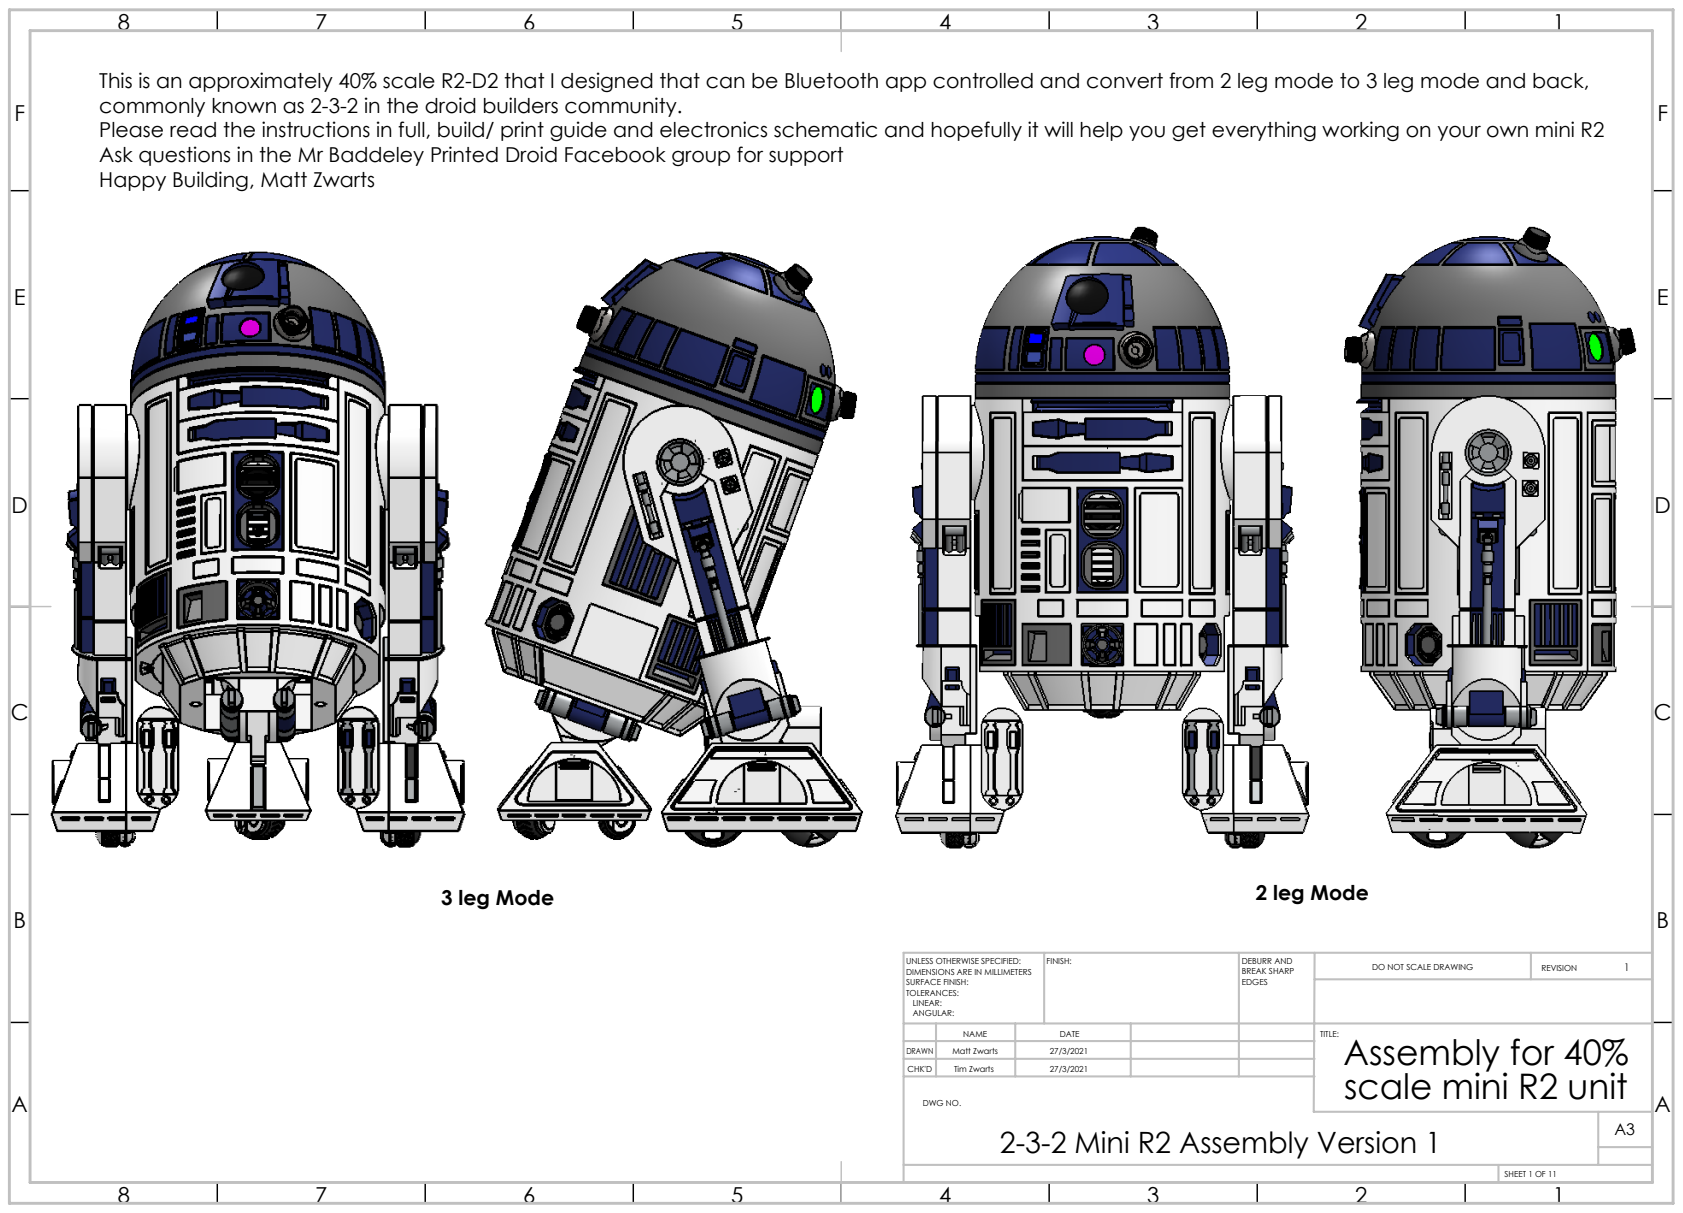
[picture p149: page 1]
3 leg Mode; 2 leg Mode; FINISH:; DEBURR AND; BREAK SHARP; DO NOT SCALE DRAWING; REVISION; SHEET 1 OF 11

This is an approximately 40% scale R2-D2 that I designed that can be Bluetooth app controlled and convert from 2 leg mode to 3 leg mode and back,
commonly known as 2-3-2 in the droid builders community.

Please read the instructions in full, build/ print guide and electronics schematic and hopefully it will help you get everything working on your own mini R2
Ask questions in the Mr Baddeley Printed Droid Facebook group for support
Happy Building, Matt Zwarts

UNLESS OTHERWISE SPECIFIED:
DIMENSIONS ARE IN MILLIMETERS
SURFACE FINISH:
TOLERANCES:
LINEAR:
ANGULAR:

NAME | DATE | TITLE: Assembly for 40% scale mini R2 unit

DRAWN | Matt Zwarts | 27/3/2021
CHK'D | Tim Zwarts | 27/3/2021

DWG NO.
2-3-2 Mini R2 Assembly Version 1

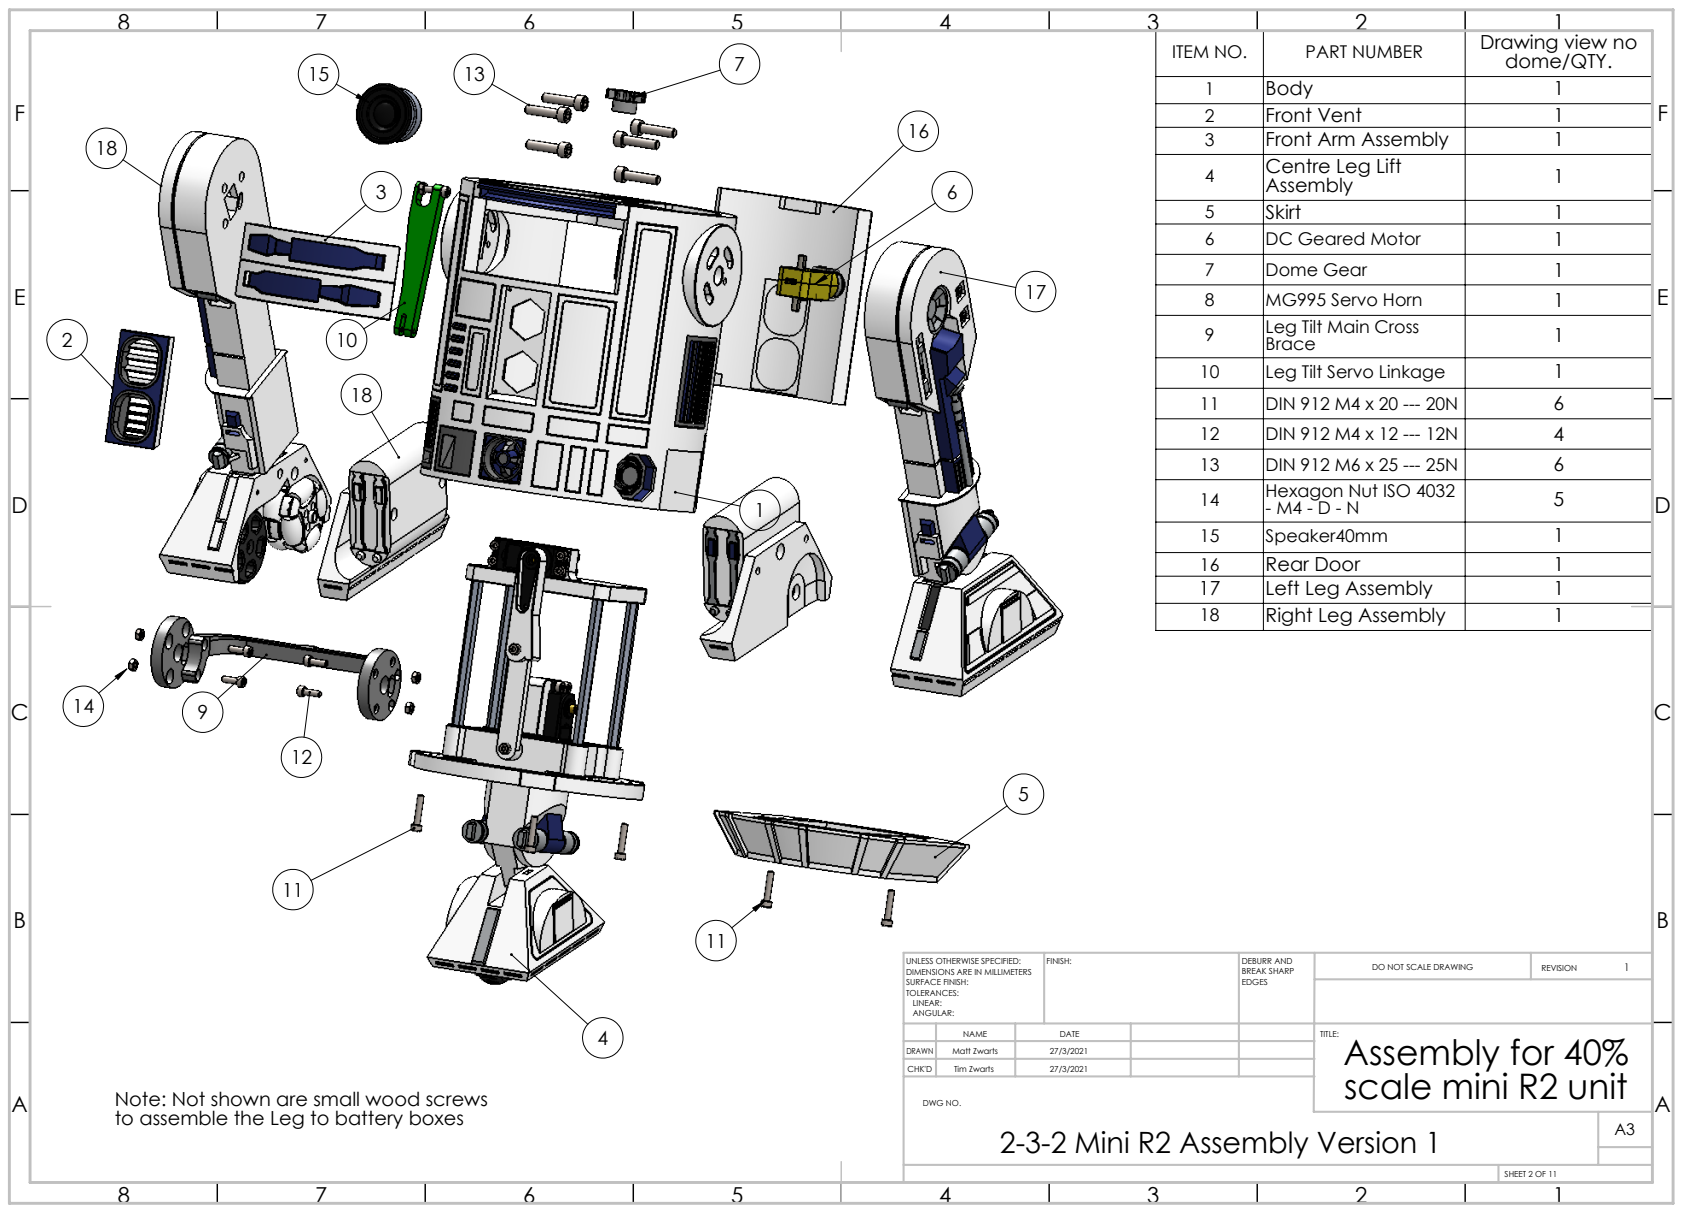
[picture p150: page 2]
FINISH:; DEBURR AND; BREAK SHARP; DO NOT SCALE DRAWING; REVISION; DWG NO.

ITEM NO. | PART NUMBER | Drawing view no dome/QTY.
1 | Body | 1
2 | Front Vent | 1
3 | Front Arm Assembly | 1
4 | Centre Leg Lift Assembly | 1
5 | Skirt | 1
6 | DC Geared Motor | 1
7 | Dome Gear | 1
8 | MG995 Servo Horn | 1
9 | Leg Tilt Main Cross Brace | 1
10 | Leg Tilt Servo Linkage | 1
11 | DIN 912 M4 x 20 --- 20N | 6
12 | DIN 912 M4 x 12 --- 12N | 4
13 | DIN 912 M6 x 25 --- 25N | 6
14 | Hexagon Nut ISO 4032 - M4 - D - N | 5
15 | Speaker40mm | 1
16 | Rear Door | 1
17 | Left Leg Assembly | 1
18 | Right Leg Assembly | 1

UNLESS OTHERWISE SPECIFIED:
DIMENSIONS ARE IN MILLIMETERS
SURFACE FINISH:
TOLERANCES:
LINEAR:
ANGULAR:

NAME | DATE | TITLE: Assembly for 40% scale mini R2 unit

DRAWN | Matt Zwarts | 27/3/2021
CHK'D | Tim Zwarts | 27/3/2021

Note: Not shown are small wood screws
to assemble the Leg to battery boxes

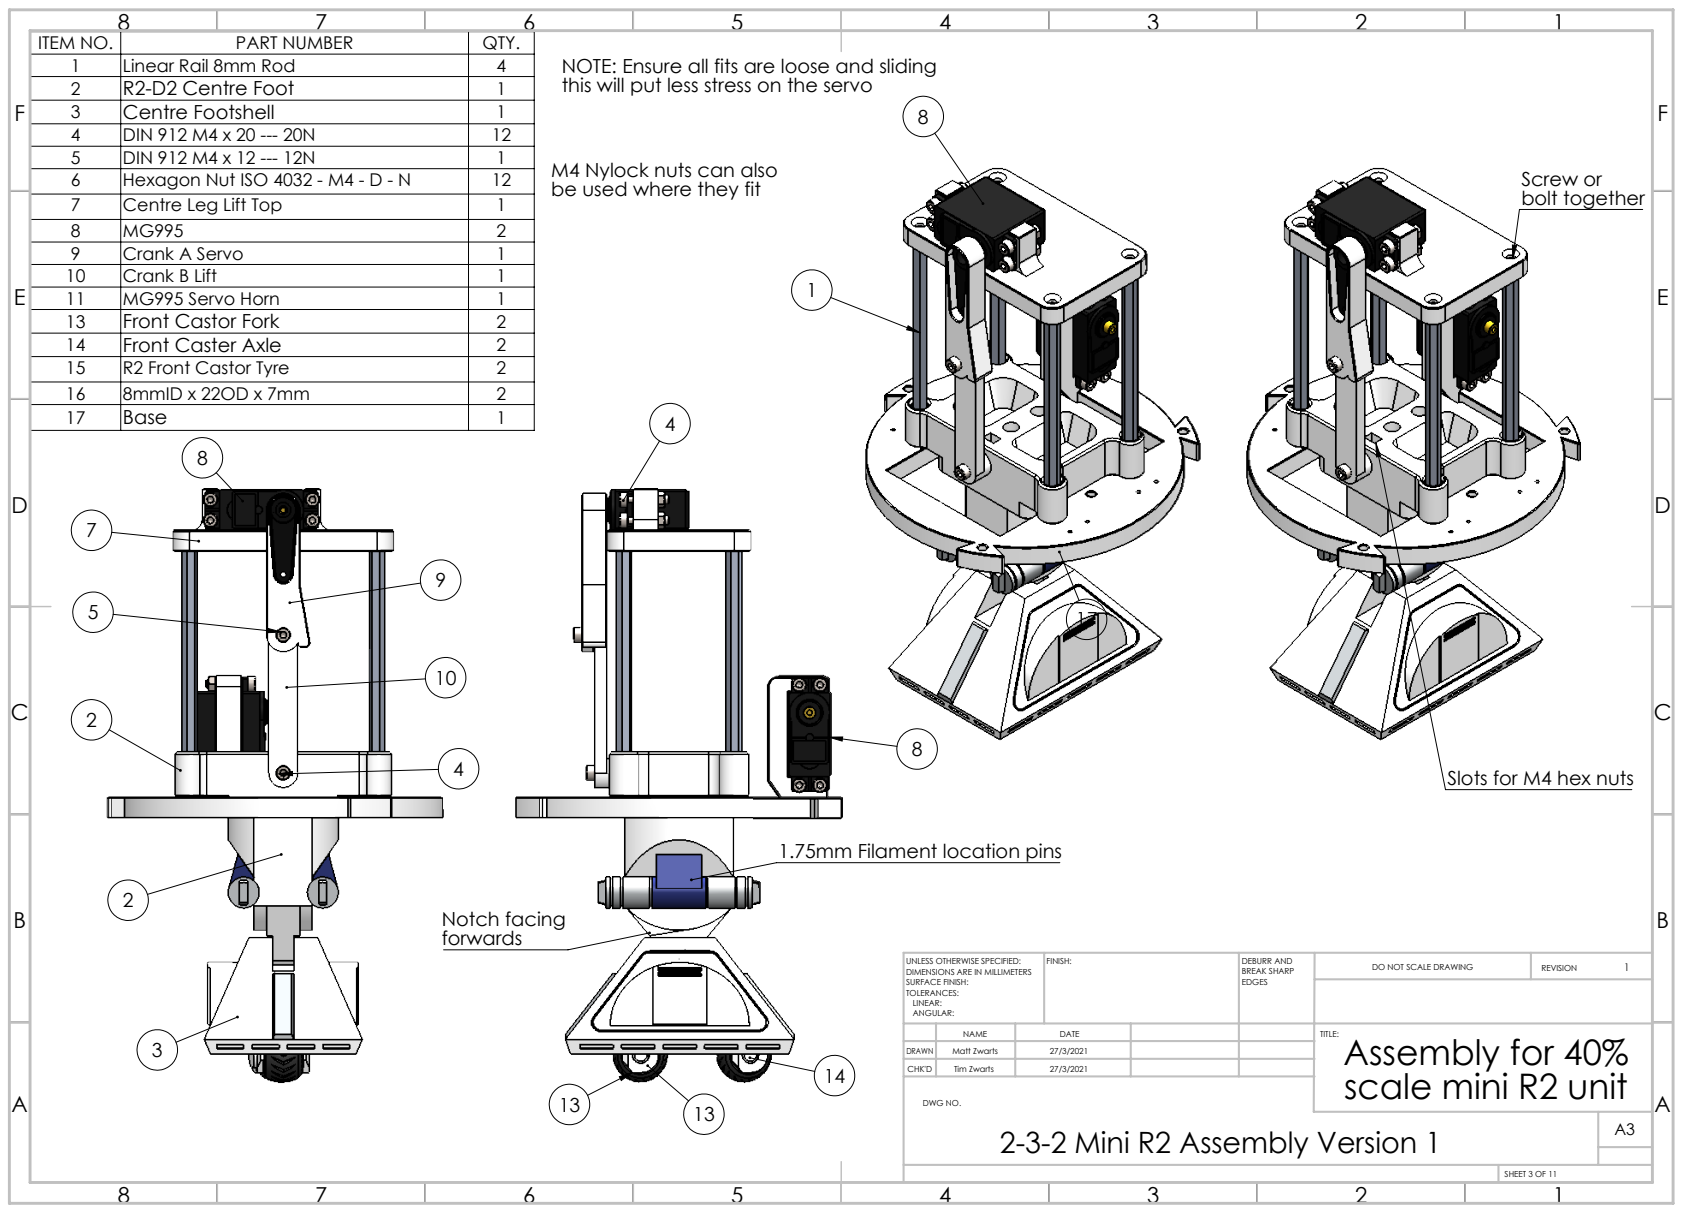
[picture p151: page 3]
Notch facing; Screw or bolt together; FINISH:; DEBURR AND; BREAK SHARP; DO NOT SCALE DRAWING; REVISION; DWG NO.

ITEM NO. | PART NUMBER | QTY.
1 | Linear Rail 8mm Rod | 4
2 | R2-D2 Centre Foot | 1
3 | Centre Footshell | 1
4 | DIN 912 M4 x 20 --- 20N | 12
5 | DIN 912 M4 x 12 --- 12N | 1
6 | Hexagon Nut ISO 4032 - M4 - D - N | 12
7 | Centre Leg Lift Top | 1
8 | MG995 | 2
9 | Crank A Servo | 1
10 | Crank B Lift | 1
11 | MG995 Servo Horn | 1
13 | Front Castor Fork | 2
14 | Front Caster Axle | 2
15 | R2 Front Castor Tyre | 2
16 | 8mmID x 22OD x 7mm | 2
17 | Base | 1

NOTE: Ensure all fits are loose and sliding
this will put less stress on the servo

M4 Nylock nuts can also
be used where they fit

Slots for M4 hex nuts

1.75mm Filament location pins

UNLESS OTHERWISE SPECIFIED:
DIMENSIONS ARE IN MILLIMETERS
SURFACE FINISH:
TOLERANCES:
LINEAR:
ANGULAR:

NAME | DATE | TITLE: Assembly for 40% scale mini R2 unit

DRAWN | Matt Zwarts | 27/3/2021
CHK'D | Tim Zwarts | 27/3/2021

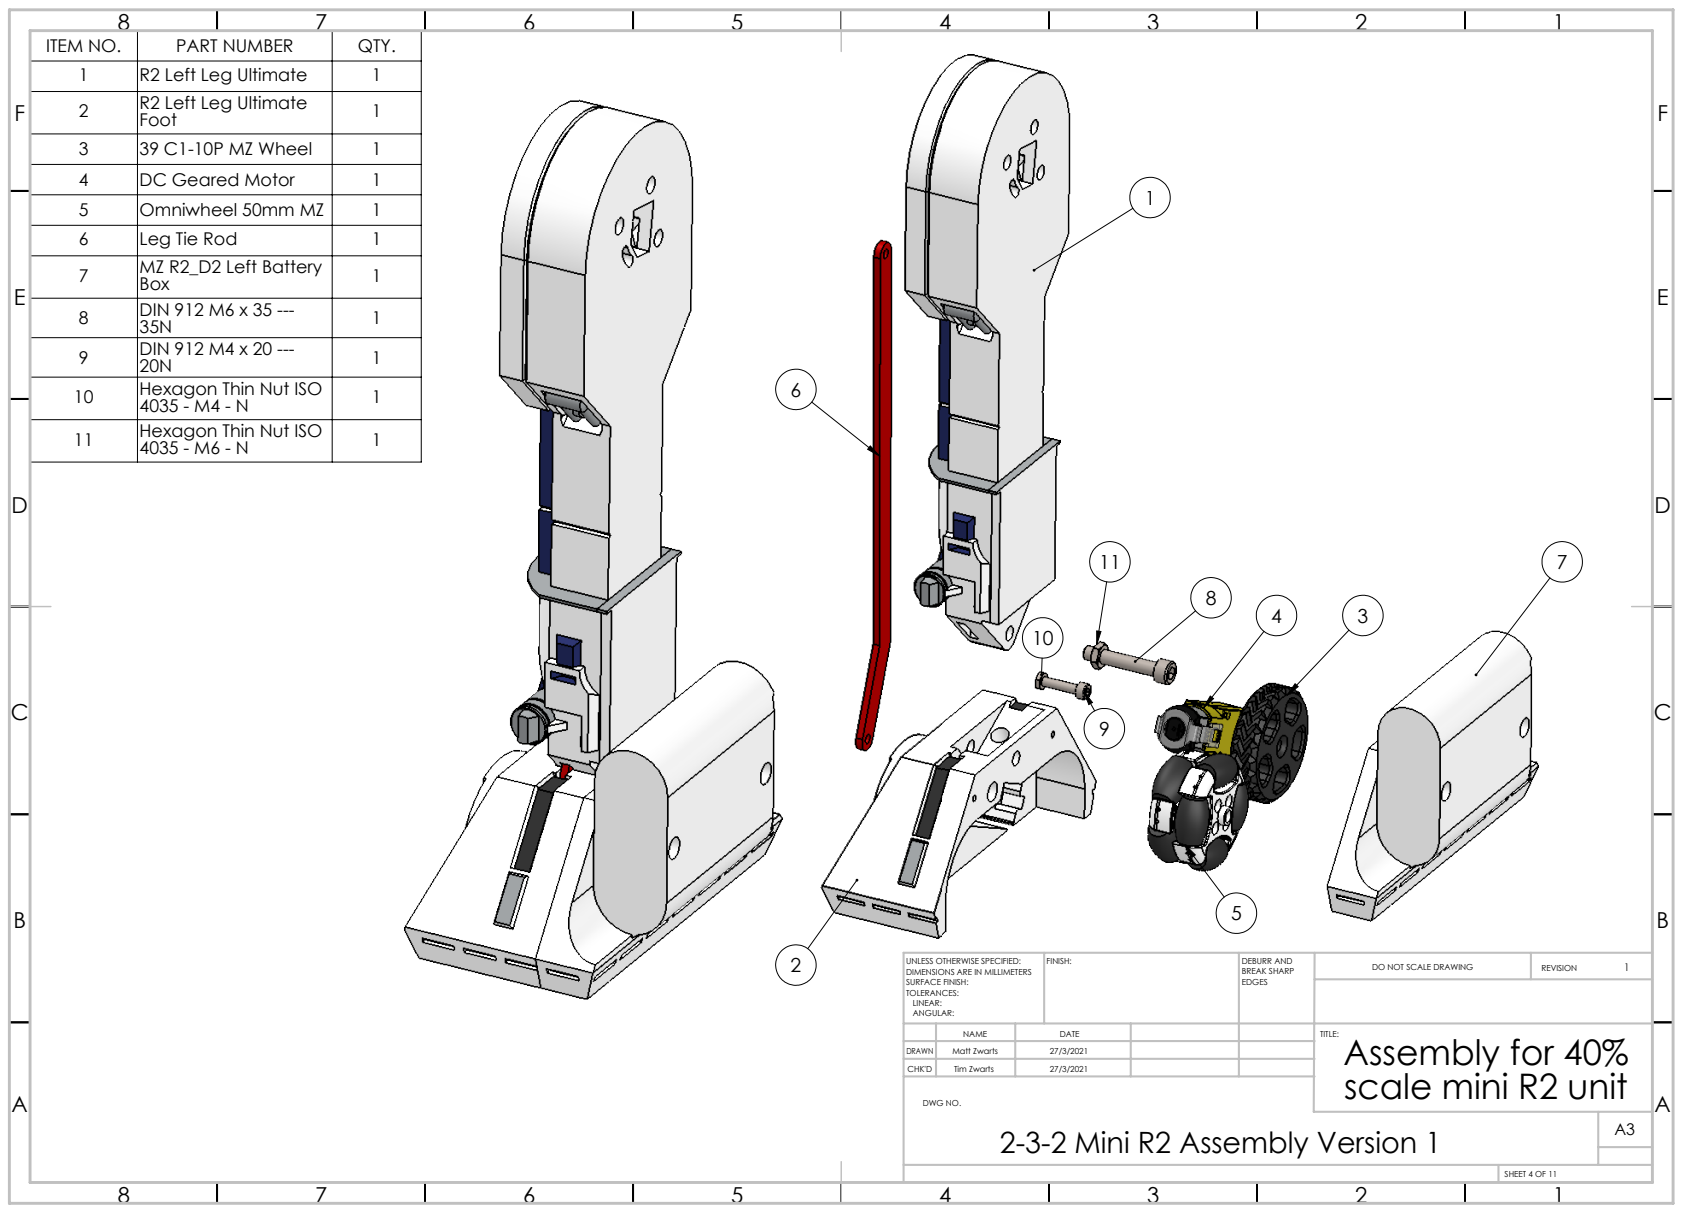
[picture p152: page 4]
FINISH:; DEBURR AND; BREAK SHARP; DO NOT SCALE DRAWING; REVISION; DWG NO.

ITEM NO. | PART NUMBER | QTY.
1 | R2 Left Leg Ultimate | 1
2 | R2 Left Leg Ultimate Foot | 1

3 | 39 C1-10P MZ Wheel | 1
4 | DC Geared Motor | 1
5 | Omniwheel 50mm MZ | 1
6 | Leg Tie Rod | 1
7 | MZ R2_D2 Left Battery Box | 1
8 | DIN 912 M6 x 35 ---35N | 1
9 | DIN 912 M4 x 20 ---20N | 1
10 | Hexagon Thin Nut ISO 4035 - M4 - N | 1
11 | Hexagon Thin Nut ISO 4035 - M6 - N | 1

UNLESS OTHERWISE SPECIFIED:
DIMENSIONS ARE IN MILLIMETERS
SURFACE FINISH:
TOLERANCES:
LINEAR:
ANGULAR:

NAME | DATE | TITLE: Assembly for 40% scale mini R2 unit

DRAWN | Matt Zwarts | 27/3/2021
CHK'D | Tim Zwarts | 27/3/2021

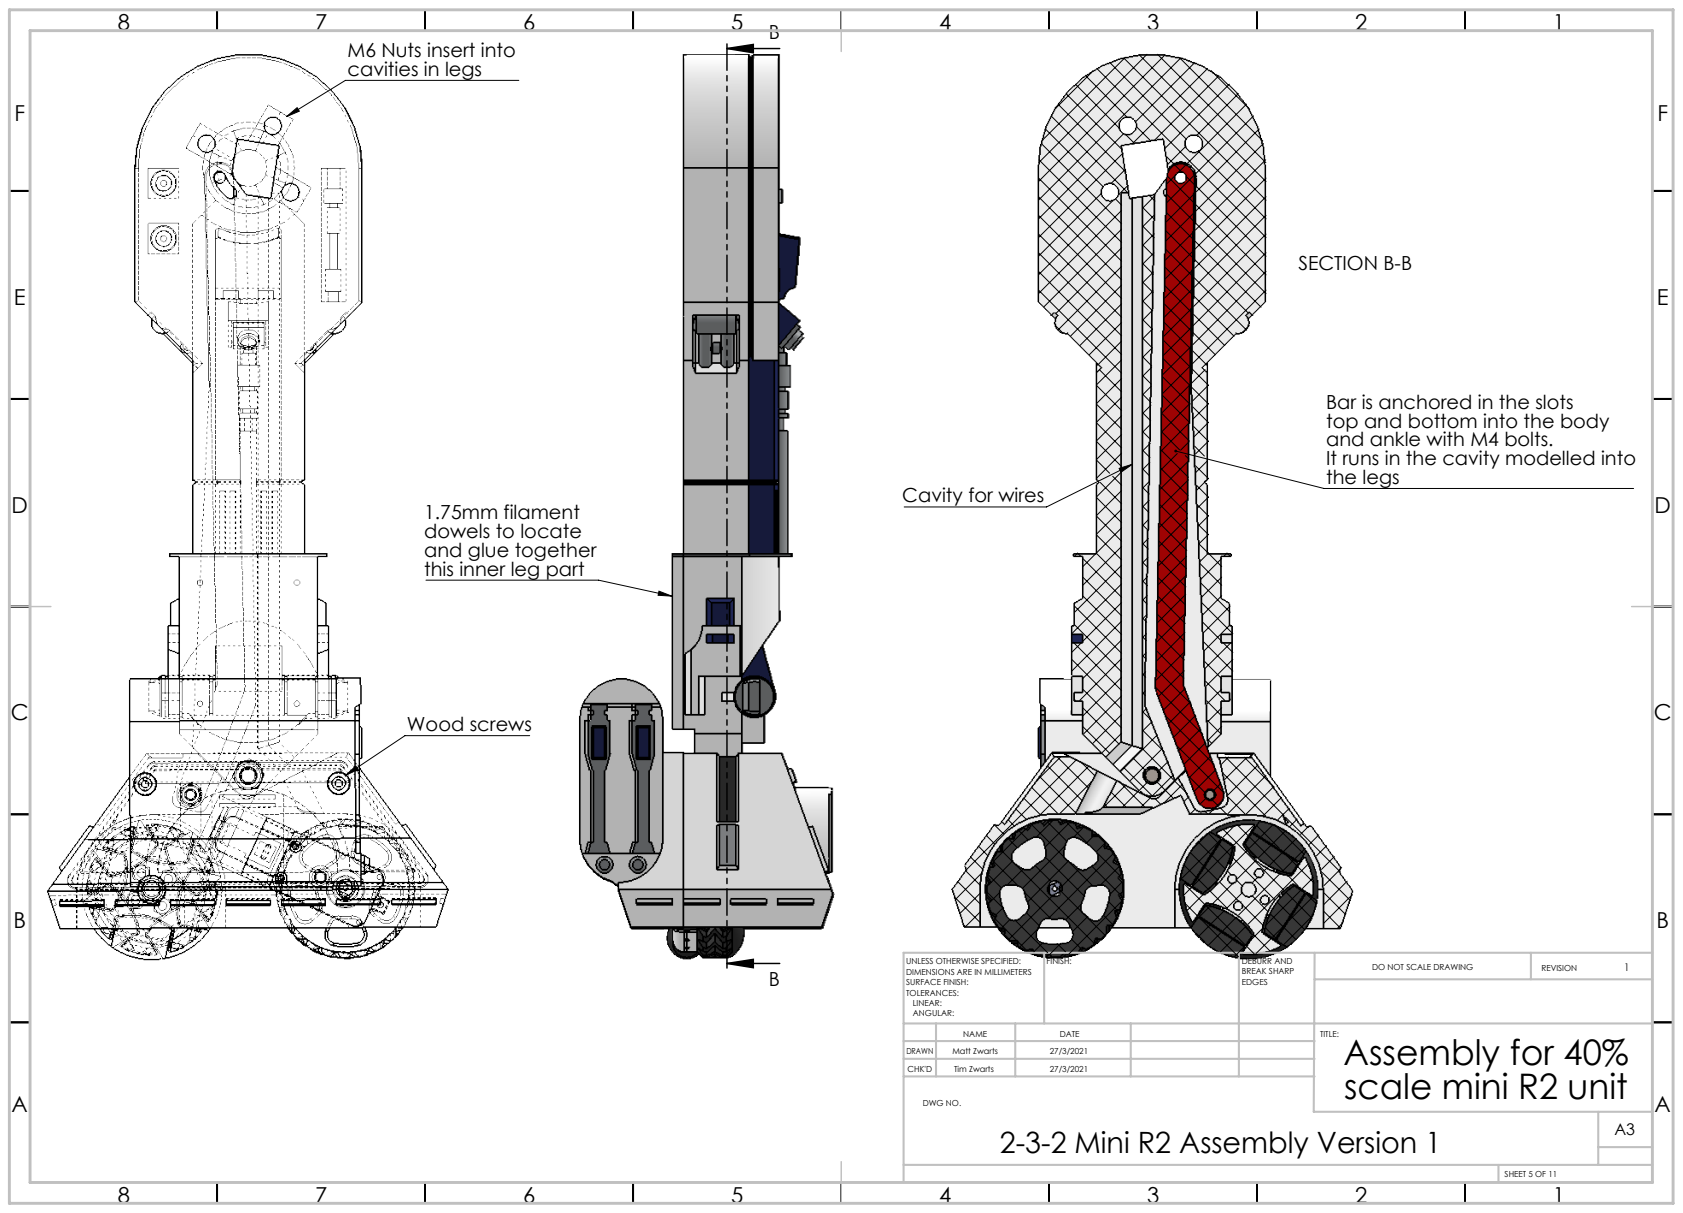
[picture p153: page 5]
Wood screws; SECTION B-B; FINISH:; DEBURR AND; BREAK SHARP; DO NOT SCALE DRAWING; REVISION; DWG NO.

M6 Nuts insert into
cavities in legs

Bar is anchored in the slots
top and bottom into the body
and ankle with M4 bolts.
It runs in the cavity modelled into

the legs Cavity for wires

1.75mm filament
dowels to locate
and glue together
this inner leg part

UNLESS OTHERWISE SPECIFIED:
DIMENSIONS ARE IN MILLIMETERS
SURFACE FINISH:
TOLERANCES:
LINEAR:
ANGULAR:

NAME | DATE | TITLE: Assembly for 40% scale mini R2 unit

DRAWN | Matt Zwarts | 27/3/2021
CHK'D | Tim Zwarts | 27/3/2021

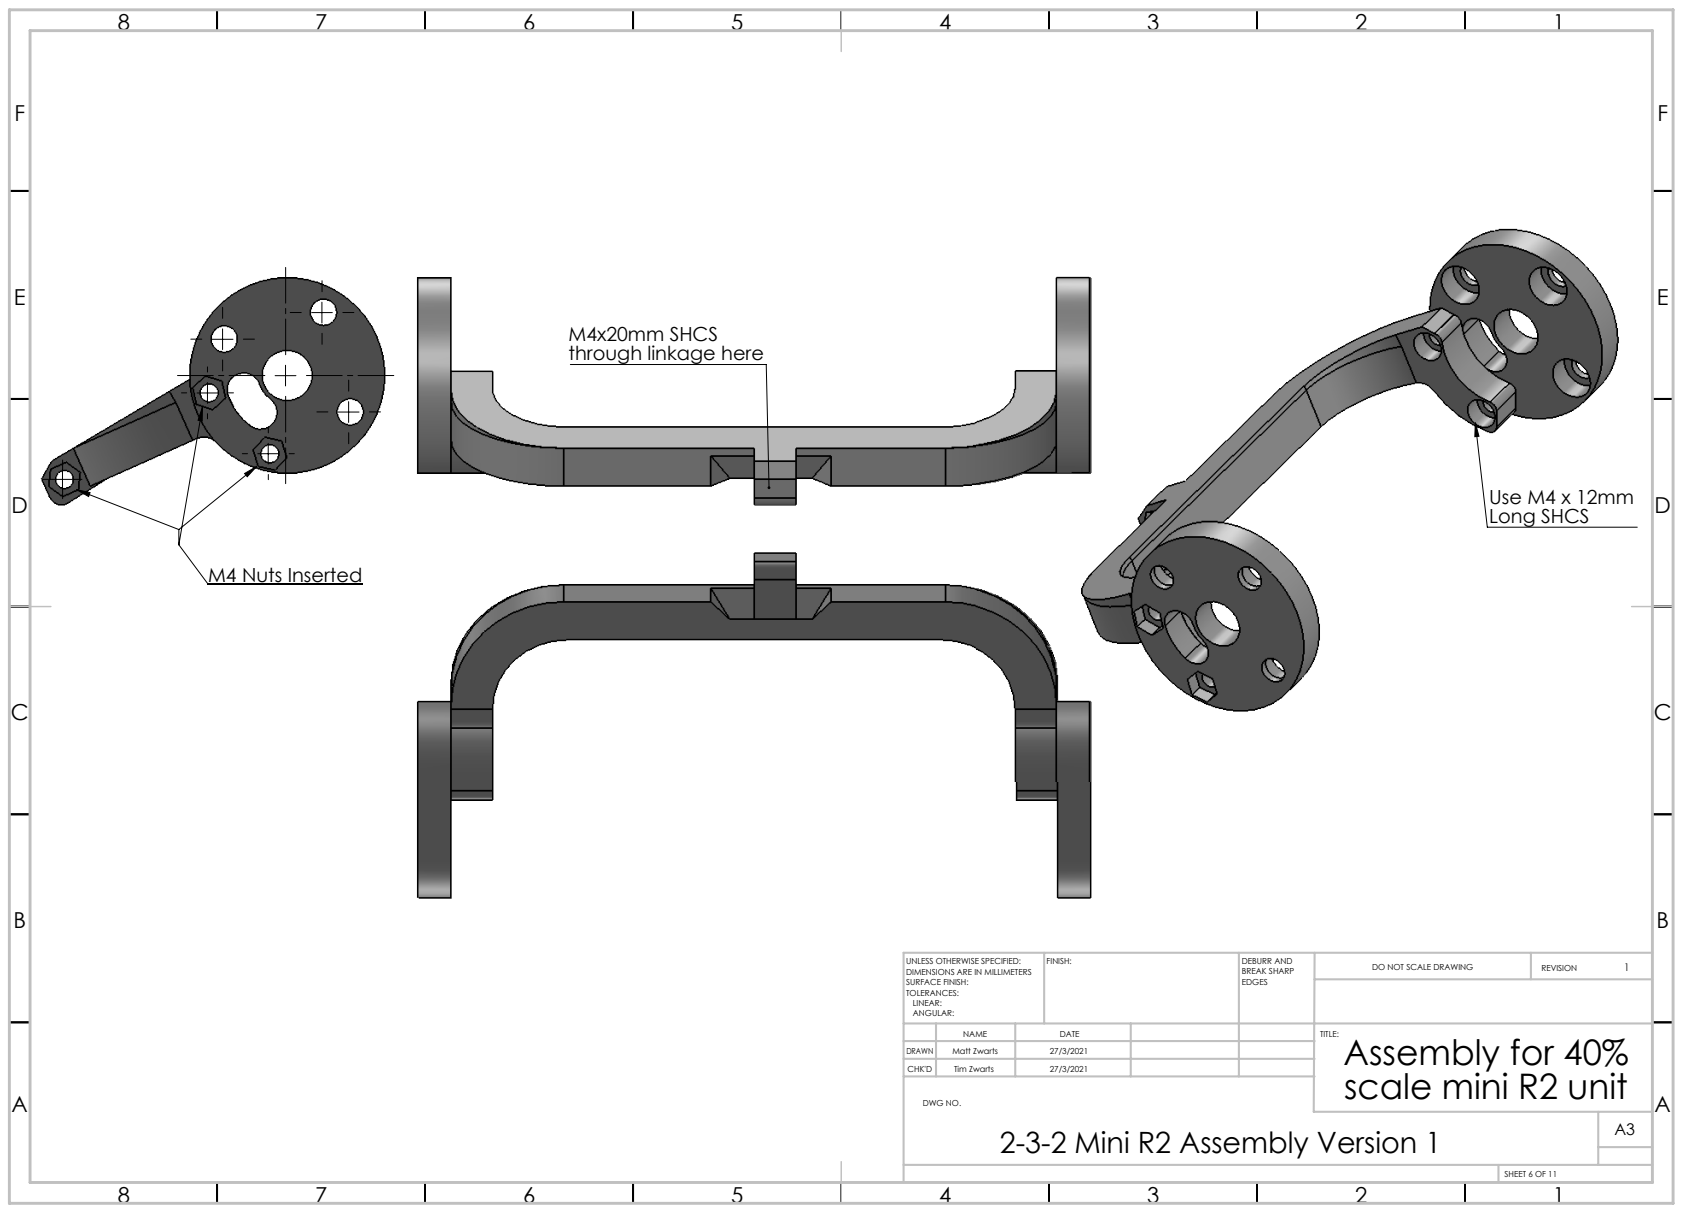
[picture p154: page 6]
M4 Nuts Inserted; Use M4 x 12mm Long SHCS; FINISH:; DEBURR AND; BREAK SHARP; DO NOT SCALE DRAWING; REVISION; DWG NO.

M4x20mm SHCS
through linkage here

UNLESS OTHERWISE SPECIFIED:
DIMENSIONS ARE IN MILLIMETERS
SURFACE FINISH:
TOLERANCES:
LINEAR:
ANGULAR:

NAME | DATE | TITLE: Assembly for 40% scale mini R2 unit

DRAWN | Matt Zwarts | 27/3/2021
CHK'D | Tim Zwarts | 27/3/2021

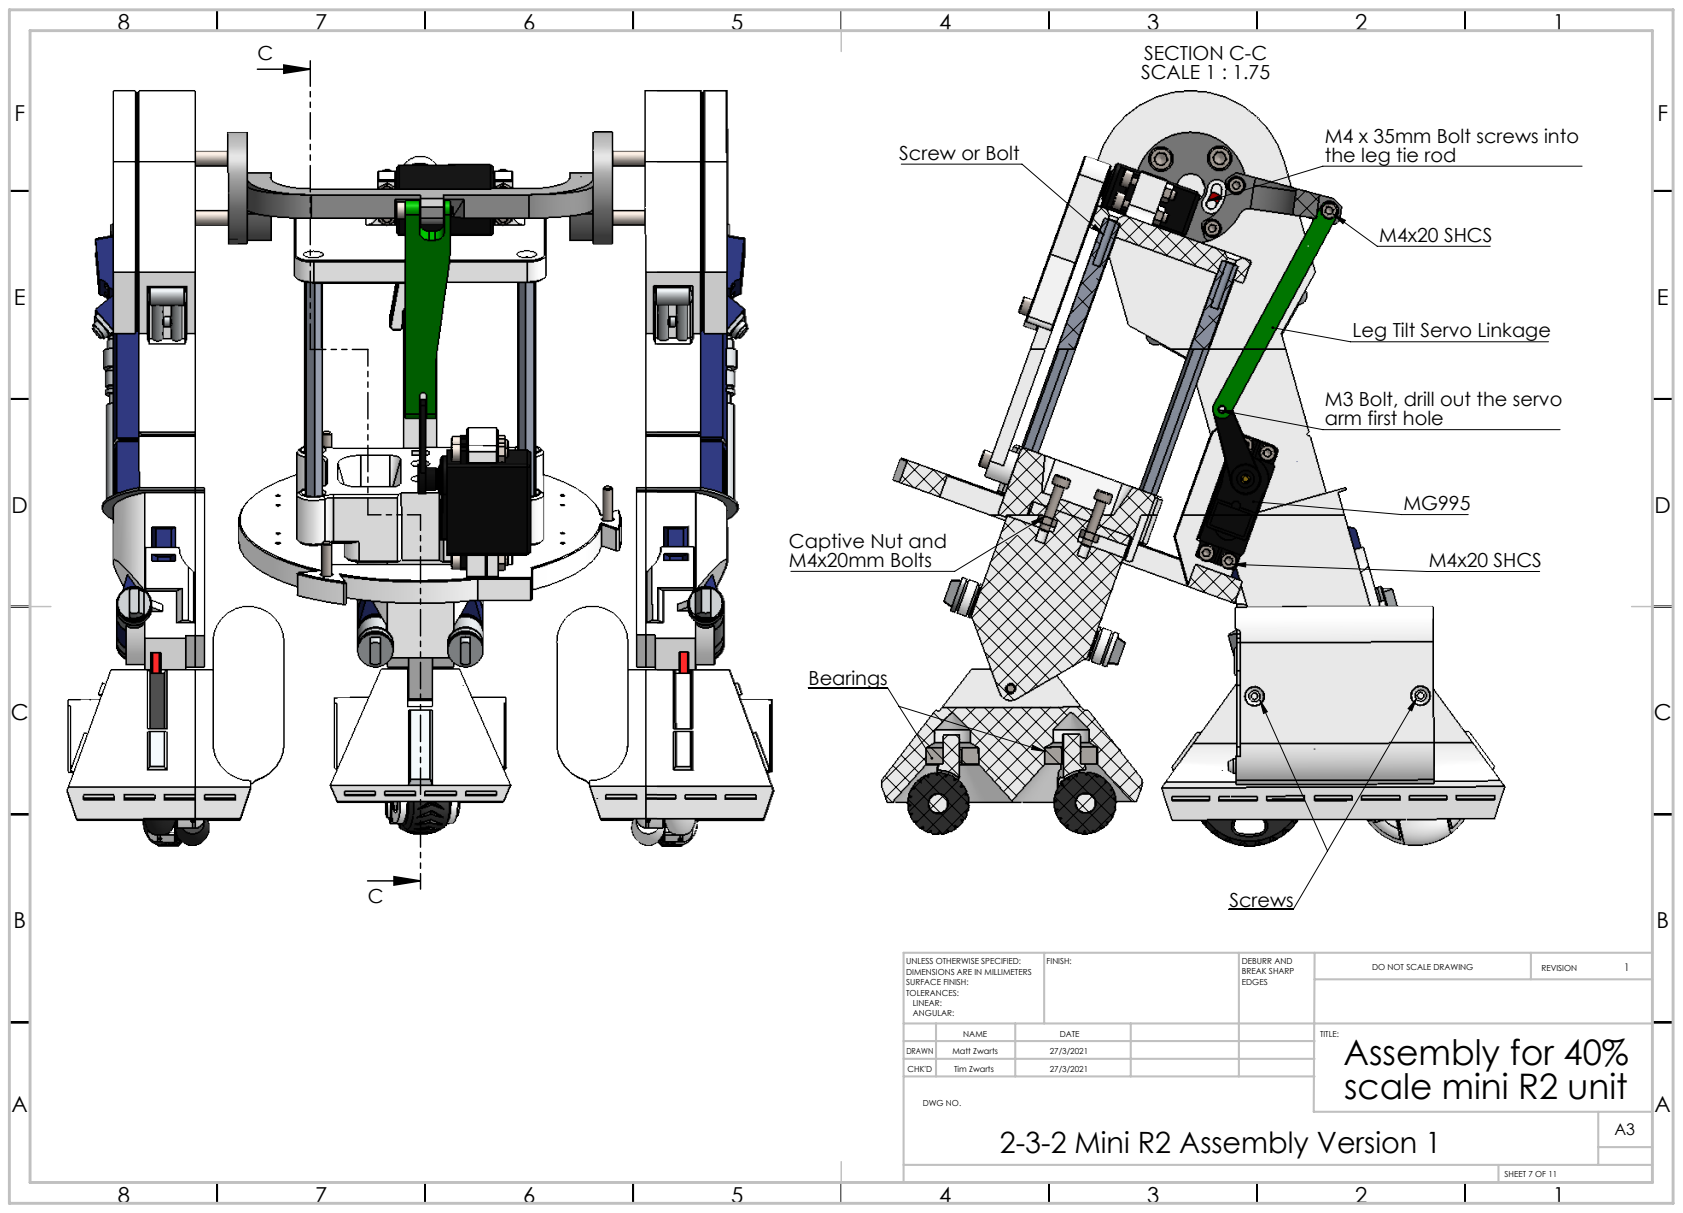
[picture p155: page 7]
SECTION C-C SCALE 1 : 1.75; M4x20 SHCS; FINISH:; DEBURR AND; BREAK SHARP; DO NOT SCALE DRAWING; REVISION; DWG NO.

M4 x 35mm Bolt screws into
the leg tie rod

Screw or Bolt

Leg Tilt Servo Linkage

M3 Bolt, drill out the servo
arm first hole

Captive Nut and
M4x20mm Bolts

UNLESS OTHERWISE SPECIFIED:
DIMENSIONS ARE IN MILLIMETERS
SURFACE FINISH:
TOLERANCES:
LINEAR:
ANGULAR:

NAME | DATE | TITLE: Assembly for 40% scale mini R2 unit

DRAWN | Matt Zwarts | 27/3/2021
CHK'D | Tim Zwarts | 27/3/2021

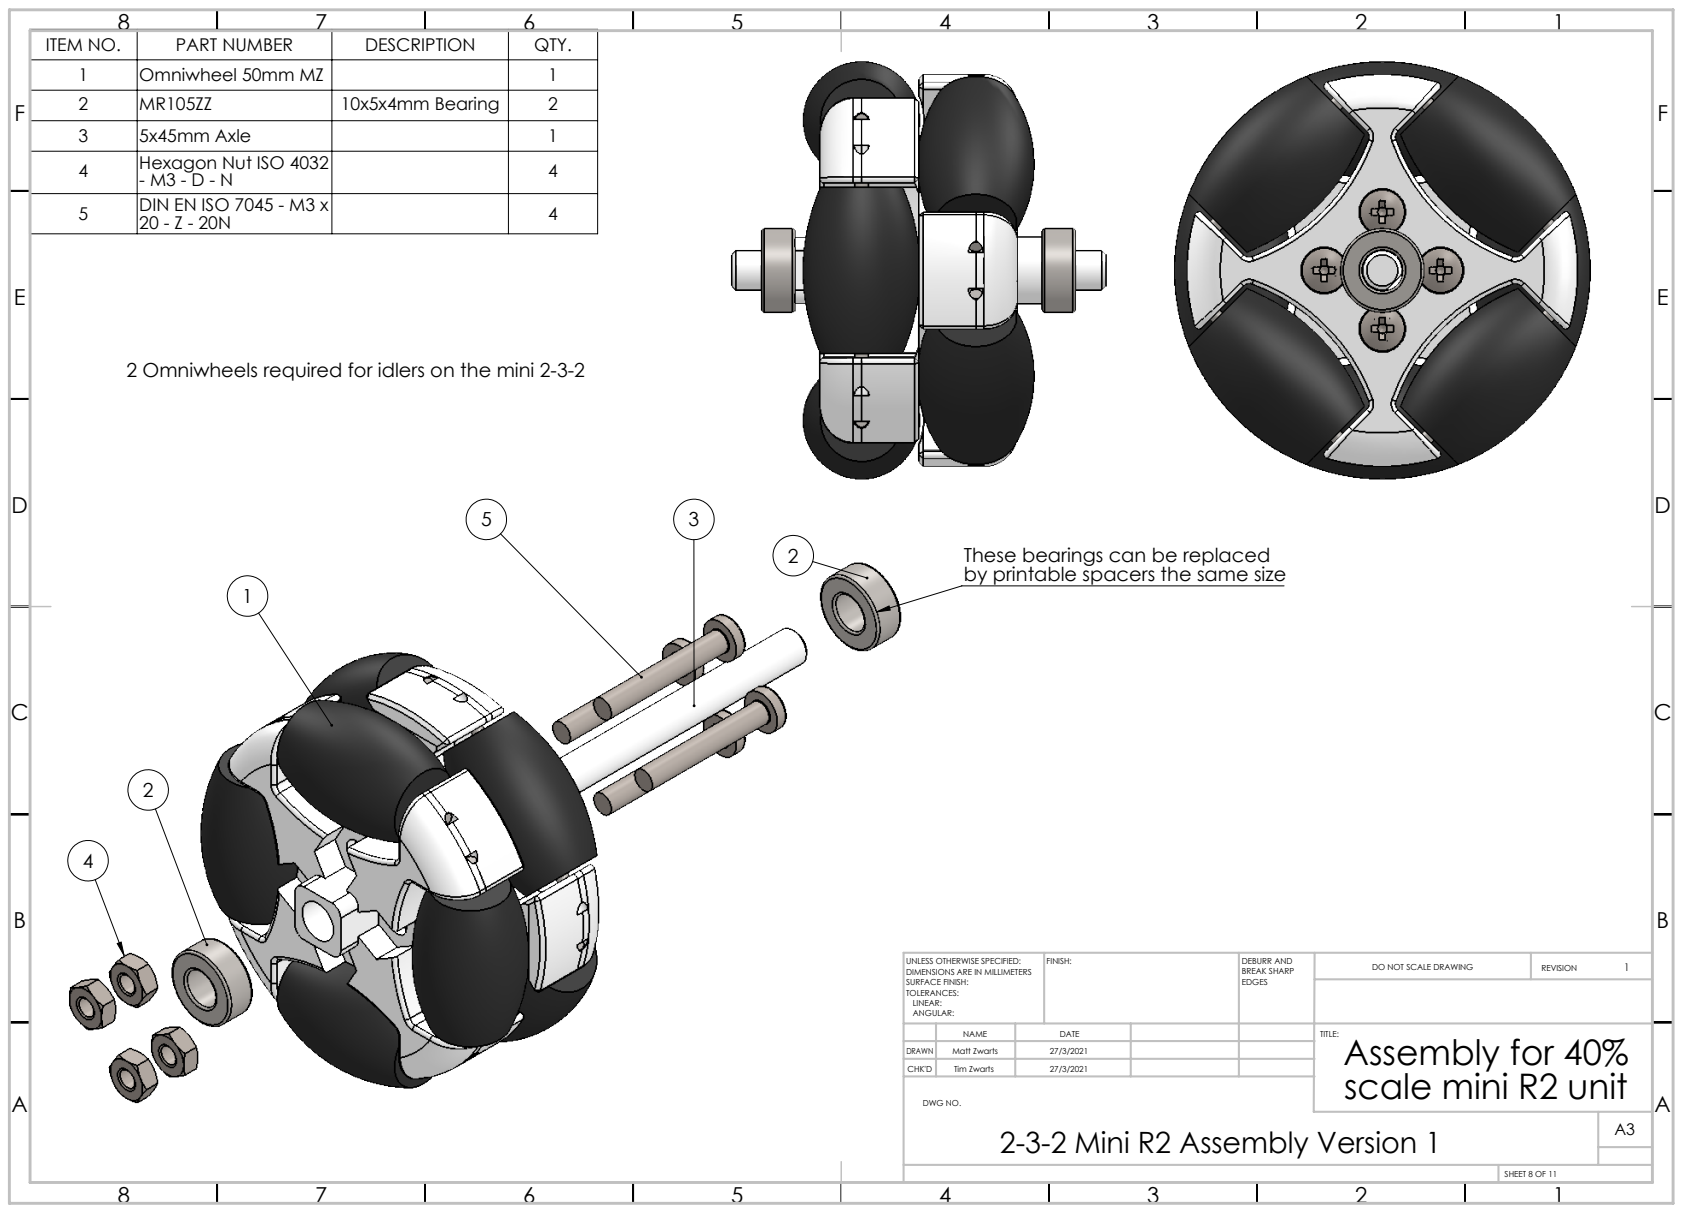
[picture p156: page 8]
FINISH:; DEBURR AND; BREAK SHARP; DO NOT SCALE DRAWING; REVISION; DWG NO.

ITEM NO. | PART NUMBER | DESCRIPTION | QTY.
1 | Omniwheel 50mm MZ | | 1
2 | MR105ZZ | 10x5x4mm Bearing | 2
3 | 5x45mm Axle | | 1
4 | Hexagon Nut ISO 4032 - M3 - D - N | | 4
E | 5 | DIN EN ISO 7045 - M3 x 20 - Z - 20N | | 4 | E

2 Omniwheels required for idlers on the mini 2-3-2

These bearings can be replaced
by printable spacers the same size

UNLESS OTHERWISE SPECIFIED:
DIMENSIONS ARE IN MILLIMETERS
SURFACE FINISH:
TOLERANCES:
LINEAR:
ANGULAR:

NAME | DATE | TITLE: Assembly for 40% scale mini R2 unit

DRAWN | Matt Zwarts | 27/3/2021
CHK'D | Tim Zwarts | 27/3/2021

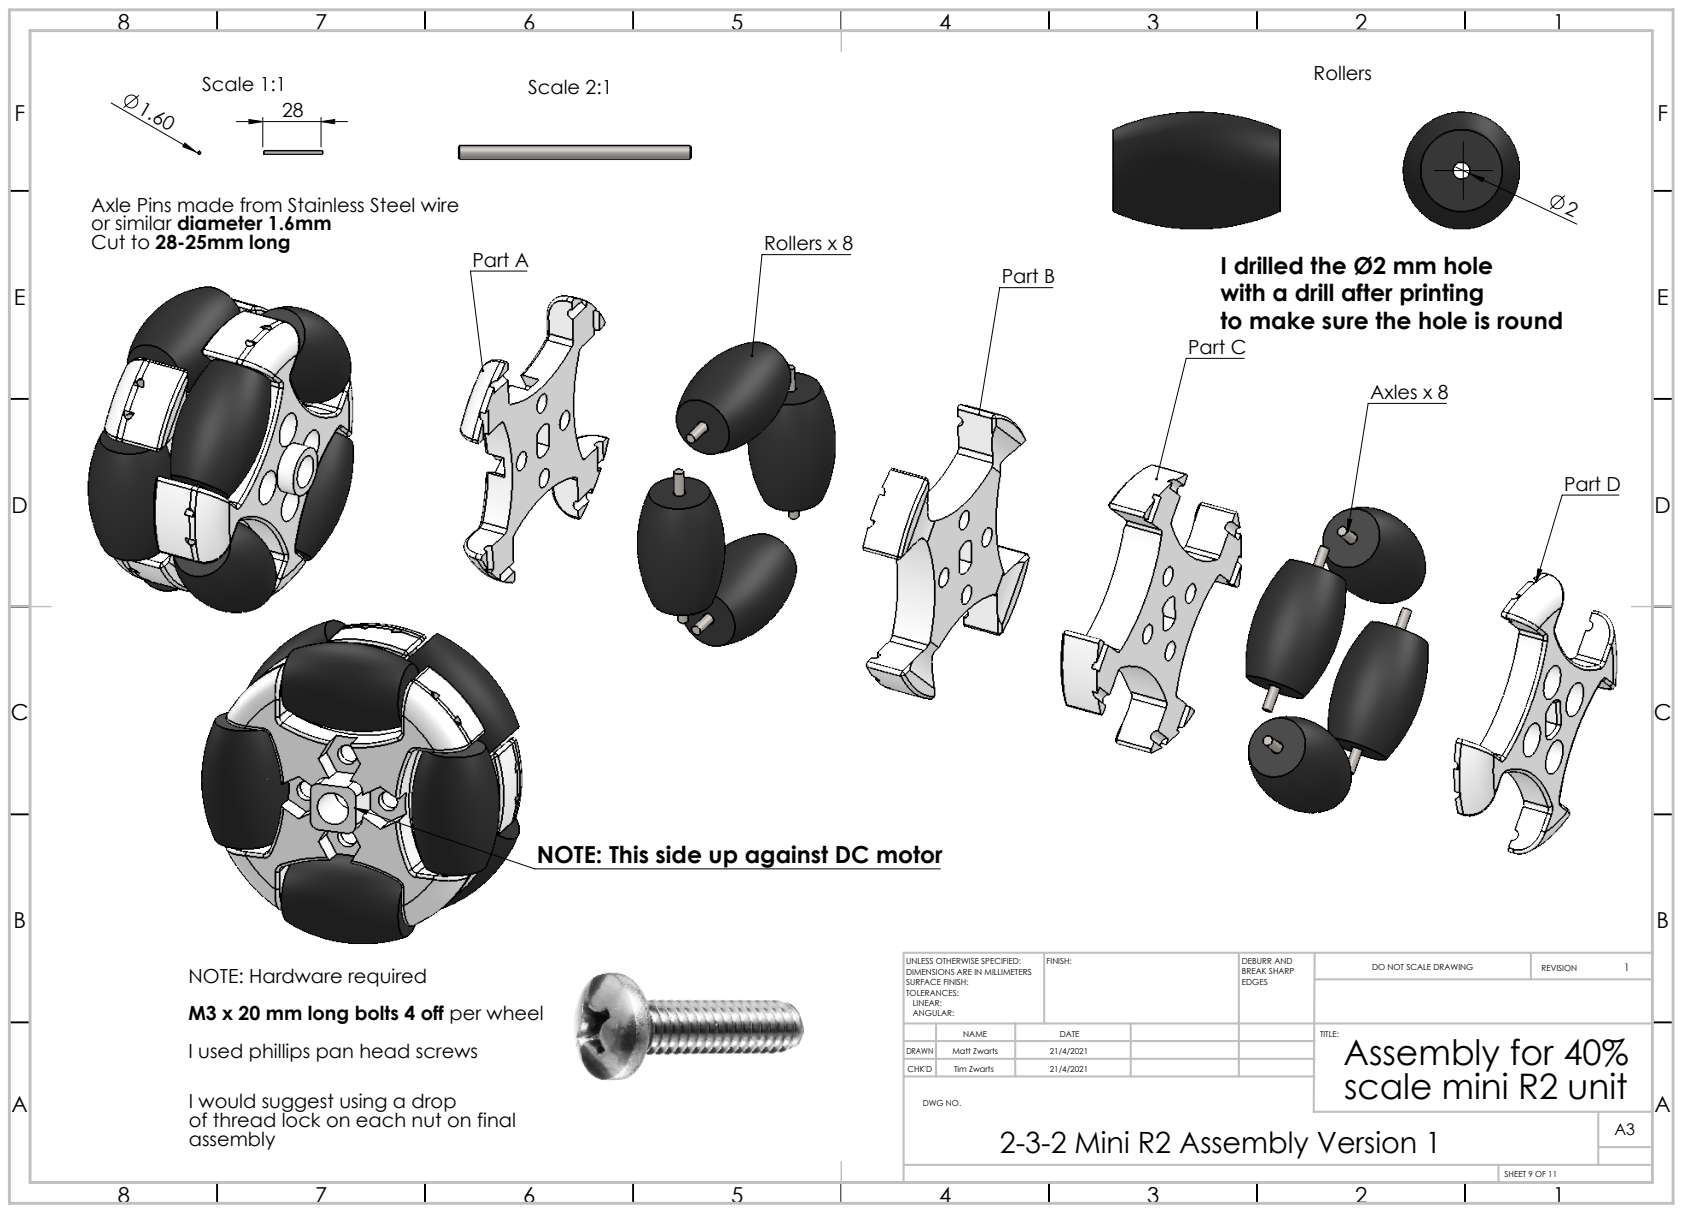
[picture p157: page 9]
Part A; Part B; Part D; Rollers x 8; Axles x 8; Scale 1:1; Scale 2:1; Rollers; FINISH:; DEBURR AND; BREAK SHARP; DO NOT SCALE DRAWING; REVISION; DWG NO.

Axle Pins made from Stainless Steel wire
or similar diameter 1.6mm
Cut to 28-25mm long

I drilled the Ø2 mm hole
with a drill after printing
to make sure the hole is round
Part C

NOTE: This side up against DC motor

UNLESS OTHERWISE SPECIFIED:
DIMENSIONS ARE IN MILLIMETERS
SURFACE FINISH:
TOLERANCES:
LINEAR:
ANGULAR:

NOTE: Hardware required
M3 x 20 mm long bolts 4 off per wheel
I used phillips pan head screws

NAME | DATE | TITLE: Assembly for 40% scale mini R2 unit

DRAWN | Matt Zwarts | 21/4/2021
CHK'D | Tim Zwarts | 21/4/2021

I would suggest using a drop
of thread lock on each nut on final
assembly

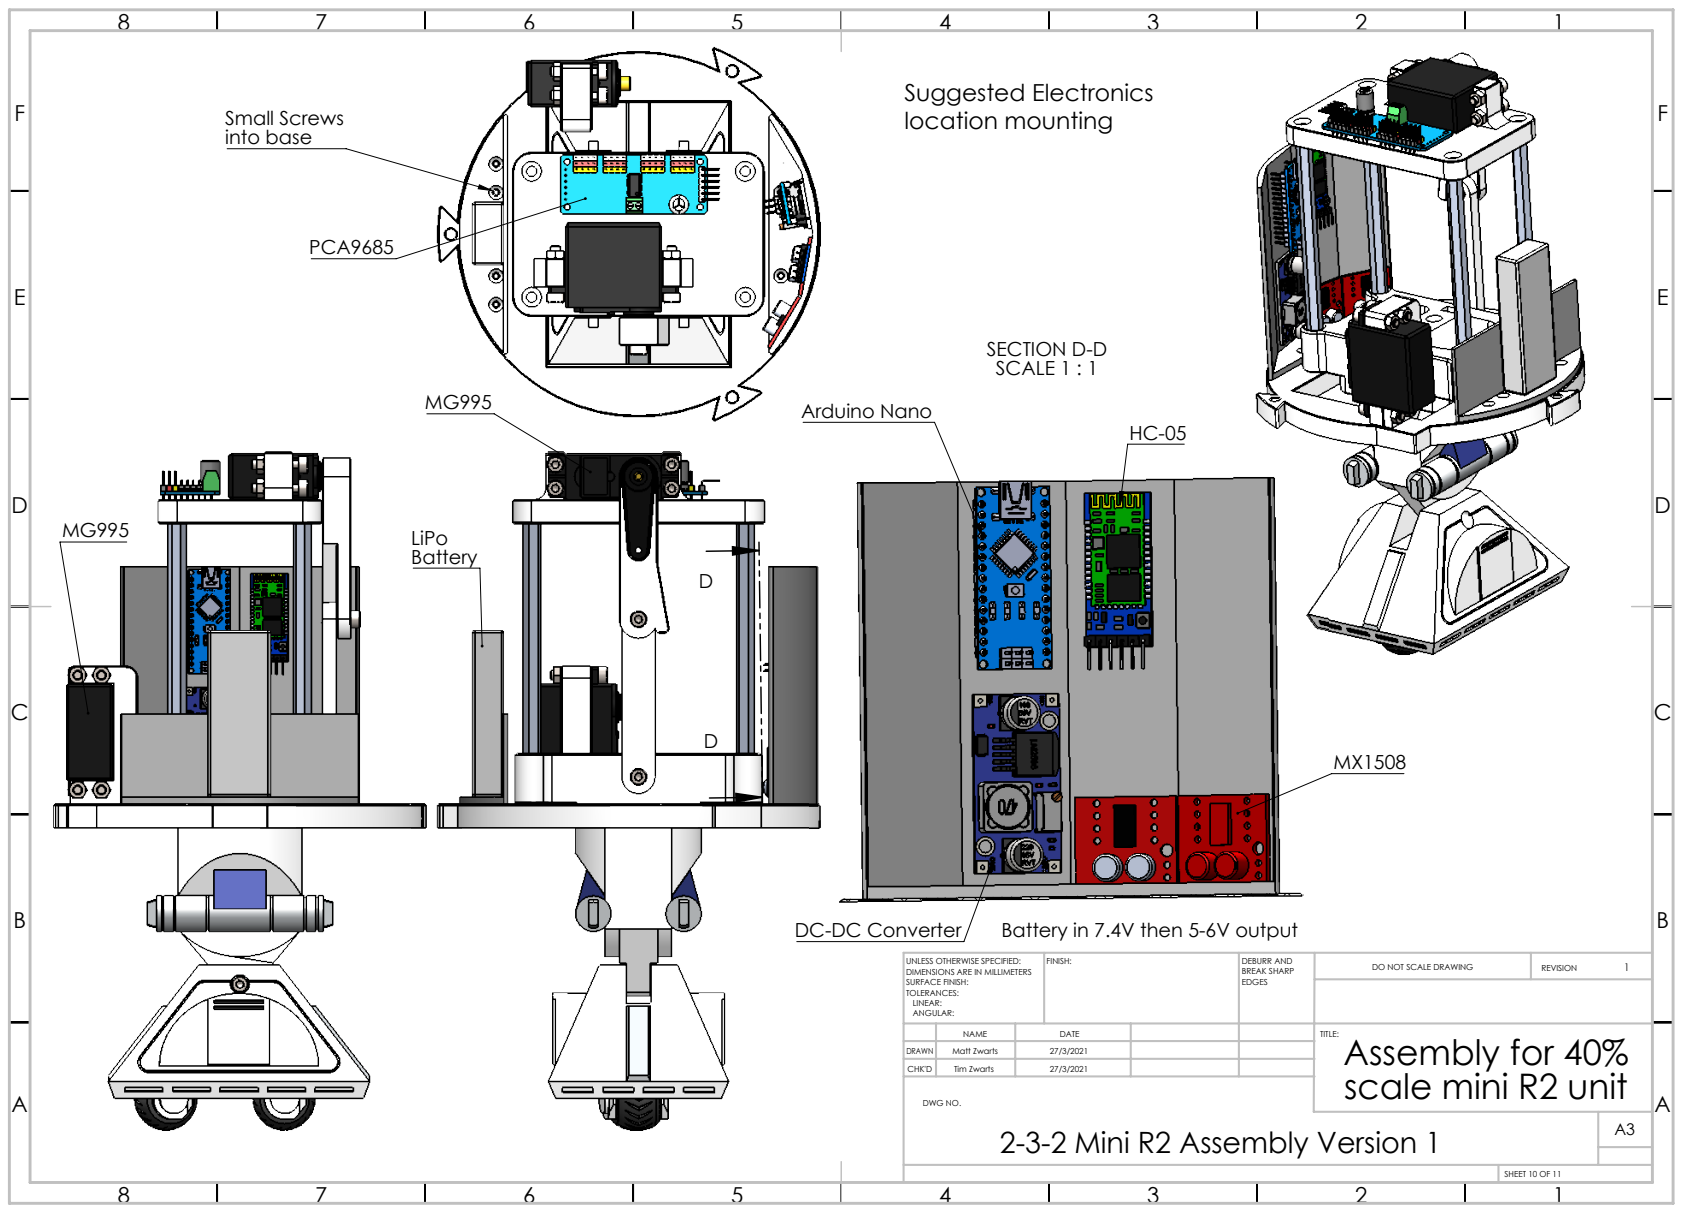
[picture p158: page 10]
Small Screws into base; SECTION D-D SCALE 1 : 1; Arduino Nano; Suggested Electronics location mounting; FINISH:; DEBURR AND; BREAK SHARP; DO NOT SCALE DRAWING; REVISION; DWG NO.

DC-DC Converter

Battery in 7.4V then 5-6V output

UNLESS OTHERWISE SPECIFIED:
DIMENSIONS ARE IN MILLIMETERS
SURFACE FINISH:
TOLERANCES:
LINEAR:
ANGULAR:

NAME | DATE | TITLE: Assembly for 40% scale mini R2 unit

DRAWN | Matt Zwarts | 27/3/2021
CHK'D | Tim Zwarts | 27/3/2021

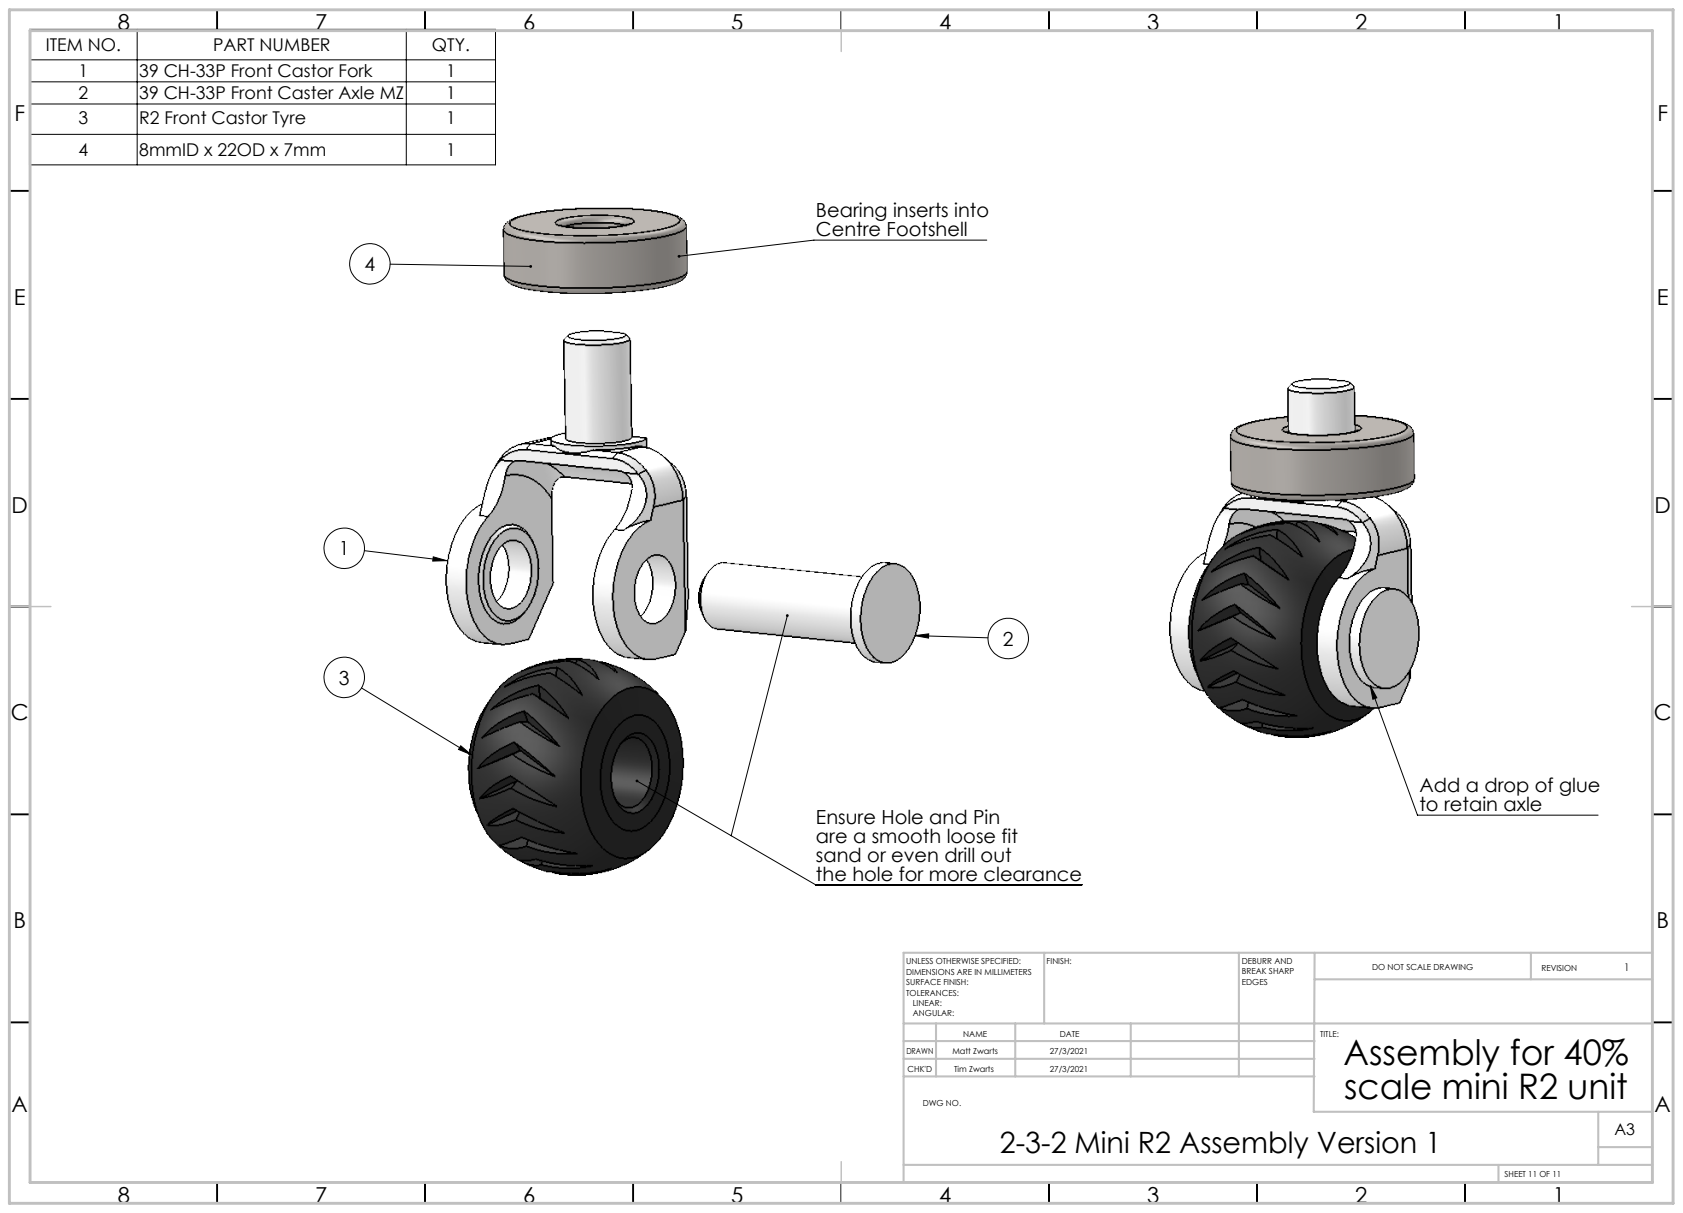
[picture p159: page 11]
FINISH:; DEBURR AND; BREAK SHARP; DO NOT SCALE DRAWING; REVISION; DWG NO.

ITEM NO. | PART NUMBER | QTY.
1 | 39 CH-33P Front Castor Fork | 1
2 | 39 CH-33P Front Caster Axle MZ | 1
3 | R2 Front Castor Tyre | 1
4 | 8mmID x 22OD x 7mm | 1

Bearing inserts into
Centre Footshell

Add a drop of glue

to retain axle Ensure Hole and Pin
are a smooth loose fit
sand or even drill out
the hole for more clearance

UNLESS OTHERWISE SPECIFIED:
DIMENSIONS ARE IN MILLIMETERS
SURFACE FINISH:
TOLERANCES:
LINEAR:
ANGULAR:

NAME | DATE | TITLE: Assembly for 40% scale mini R2 unit

DRAWN | Matt Zwarts | 27/3/2021
CHK'D | Tim Zwarts | 27/3/2021
