tekfufu/mini-R2D2/Mini 2-3-2 R2-D2/Drawings, Assembly _ Code/Mini Droid Electronics Assembly Matt Zwarts.PDF

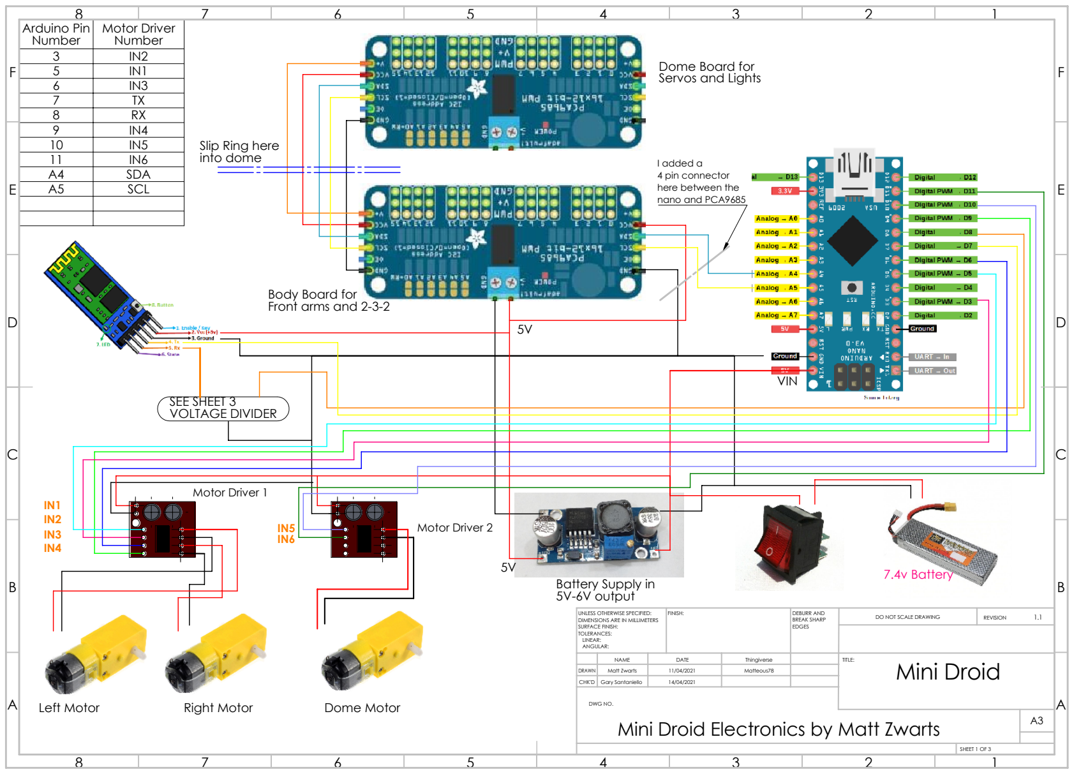
[picture p173: page 1]
Motor Driver 1; Motor Driver 2; SEE SHEET 3 VOLTAGE DIVIDER; Left Motor; Right Motor; Dome Motor; 7.4v Battery; FINISH:; DEBURR AND; BREAK SHARP; DO NOT SCALE DRAWING; REVISION; SHEET 1 OF 3

Arduino Pin Number | Motor Driver Number
3 | IN2
5 | IN1
6 | IN3
7 | TX
8 | RX
10 | IN5
11 | IN6
A4 | SDA
A5 | SCL

Dome Board for
Servos and Lights

Slip Ring here
into dome

I added a
4 pin connector
here between the
nano and PCA9685

Body Board for
Front arms and 2-3-2

Battery Supply in
5V-6V output

UNLESS OTHERWISE SPECIFIED:
DIMENSIONS ARE IN MILLIMETERS
SURFACE FINISH:
TOLERANCES:
LINEAR:
ANGULAR:

NAME | DATE | Thingiverse | TITLE: Mini Droid

DRAWN | Matt Zwarts | 11/04/2021 | Matteous78
CHK'D | Gary Santaniello | 14/04/2021

DWG NO.
Mini Droid Electronics by Matt Zwarts

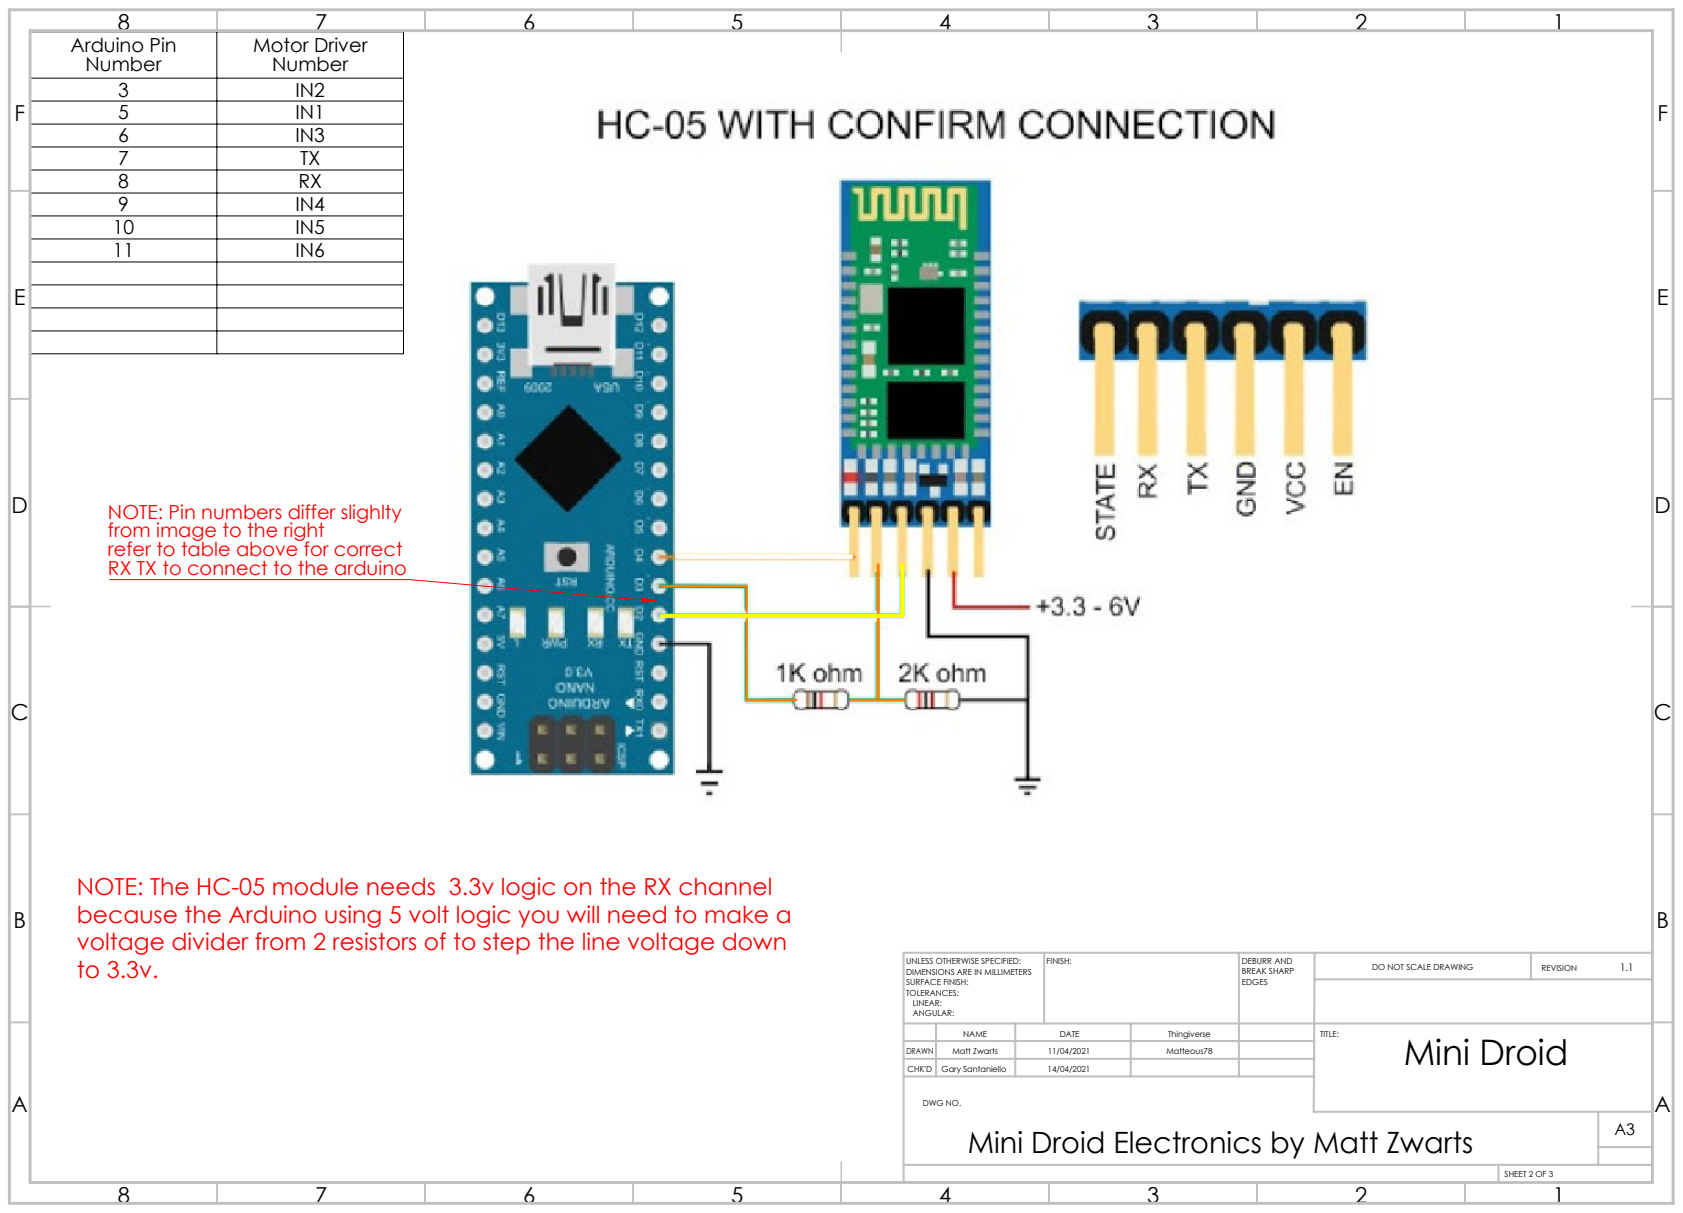
[picture p174: page 2]
FINISH:; DEBURR AND; BREAK SHARP; DO NOT SCALE DRAWING; REVISION; DWG NO.

Arduino Pin Number | Motor Driver Number
3 | IN2
5 | IN1
6 | IN3
7 | TX
8 | RX
10 | IN5
11 | IN6

NOTE: Pin numbers differ slighlty
from image to the right
refer to table above for correct
RX TX to connect to the arduino

NOTE: The HC-05 module needs 3.3v logic on the RX channel
because the Arduino using 5 volt logic you will need to make a
voltage divider from 2 resistors of to step the line voltage down

UNLESS OTHERWISE SPECIFIED:
DIMENSIONS ARE IN MILLIMETERS
SURFACE FINISH:
TOLERANCES:
LINEAR:
ANGULAR:

NAME | DATE | Thingiverse | TITLE: Mini Droid

DRAWN | Matt Zwarts | 11/04/2021 | Matteous78
CHK'D | Gary Santaniello | 14/04/2021

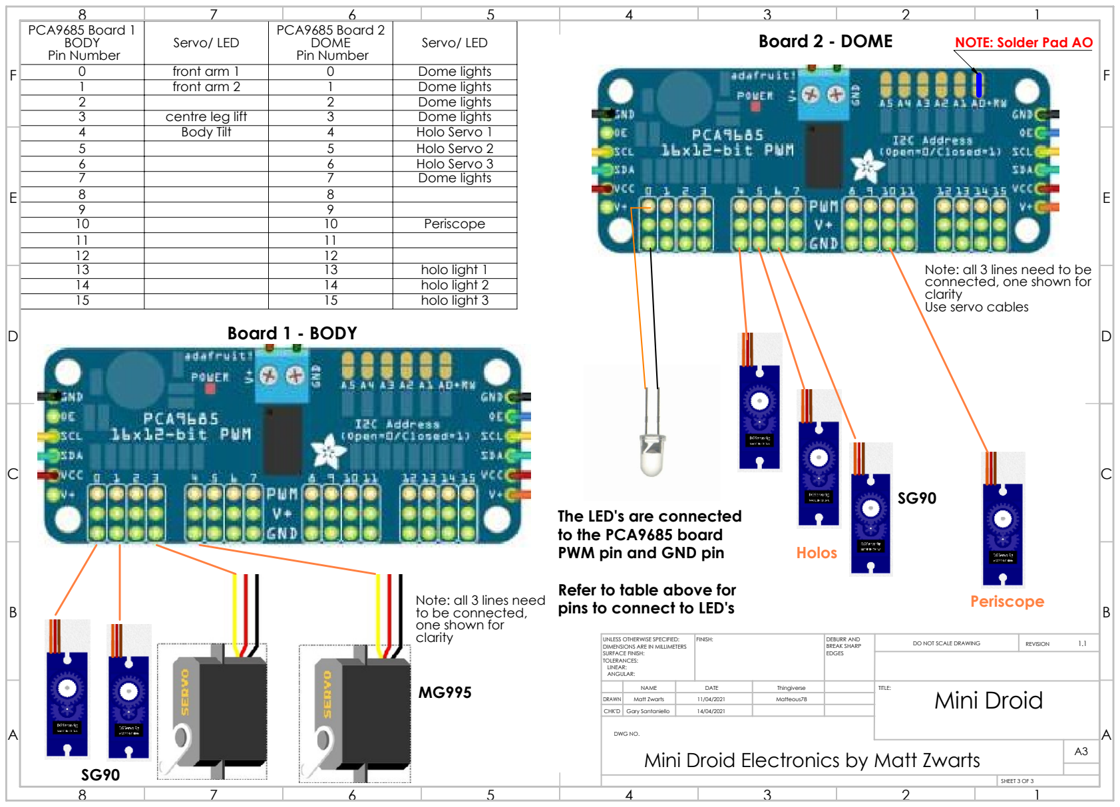
[picture p175: page 3]
Board 1 - BODY; Board 2 - DOME; NOTE: Solder Pad AO; pins to connect to LED's; Periscope; FINISH:; DEBURR AND; BREAK SHARP; DO NOT SCALE DRAWING; REVISION; DWG NO.

PCA9685 Board 1 BODY Pin Number | Servo/ LED | PCA9685 Board 2 DOME Pin Number | Servo/ LED

0 | front arm 1 | 0 | Dome lights
1 | front arm 2 | 1 | Dome lights
2 | | 2 | Dome lights
3 | centre leg lift | 3 | Dome lights
5 | | 5 | Holo Servo 2
6 | | 6 | Holo Servo 3
7 | | 7 | Dome lights
10 | | 10 | Periscope
11 | | 11
12 | | 12
13 | | 13 | holo light 1
14 | | 14 | holo light 2
15 | | 15 | holo light 3

E | 4 | Body Tilt | 4 | Holo Servo 1 | E

Note: all 3 lines need to be
connected, one shown for
clarity
Use servo cables

The LED's are connected
to the PCA9685 board
PWM pin and GND pin
Refer to table above for

Note: all 3 lines need
to be connected,
one shown for

UNLESS OTHERWISE SPECIFIED:
DIMENSIONS ARE IN MILLIMETERS
SURFACE FINISH:
TOLERANCES:
LINEAR:
ANGULAR:

NAME | DATE | Thingiverse | TITLE: Mini Droid

DRAWN | Matt Zwarts | 11/04/2021 | Matteous78
CHK'D | Gary Santaniello | 14/04/2021
