tekfufu/mini-R2D2/Mini 2-3-2 R2-D2/Drawings, Assembly _ Code/R2D2 2-3-2 - Amazon.com.pdf

### Mini Astromech

Title | Comments Price Quantity Has
Step-Down Power Module , Buck Converter Step Down Voltage Regulator Module 5-16V To
1.25V/1.5V/1.8V/2.5V/3.3V/5V Adjustable Step-Down Power Module Voltage Converter Board
- | 2 | 2

Maxmoral 2pcs MG90S 9g Metal Gear Micro Tower Pro Servo Upgraded SG90 Digital Micro Servos for RC Vehicle Helicopter Boat Car Models
Offered by Maxmoral.
$9.99 | 2 | 2

M6-1.0 x 8mm Socket Head Cap Screws Metric, Allen Socket Drive, Stainless Steel 18-8 (304), DIN 912, Bright Finish, Fully Threaded, 20 PCS
Offered by MewuDecor Online.
$5.99 | 1 | 0

Taidacent Mini Cap Conductive Slip Ring DIY Handheld PTZ Collector Ring Rotating Electrical Contact Connector Small Slip Ring (OD6.5mm 6way 1A)
Offered by Shenzhen Taida Century Technology Co.,Ltd..
$18.98 | 1 | 1

ELEGOO Nano Board CH340/ATmega328P Without USB Cable, Compatible with Arduino Nano V3.0 (Nano x 3 Without Cable)
Offered by ELEGOO Official US.
$15.99 | 1 | 0

uxcell Hex Nuts, M6x1mm Metric Coarse Thread Hexagon Nut, Carbon Steel, Pack of 50 (Black)
Offered by uxcell.
$7.49 | 1 | 0

20 Gauge Silicone JST Connector, SIM&NAT 5.9 inch 2 Pin Male Female JST RCY Plug Connectors Cable Wire for LED Lamp Strip RC Toys Battery (10 Pair)
Offered by SIM&NAT Direct.
$8.69 | 1 | 0

M4 Spring Hex Socket Ball Point Grub Set Screws Stainless Steel 20pcs (M4 x 6mm)
Offered by H&H Trade.
$7.59 | 1 | 0

OliYin 20pcs 5.90in 15cm 150mm 26AWG JR Male to Male RC Servo Extension Lead Cord Plug Servo Extend Cable for Helicopter Quadcopter
Offered by Olivia Technology Co.,Ltd.
$9.68 | 1 | 1

M6-1.0 x 35mm Socket Head Cap Screws Metric, Allen Socket Drive, Stainless Steel 18-8 (304), Full Thread, Bright Finish, Machine Thread, 20 PCS
Offered by MewuDecor Online.
$9.49 | 1 | 1

Yeeco 4PCS DC Electric Motor 3V-6V Dual Shaft Geared TT Magnetic Gearbox Engine 1:120 Reduction Ratio for DIY Robot Cars Chassis Models Vibration Products

- | 1 | 1

Ximimark PCA9685 16 Channel 12-Bit PWM Servo Motor Driver IIC Module for Arduino Robot,2Pcs
Offered by Xie QianJin.
$8.29 | 1 | 1

uxcell 624ZZ Ball Bearing 4mm x 13mm x 5mm Double Shielded 624-2Z 80024 Deep Groove Bearings, Carbon Steel (Pack of 4)
Offered by uxcell.
$5.19 | 1 | 0

Dmyond DC Motor Driver MX1508 Mini Dual Channel 10pcs 1.5A L298N PWM Speed Controller Dual H-Bridge Replace Stepper
Offered by Dmyond-us.
$13.99 | 1 | 1

FEETECH FS90R (5 Pack) - 360 Degree Continuous Rotation Servo 9g for Robotic Helicopter Airplane Boat
Offered by S-snail.
$22.99 | 1 | 1

M6-1.0 x 25mm Socket Head Cap Screws Metric, Allen Socket Drive, 304 Stainless Steel (A2-70), Full Thread, Bright Finish, Machine Thread, Quantity 50
Offered by KONGKI SCREWS.
$12.99 | 1 | 0

Blomiky 2 Pack H101 7.4V 2S 1500mAh Battery with SM 2P Plug and USB Charger Cable for T2 H105 H103 H101 Remote Control RC Boat H101 Battery and USB 2
Offered by Blomiky.
$24.99 | 1 | 1

uxcell a15062500ux0349 Right Angle Single Row 40-pin 2.54mm Male Header for Breadboard (Pack of 10)
Offered by Amazon.com.
$11.52 | 1 | 0

60PCS 2/3/4/5 Conductor Compact Splicing wire Connectors Assortment Kits for Electrical Solid Stranded Flexible Wires
Offered by TorKettle &Taukealugs Direct..
$18.49 | 1 | 1

Cutequeen 31 Values 1% 775 pcs,RoHS Compliant Resistor Kit x 25pcs =775 pcs (0 Ohm - 1M Ohm) 1/4W Metal Film Resistors Assortment
Offered by CuteQueen.
$4.99 | 1 | 1

CO RODE RGB LED, 3mm 5mm LED Diode Light Kit with Color White Red Blue Green Yellow UV, Fast, Slow Flashing, RGB
Offered by CO-RODE.
$13.99 | 1 | 1

URBEST5 Pcs AC 125V/6A 2 Position On/On SPDT 3 Pins Single Pole Double Throw Mini Toggle Switch
Offered by URBEST (R).
$6.99 | 1 | 1

DORHEA HC-05 Wireless Bluetooth Receiver RF Serial Transceiver Module Master Slave Integrated Bluetooth Module

### 6 Pin Wireless Serial Port Communication BT Module for - 5PCS

Offered by Dorhea.

$19.99 | 1 | 0
