tekfufu/mini-R2D2/Mini 2-3-2 R2-D2/Resin Print Cut by Christophe Kormann/3.jpg

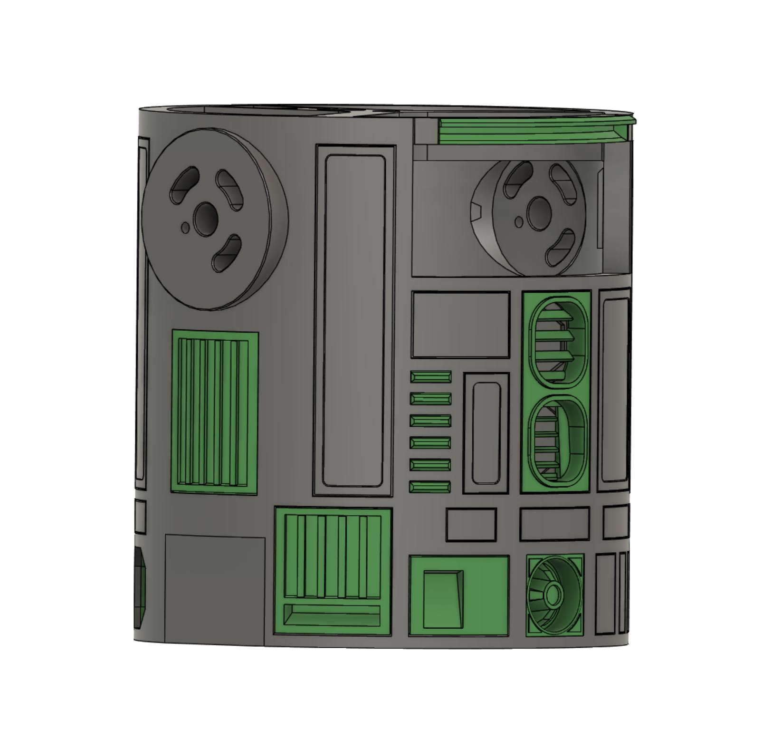
Mini 2-3-2 R2-D2/Resin Print Cut by Christophe Kormann/3.jpg
