tekfufu/mini-R2D2/Phone App and Arduino Code/Choppy-Cheep Electronics Assembly Matt Zwarts Rev 1.1.PDF

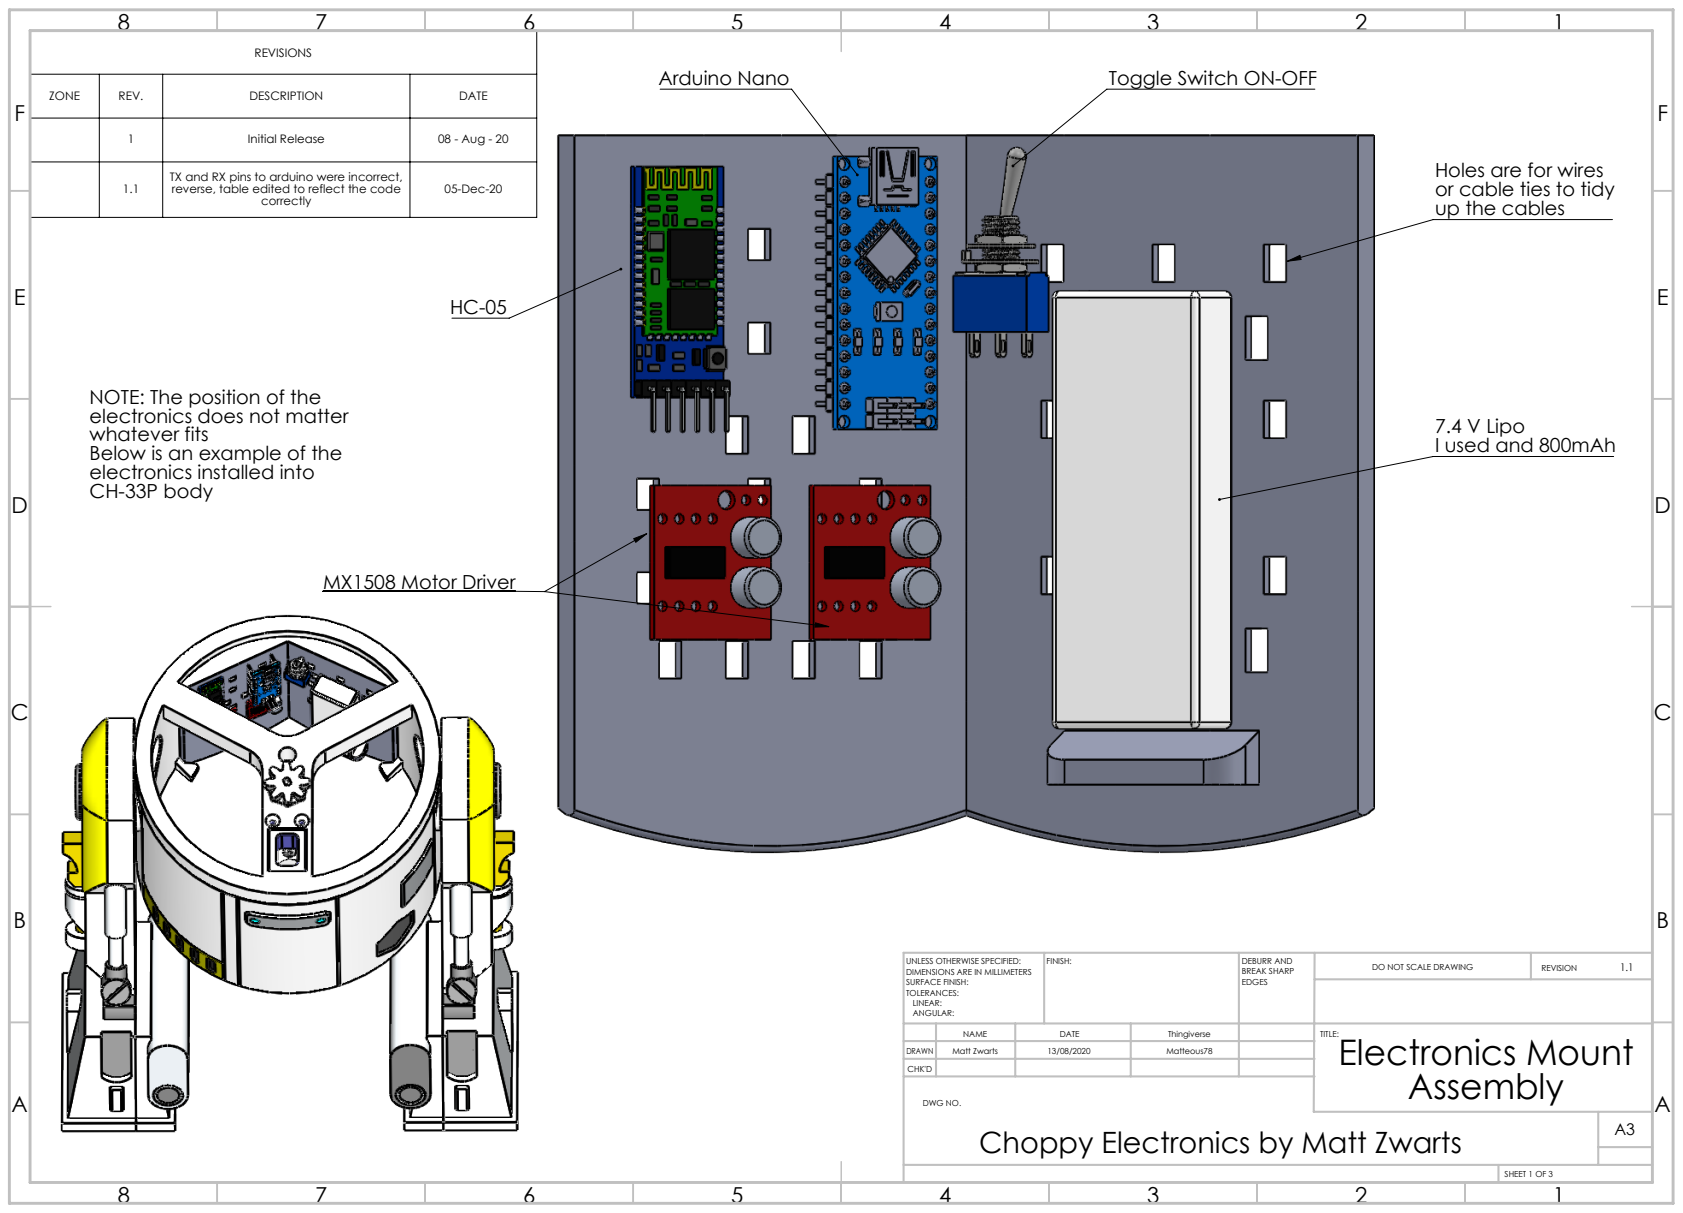
[picture p202: page 1]
MX1508 Motor Driver; 7.4 V Lipo I used and 800mAh; Arduino Nano; Toggle Switch ON-OFF; FINISH:; DEBURR AND; BREAK SHARP; DO NOT SCALE DRAWING; REVISION; SHEET 1 OF 3

REVISIONS

ZONE | REV. | DESCRIPTION | DATE

1 | Initial Release | 08 - Aug - 20

Holes are for wires
or cable ties to tidy
up the cables

1.1 | TX and RX pins to arduino were incorrect, reverse, table edited to reflect the code correctly | 05-Dec-20

NOTE: The position of the
electronics does not matter
whatever fits
Below is an example of the
electronics installed into
CH-33P body

UNLESS OTHERWISE SPECIFIED:
DIMENSIONS ARE IN MILLIMETERS
SURFACE FINISH:
TOLERANCES:
LINEAR:
ANGULAR:

NAME | DATE | Thingiverse | TITLE: Electronics Mount Assembly

DRAWN | Matt Zwarts | 13/08/2020 | Matteous78
CHK'D

DWG NO.
Choppy Electronics by Matt Zwarts

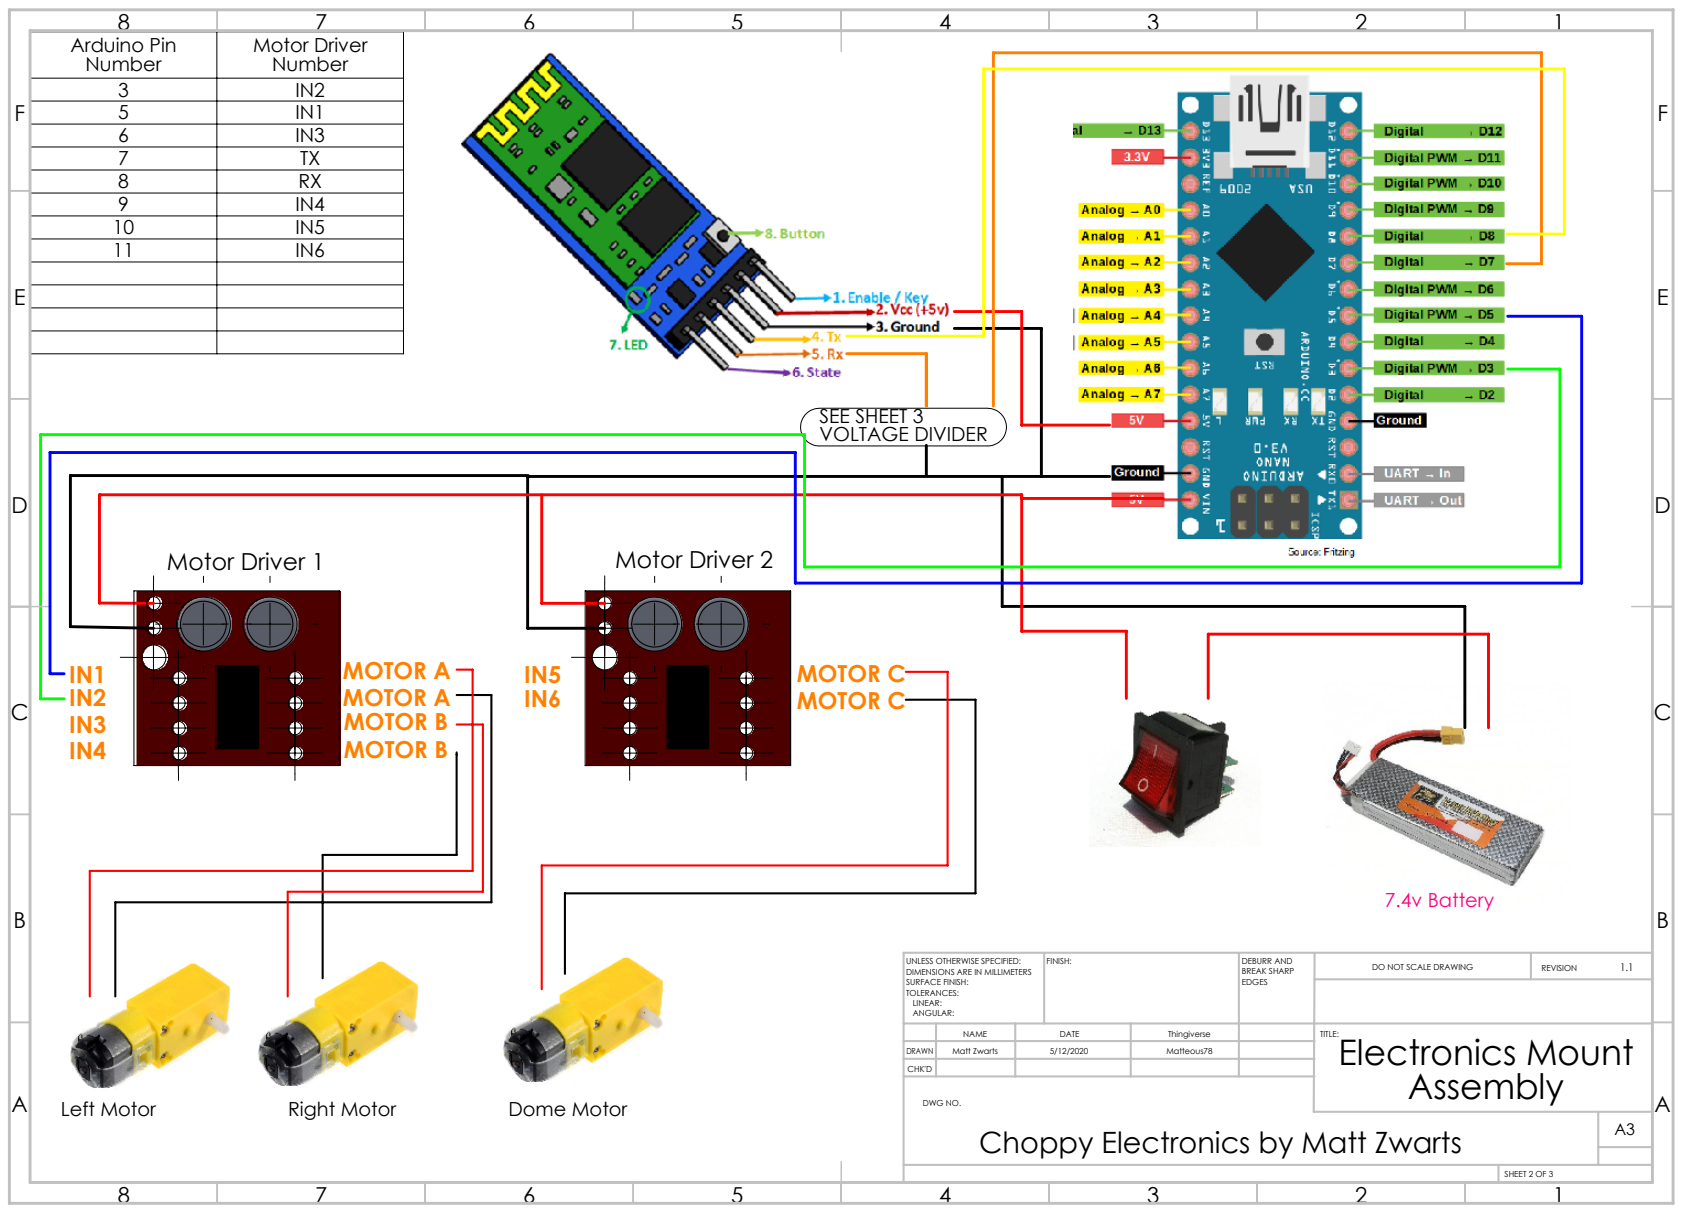
[picture p203: page 2]
Motor Driver 1; Motor Driver 2; SEE SHEET 3 VOLTAGE DIVIDER; MOTOR B MOTOR B; MOTOR A MOTOR A; MOTOR C; Left Motor; Right Motor; Dome Motor; 7.4v Battery; FINISH:; DEBURR AND; BREAK SHARP; DO NOT SCALE DRAWING; REVISION; DWG NO.

Arduino Pin Number | Motor Driver Number
3 | IN2
5 | IN1
6 | IN3
7 | TX
8 | RX
10 | IN5
11 | IN6

UNLESS OTHERWISE SPECIFIED:
DIMENSIONS ARE IN MILLIMETERS
SURFACE FINISH:
TOLERANCES:
LINEAR:
ANGULAR:

NAME | DATE | Thingiverse | TITLE: Electronics Mount Assembly

DRAWN | Matt Zwarts | 5/12/2020 | Matteous78
CHK'D

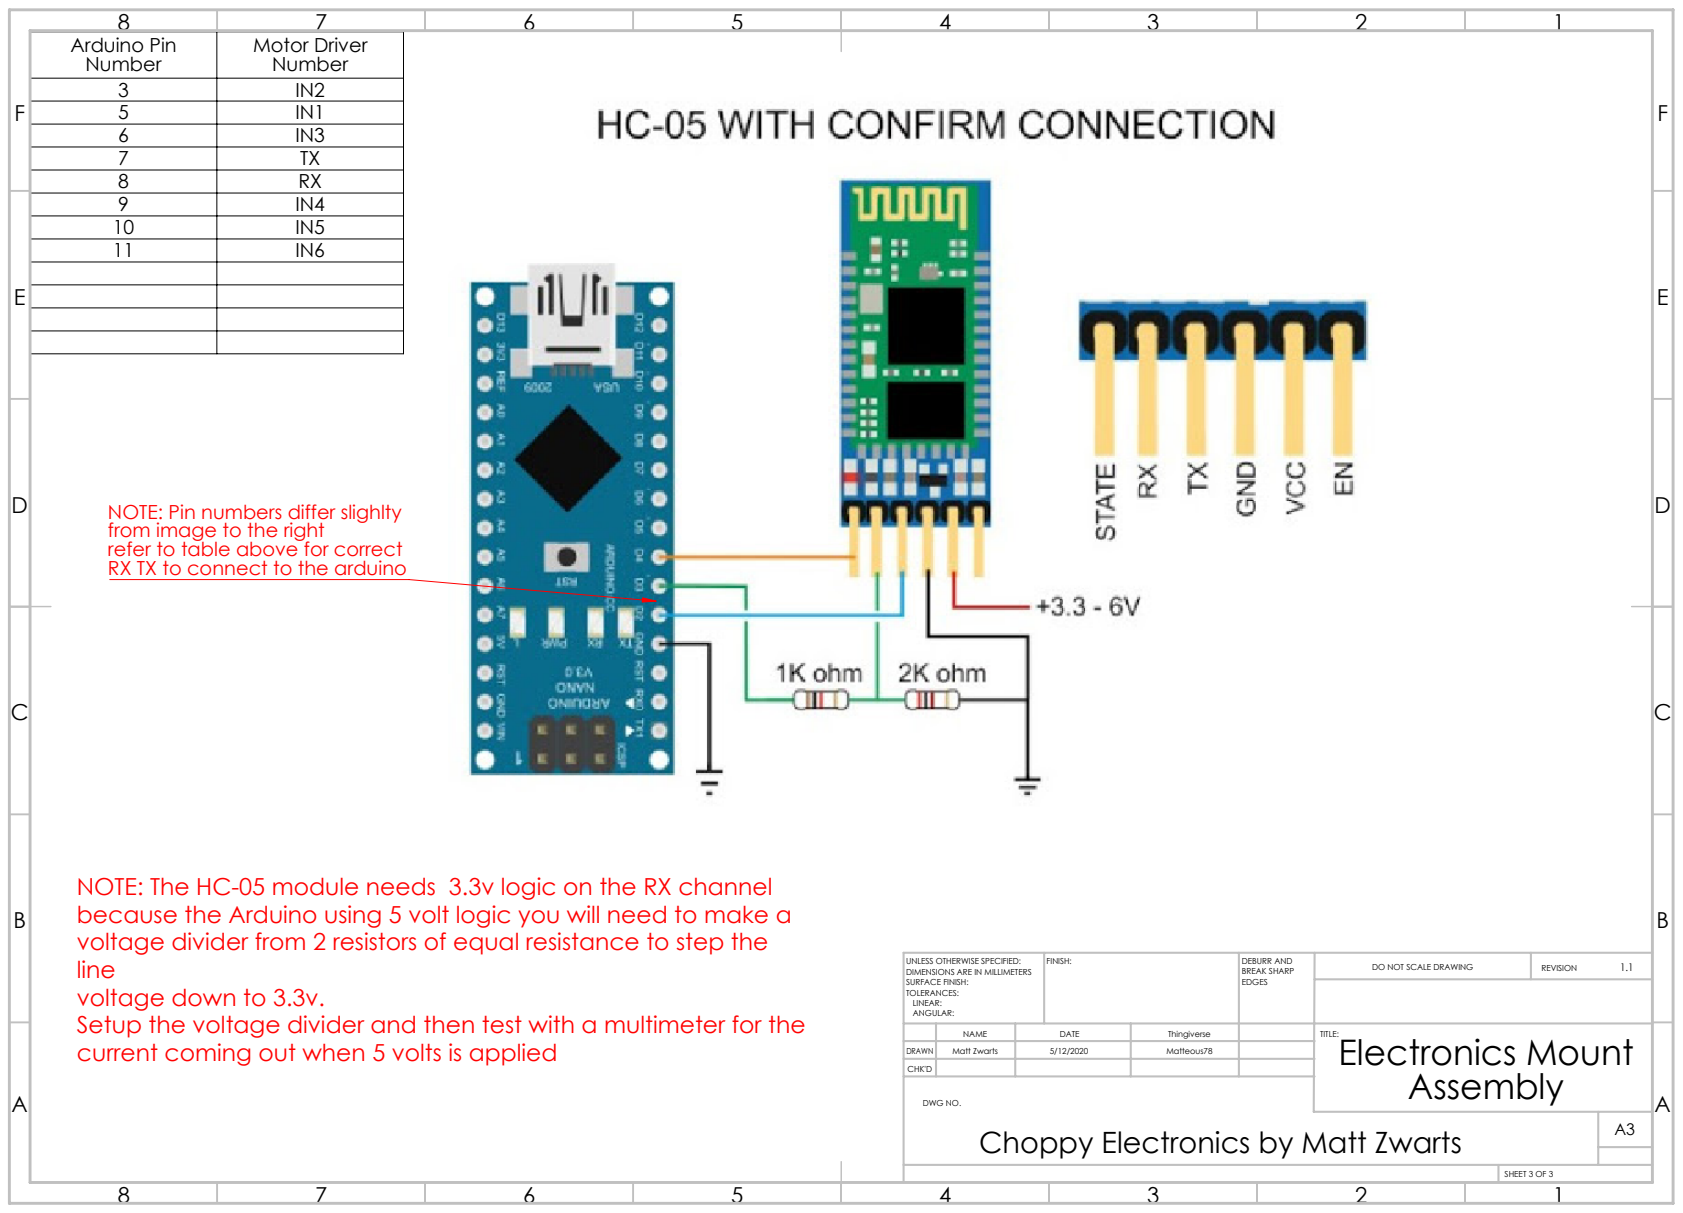
[picture p204: page 3]
FINISH:; DEBURR AND; BREAK SHARP; DO NOT SCALE DRAWING; REVISION; DWG NO.

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

NOTE: Pin numbers differ slighlty
from image to the right
refer to table above for correct
RX TX to connect to the arduino

NOTE: The HC-05 module needs 3.3v logic on the RX channel
because the Arduino using 5 volt logic you will need to make a
voltage divider from 2 resistors of equal resistance to step the
line
voltage down to 3.3v.
Setup the voltage divider and then test with a multimeter for the
current coming out when 5 volts is applied

UNLESS OTHERWISE SPECIFIED:
DIMENSIONS ARE IN MILLIMETERS
SURFACE FINISH:
TOLERANCES:
LINEAR:
ANGULAR:

NAME | DATE | Thingiverse | TITLE: Electronics Mount Assembly

DRAWN | Matt Zwarts | 5/12/2020 | Matteous78
CHK'D
