tekfufu/mini-R2D2/RC Control Code/RC Control Mini Droid Electronics Assembly Matt Zwarts.PDF

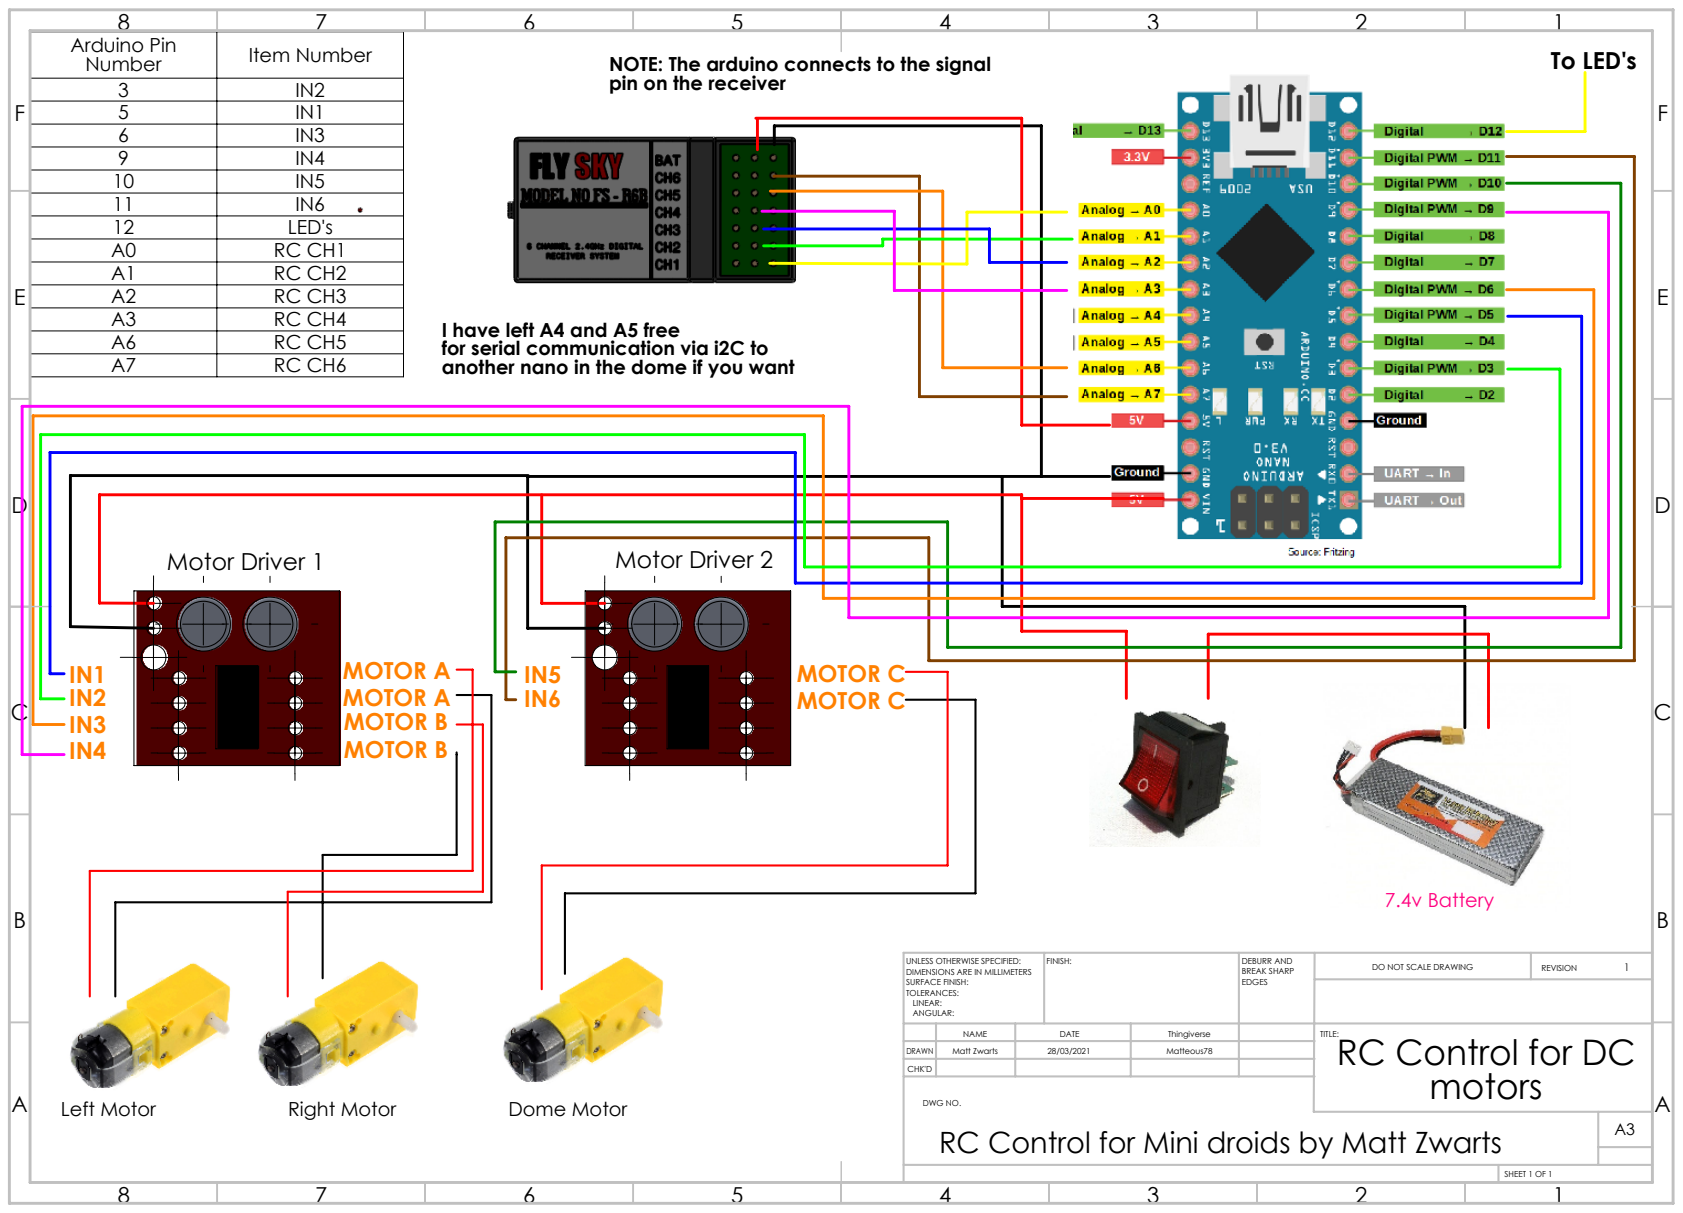
[picture p205: page 1]
Motor Driver 1; Motor Driver 2; To LED's; MOTOR B MOTOR B; MOTOR A MOTOR A; MOTOR C; Left Motor; Right Motor; Dome Motor; 7.4v Battery; FINISH:; DEBURR AND; BREAK SHARP; DO NOT SCALE DRAWING; REVISION; SHEET 1 OF 1

Arduino Pin Number | Item Number | NOTE: The arduino connects to the signal
3 | IN2
5 | IN1
6 | IN3
9 | IN4
10 | IN5
12 | LED's
A0 | RC CH1
A1 | RC CH2
A2 | RC CH3
A3 | RC CH4
A6 | RC CH5
A7 | RC CH6

pin on the receiver

I have left A4 and A5 free
for serial communication via i2C to
another nano in the dome if you want

UNLESS OTHERWISE SPECIFIED:
DIMENSIONS ARE IN MILLIMETERS
SURFACE FINISH:
TOLERANCES:
LINEAR:
ANGULAR:

NAME | DATE | Thingiverse | TITLE: RC Control for DC motors

DRAWN | Matt Zwarts | 28/03/2021 | Matteous78
CHK'D

DWG NO.
RC Control for Mini droids by Matt Zwarts
