tekfufu/mini-R2D2/Mini R2/Moveable Holos/Mini R2 Moveable Holo Assembly Version 1.PDF

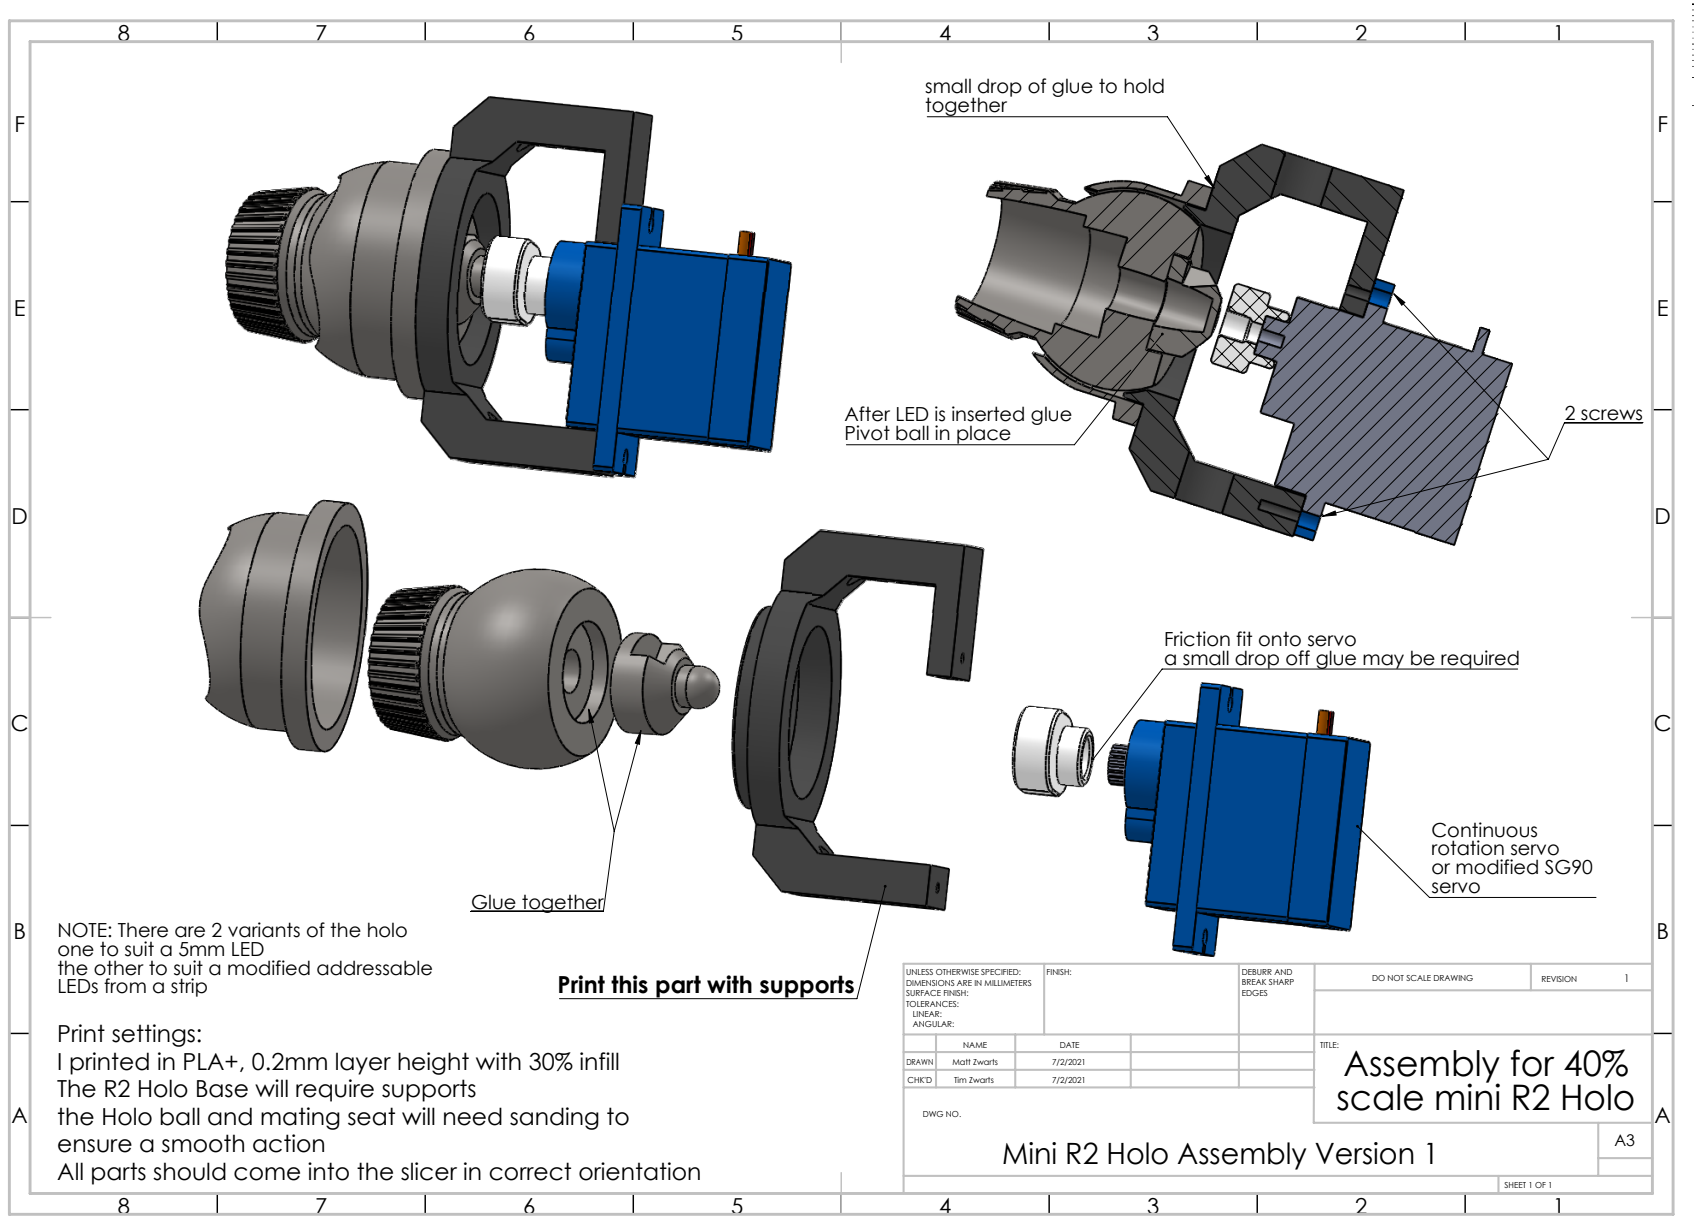
[picture p206: page 1]
rotation servo or modified SG90; Glue together; LEDs from a strip; Print this part with supports; After LED is inserted glue; 2 screws; FINISH:; DEBURR AND; BREAK SHARP; DO NOT SCALE DRAWING; REVISION; SHEET 1 OF 1

small drop of glue to hold
together

Pivot ball in place

Friction fit onto servo
a small drop off glue may be required

NOTE: There are 2 variants of the holo
one to suit a 5mm LED
the other to suit a modified addressable
Print settings:
I printed in PLA+, 0.2mm layer height with 30% infill
The R2 Holo Base will require supports
the Holo ball and mating seat will need sanding to
ensure a smooth action
All parts should come into the slicer in correct orientation

UNLESS OTHERWISE SPECIFIED:
DIMENSIONS ARE IN MILLIMETERS
SURFACE FINISH:
TOLERANCES:
LINEAR:
ANGULAR:

NAME | DATE | TITLE: Assembly for 40% scale mini R2 Holo

DRAWN | Matt Zwarts | 7/2/2021
CHK'D | Tim Zwarts | 7/2/2021

DWG NO.
Mini R2 Holo Assembly Version 1
