tekfufu/mini-R2D2/Mini R2/R2 Dome with LED lights/Logic Panels.PDF

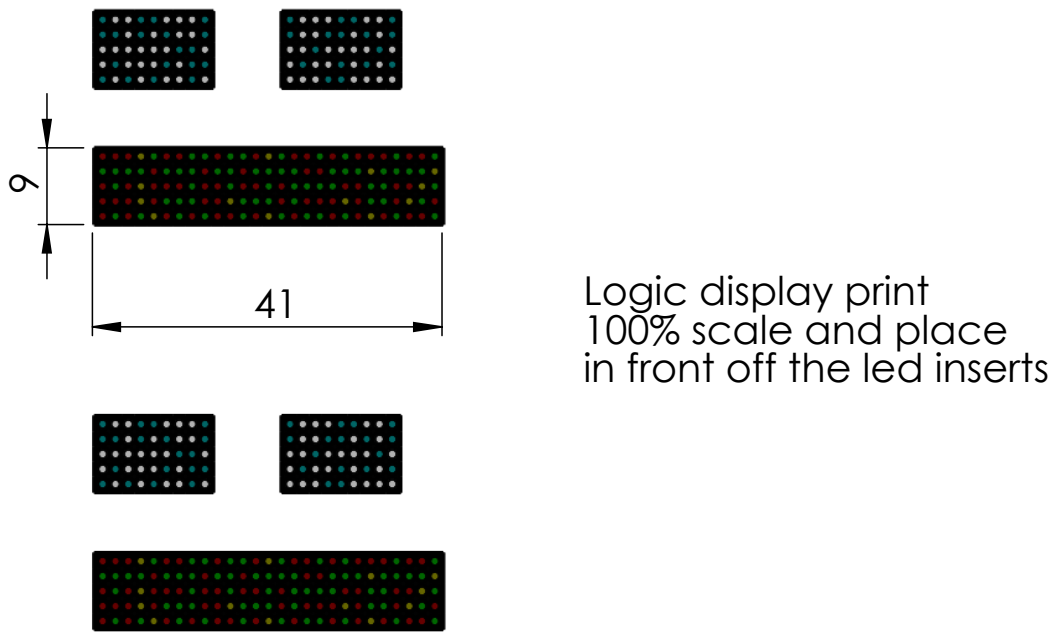
[picture p207: page 1]
Logic display print

100% scale and place
in front off the led inserts
